tim7376875/Industry-university-coope-Stepper-motor-drive-circuit-design-and-controlration-/03 韌體控制程式/02 第二季/07 P32_馬達正轉360度(30rpm)/07 P32_馬達正轉360度(30rpm).PNG

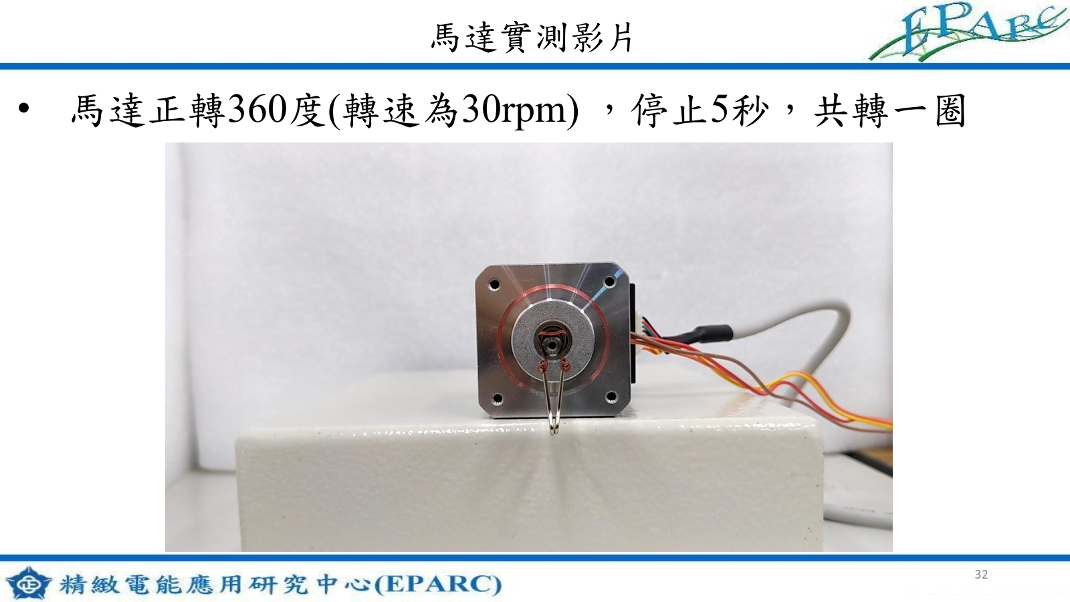
03 韌體控制程式/02 第二季/07 P32_馬達正轉360度(30rpm)/07 P32_馬達正轉360度(30rpm).PNG
