tim7376875/Industry-university-coope-Stepper-motor-drive-circuit-design-and-controlration-/README.md

01 簡報資料
	第一季產學報告.pdf
	第二季產學報告.pdf
	第三季產學報告.pdf
	第四季產學報告.pdf
	第五季產學報告.pdf

02 硬體電路Layout  (資料夾中有各季的Layout)
	01_第一季
	02_第二季
	03_第三季
	04_第四季
	05_第五季

03 軟體控制程式  (根據各季所做實驗與程式，各資料夾中有「程式」、「簡報截圖」)
	01_第一季
	02_第二季
	03_第三季
	04_第四季
	05_第五季
