tim7376875/Industry-university-coope-Stepper-motor-drive-circuit-design-and-controlration-/01 簡報資料/01_第一季產學報告.pdf

# 步進馬達一對八驅動電路 與控制研發計畫 第一季報告

報告人：黃偉智

指導教授：余國瑞 博士

報告日期：民國111年5月12日

### Outline

1. 馬達、編碼器、驅動晶片、控制晶片、開發板採購
2. 馬達驅動電路製作
3. 控制電路製作
4. 開發板介紹
5. 訊號實測

### Outline

1. 馬達、編碼器、驅動晶片、控制晶片、開發板採購
2. 馬達驅動電路製作
3. 控制電路製作

4.開發板介紹

5. 訊號實測

## 馬達與編碼器採購

- 馬達型號: ST4118M1404B、ST4118M1804B
- 購買公司: Nanotec大中華代理( 纳诺达克电子（常州）有限公司)
- 馬達交期: 15~18週
- 馬達預計到貨日期: 民國111年7月13日 (未到貨)
- 數量:包含馬達(各10個)、編碼器(20個) 、零組件
- 付款日期:民國111年3月30日於臺灣銀行匯款完成。

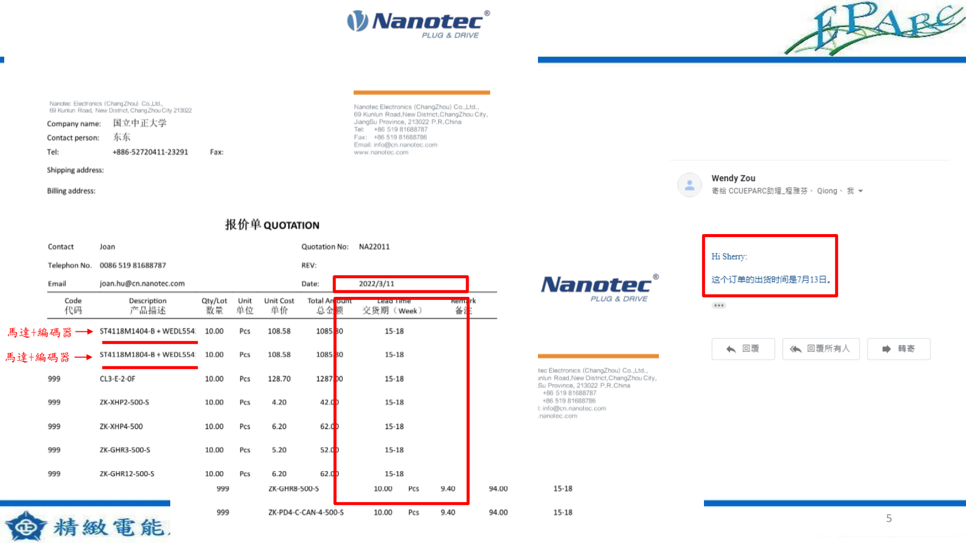
[picture p27: page 5]

馬達

+編碼器

馬達

+編碼器

ST4118M1404B + WEDL5541B14 | 馬達+編碼器
ST4118M1804B + WEDL5541B14 | 馬達+編碼器
CL3E20F | 控制板
ZKXHP2500S | 電源線
ZKXHP4500 | 電機轉接線
ZKGHR3500S | RS232通訊線
ZKGHR12500S | I/O線
ZKGHR8500S | 編碼器線
ZKPD4CCAN4500S | Can通訊線

### 採購列表

## 驅動晶片採購

驅動晶片型號: DRV8424PPWPR
購買廠商: 臺灣金電子(10個)、Mouser electronics(25個) 數量:臺灣金電子: 共10個。
Mouser electronics:共25個。
預計到貨日期:
臺灣金電子:民國111年4月7日(已到貨)
Mouser electronics:民國111年6月30日 (未到貨)

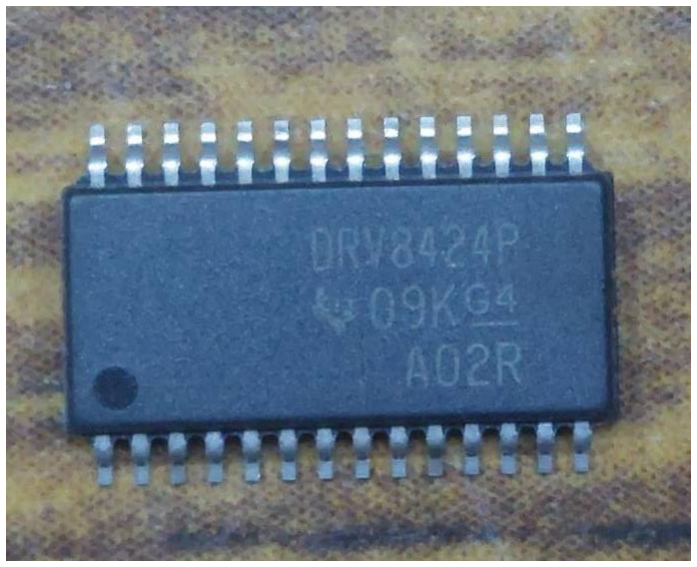
[picture p28: figure]
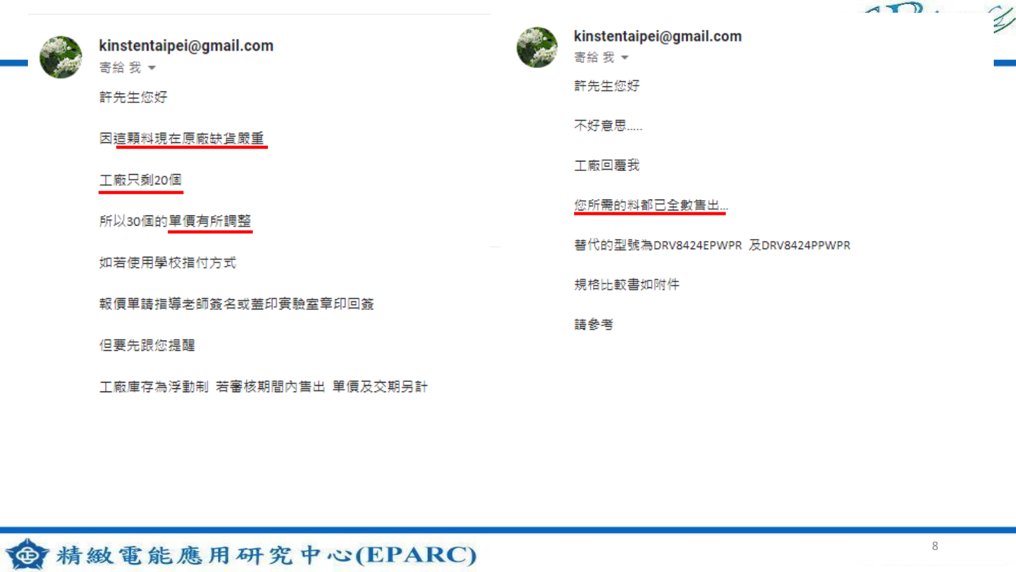
[picture p29: page 8]

晶片什麼時候到放這裡

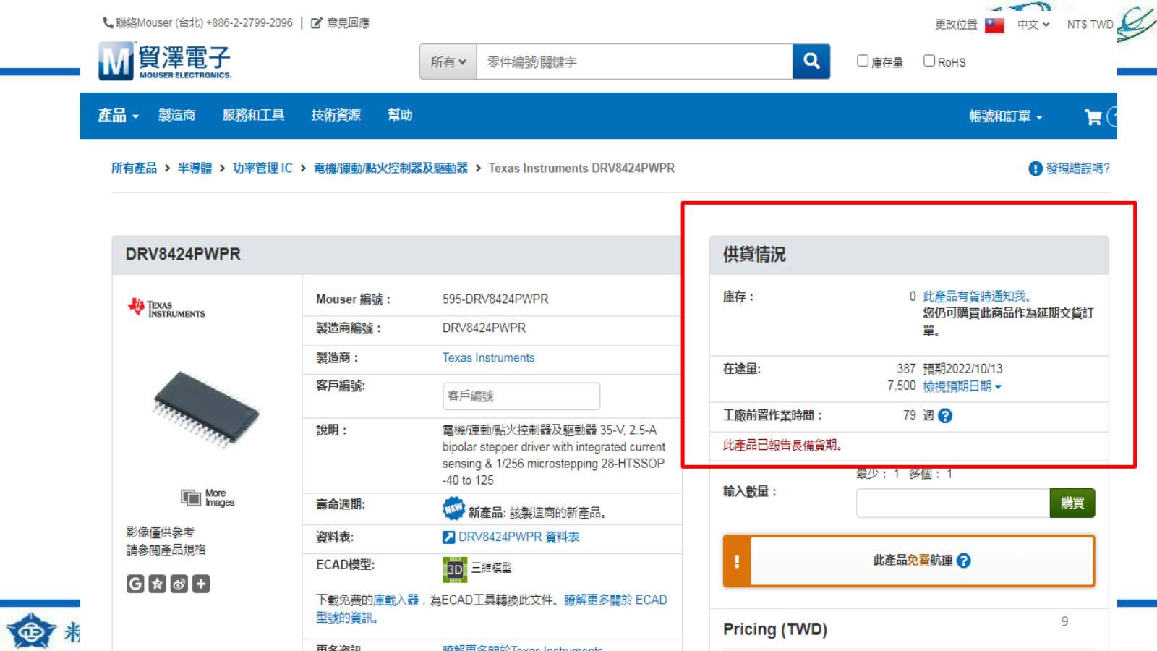
[picture p30: page 9]
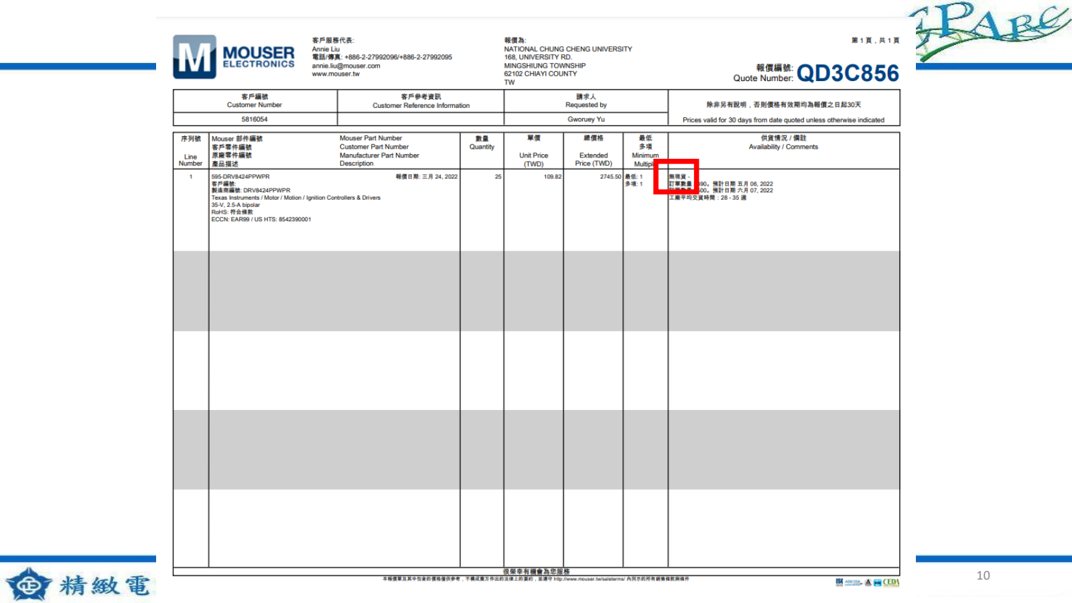
[picture p31: page 10]

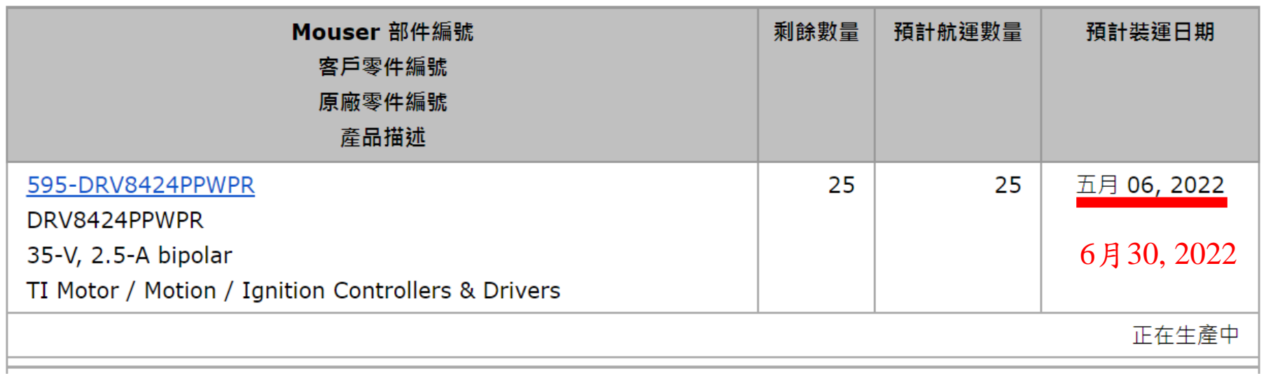
[picture p32: figure]

### DRV8424PPWPR

- 雙H橋馬達驅動晶片
- 裝置可用於驅動兩個DC馬達或一個雙極步進馬達。
- 驅動晶片本身具有兩個H橋的NMOSFET、線性穩壓器、電流感測 器，以及保護電路。
- 保護電路功能有供電欠壓 (UVLO)、電荷泵欠壓 (CPUV)、輸出過 電流 (OCP) 和裝置過熱 (TSD)的檢測。

## 驅動晶片介紹

### 控制晶片採購

- 控制晶片型號: TMS320F28069
- 購買公司: 馬唯科技
- 數量:共20個
- 出貨日期: 民國111年3月30日(已到貨)

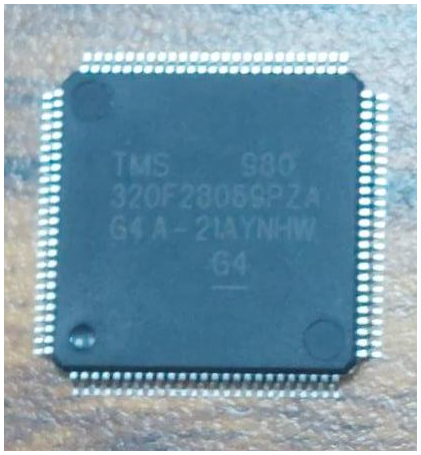
[picture p33: figure]
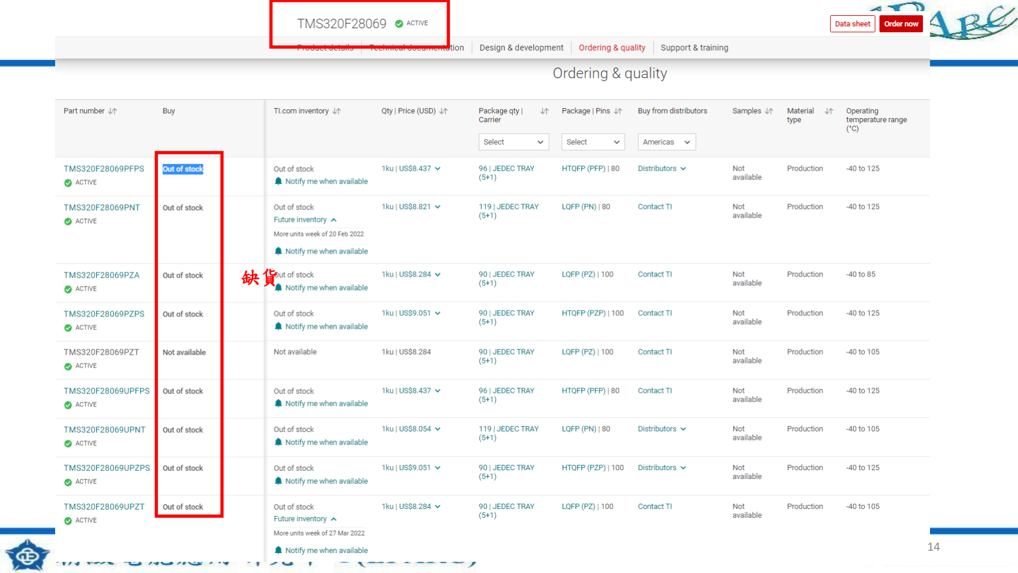
[picture p34: page 14]

缺貨

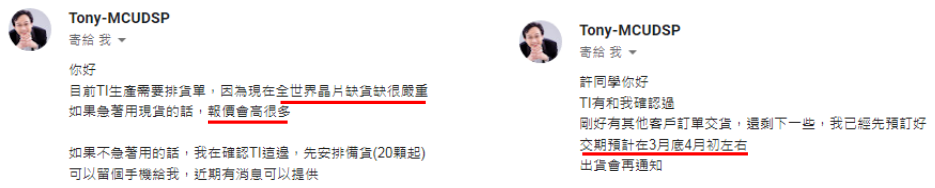
[picture p35: figure]

### TMS320F28069介紹

項目 | 功能
核心 | | 32位元微控制器
電源電壓 | 3.3V
暫存器 | 256k bytes Flash 100k bytes RAM 2k bytes ROM

周邊功能腳位

58個I/O埠
16個12位元的A/D轉換通道
16個PWM通道數
6個外部中斷
內建溫度感測器
通訊方式 | UART、CAN、SPI、I

2C等

### TI馬達驅動開發板採購

- 開發板型號: DRV8424PEVM
- 購買公司: Mouser electronics
- 數量: 1個
- 預計到貨日期:民國111年4月1日(已到貨)

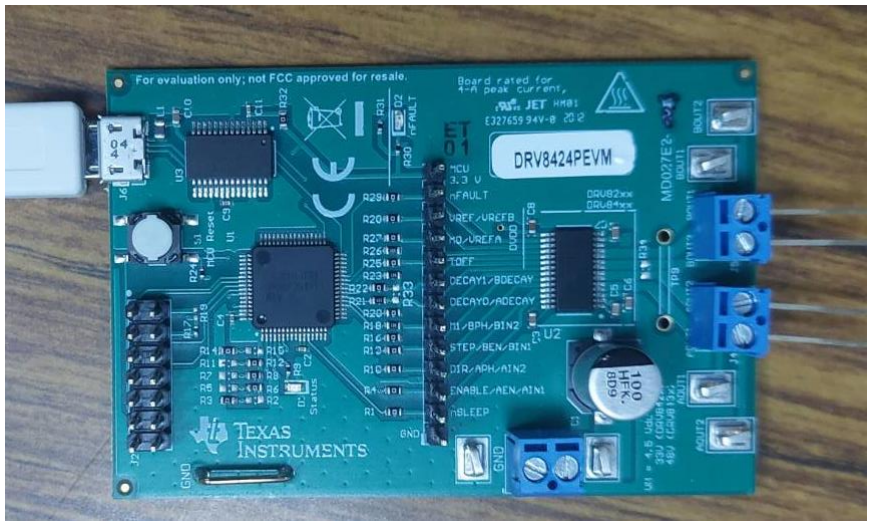
[picture p36: figure]

- DRV8424PPWPR之開發板
- 使用 4.5 至 33V 的直流電壓供電。
- Micro USB-type b接口。
- 16bit MCU。

### Outline

1. 馬達、編碼器、驅動晶片、控制晶片、開發板採購
2. 馬達驅動電路製作
3. 控制電路製作

4.開發板介紹

5. 訊號實測

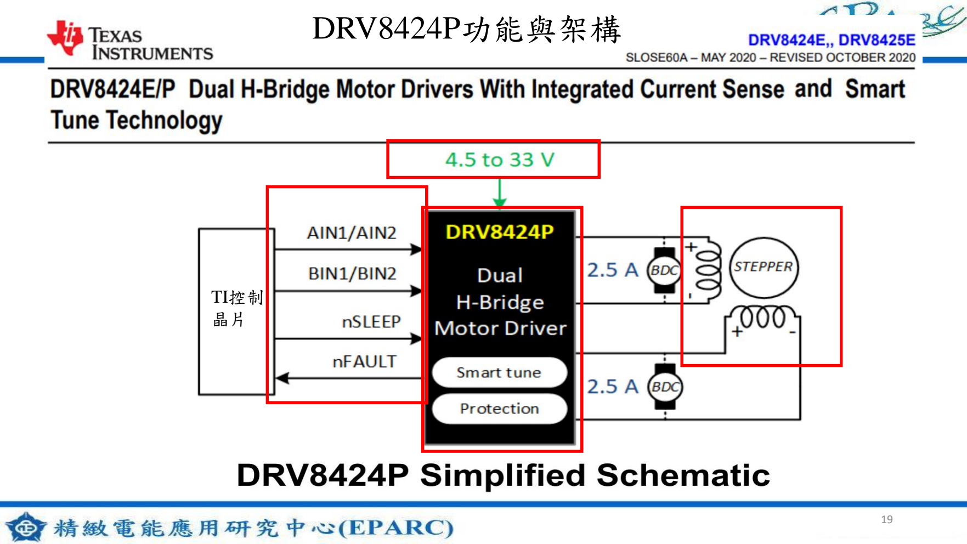
[picture p37: page 19]

TI控制
晶片

DRV8424P功能與架構

STEP | AIN1 | BIN1 | AIN2 | BIN2
1 | + | + | - | -
2 | - | + | + | -
3 | - | - | + | +
4 | + | - | - | +

### 馬達真值表

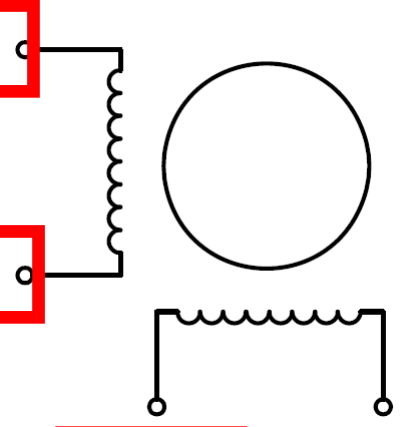
[picture p38: figure]

AIN1

AIN2

BIN1 BIN2

### 實驗室自行設計之驅動板介紹

軟體: Altium designer
電路板層數: 雙層
使用元件:
1. 驅動晶片DRV8424PPWPR
2. DIP電容、0805封裝SMD電容
3. 0805封裝SMD電阻
4. 測量點
5. 2.54mm排針、端子座

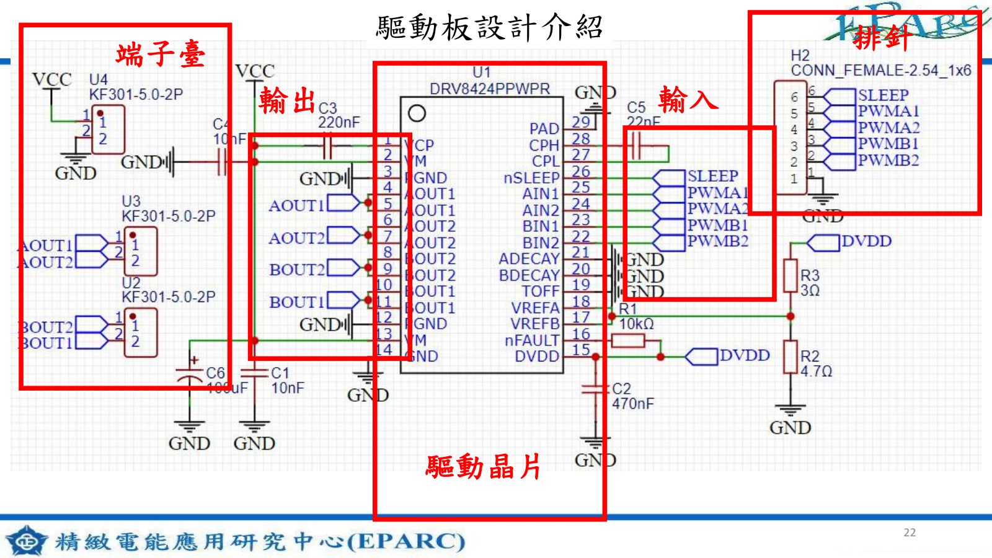
[picture p39: page 22]

驅動晶片

輸出 | 輸入

排針 端子臺

驅動板設計介紹

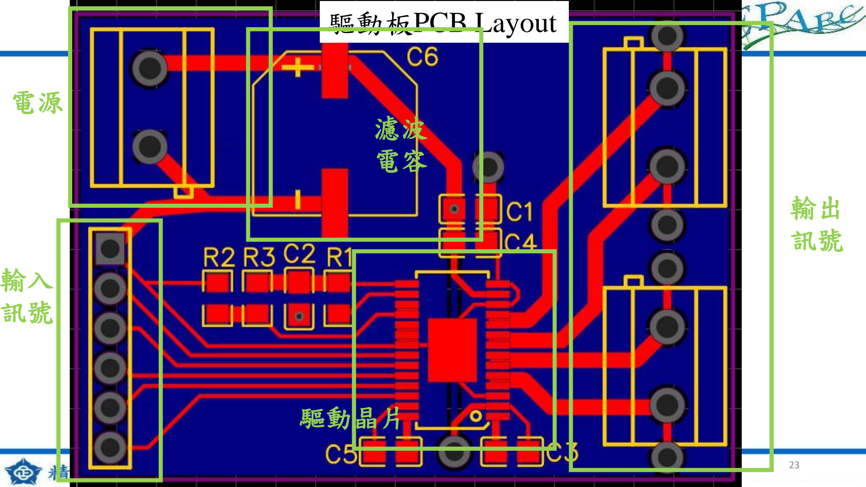
[picture p40: page 23]

電源

輸入
訊號

輸出
訊號

驅動晶片

濾波
電容

驅動板PCB Layout

### 製作步驟

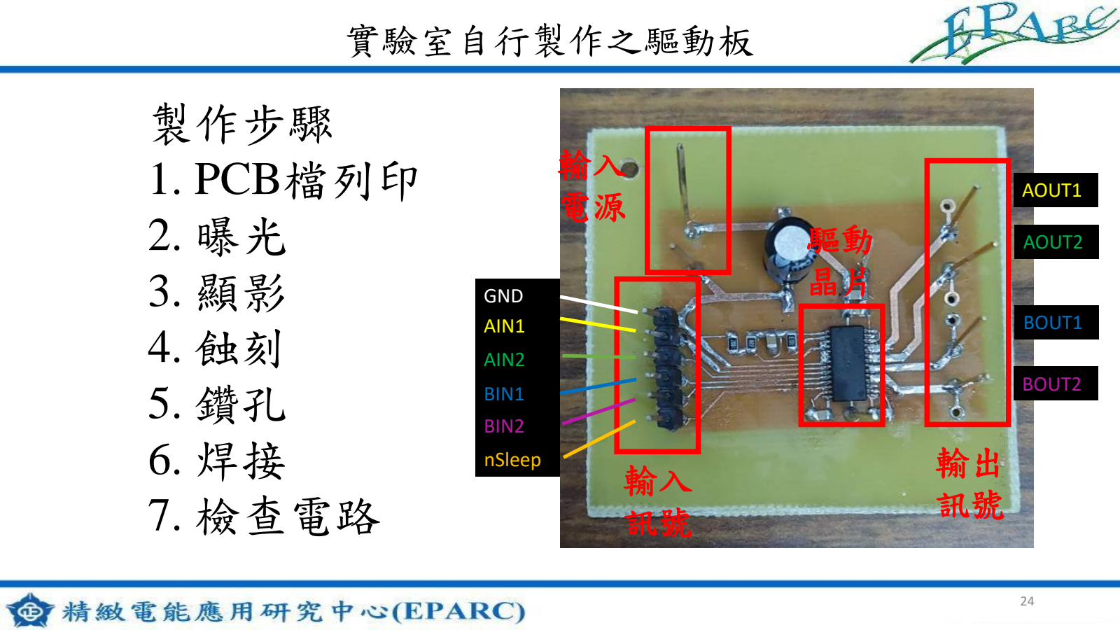
[picture p41: page 24]

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
實驗室自行製作之驅動板

1. PCB檔列印
2. 曝光
3. 顯影
4. 蝕刻
5. 鑽孔
6. 焊接

### 7. 檢查電路

AOUT1

AOUT2

BOUT1

BOUT2

AIN1
AIN2
BIN1
BIN2

GND

nSleep

### Outline

1. 馬達、編碼器、驅動晶片、控制晶片、開發板採購
2. 馬達驅動電路製作
3. 控制電路製作

4.開發板介紹

5. 訊號實測

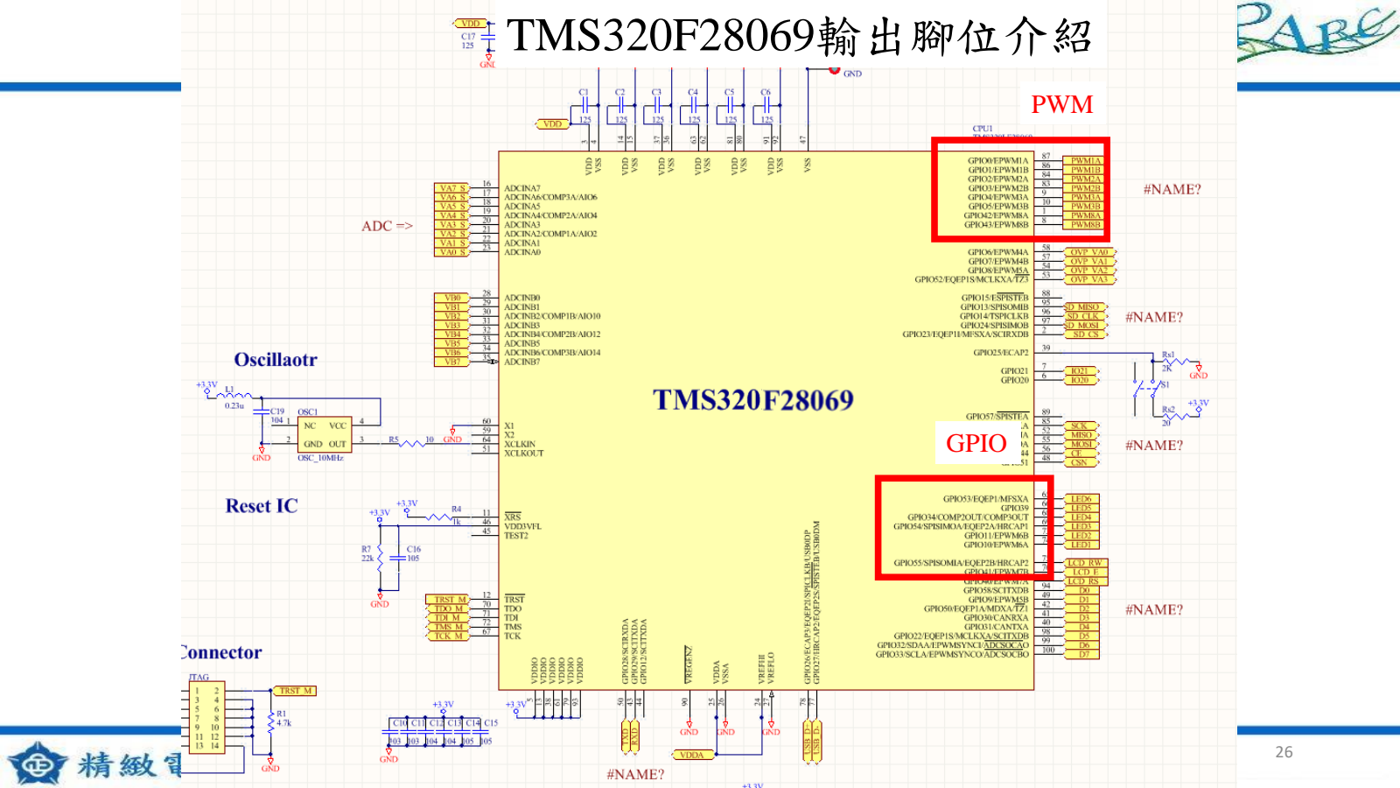
[picture p42: page 26]

PWM

GPIO

TMS320F28069輸出腳位介紹

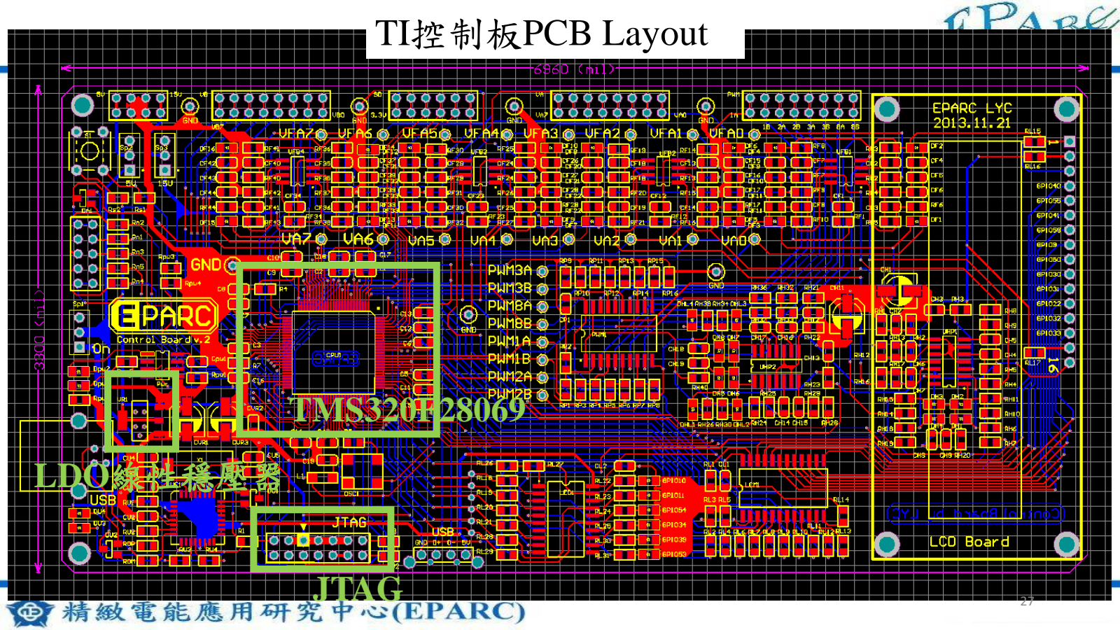
[picture p43: page 27]

TMS320F28069

LDO線性穩壓器

JTAG

TI控制板PCB Layout

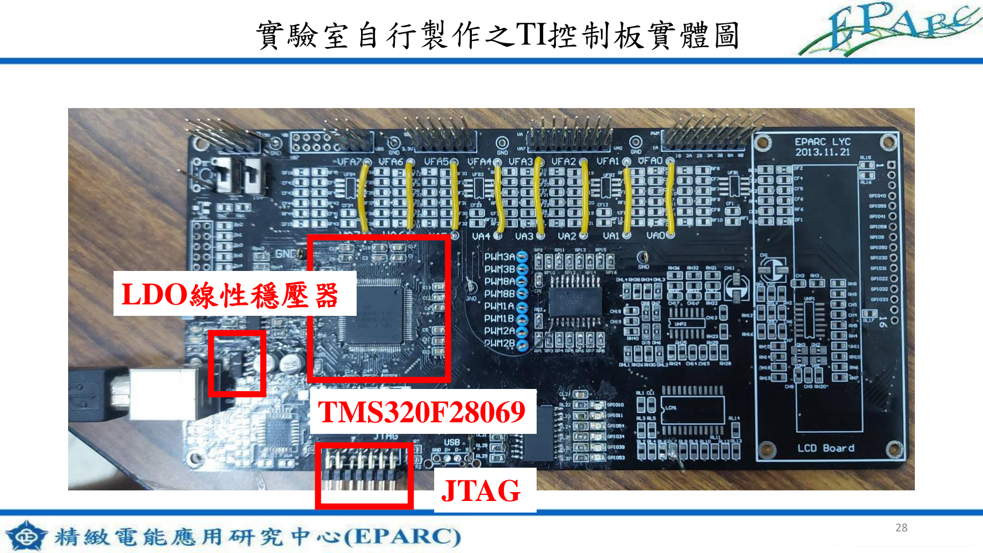
[picture p44: page 28]

實驗室自行製作之TI控制板實體圖

TMS320F28069

LDO線性穩壓器

JTAG

### Outline

1. 馬達、編碼器、驅動晶片、控制晶片、開發板採購
2. 馬達驅動電路製作
3. 控制電路製作

4.開發板介紹

5. 訊號實測

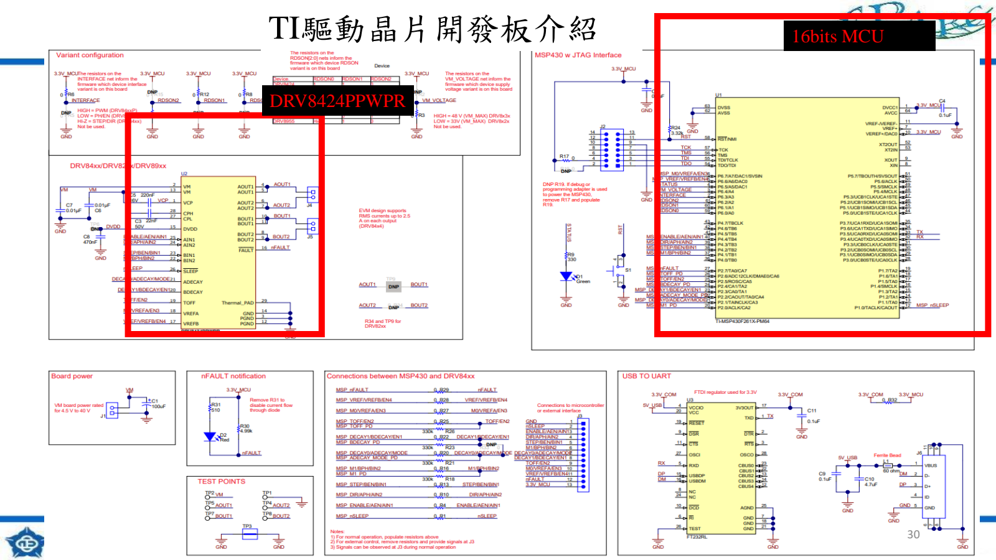
[picture p45: page 30]

16bits MCU

DRV8424PPWPR

TI驅動晶片開發板介紹

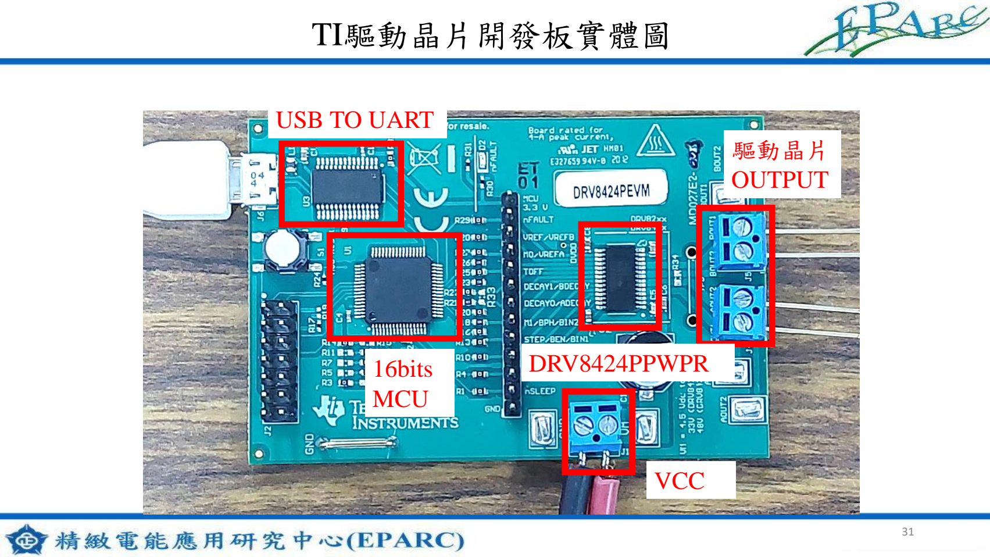
[picture p46: page 31]

TI驅動晶片開發板實體圖

VCC

驅動晶片
OUTPUT
16bits | DRV8424PPWPR
MCU

USB TO UART

開發板配套之TI圖形化介面

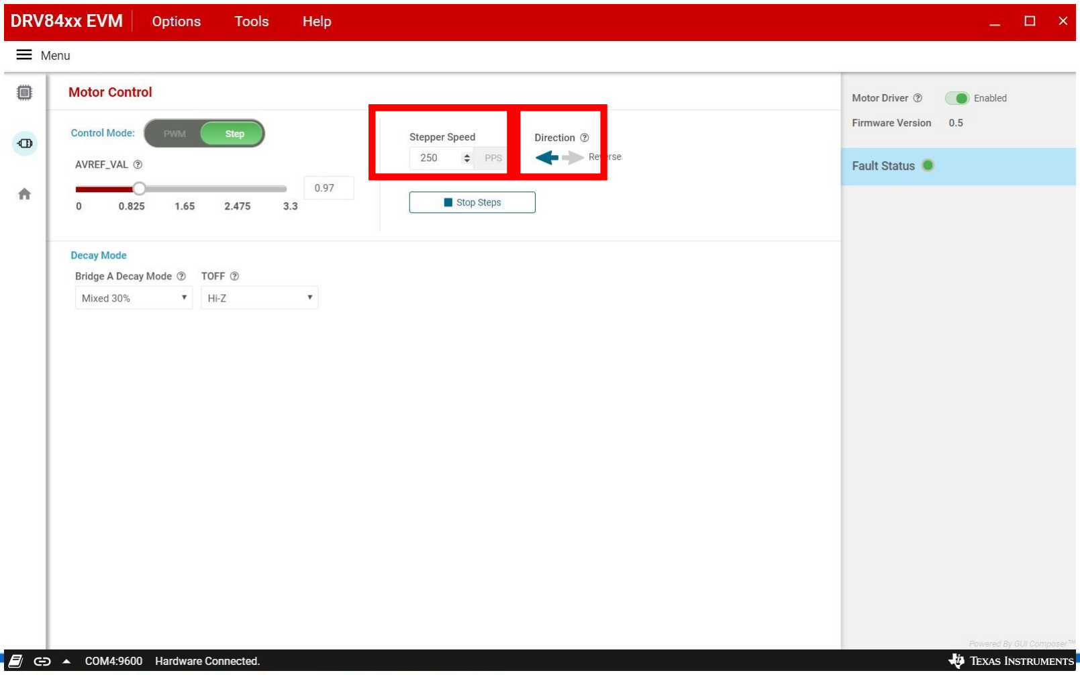
[picture p47: figure]

### Outline

1. 馬達、編碼器、驅動晶片、控制晶片、開發板採購
2. 馬達驅動電路製作
3. 控制電路製作

4.開發板介紹

5. 訊號實測

直流可調電源供應器

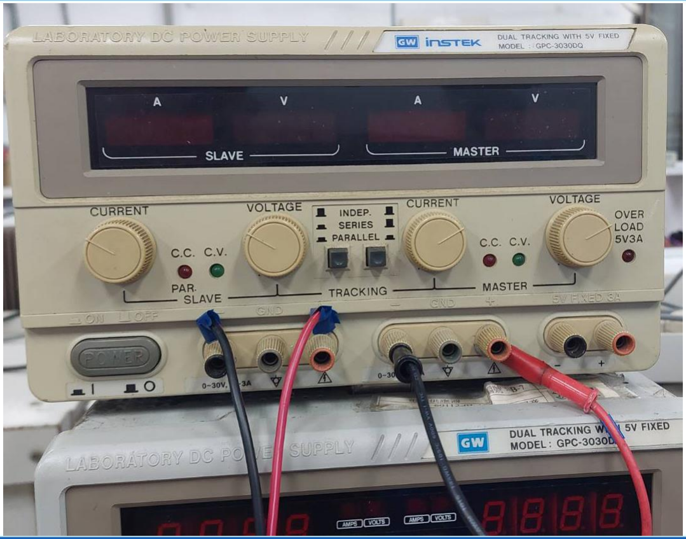
[picture p48: figure]
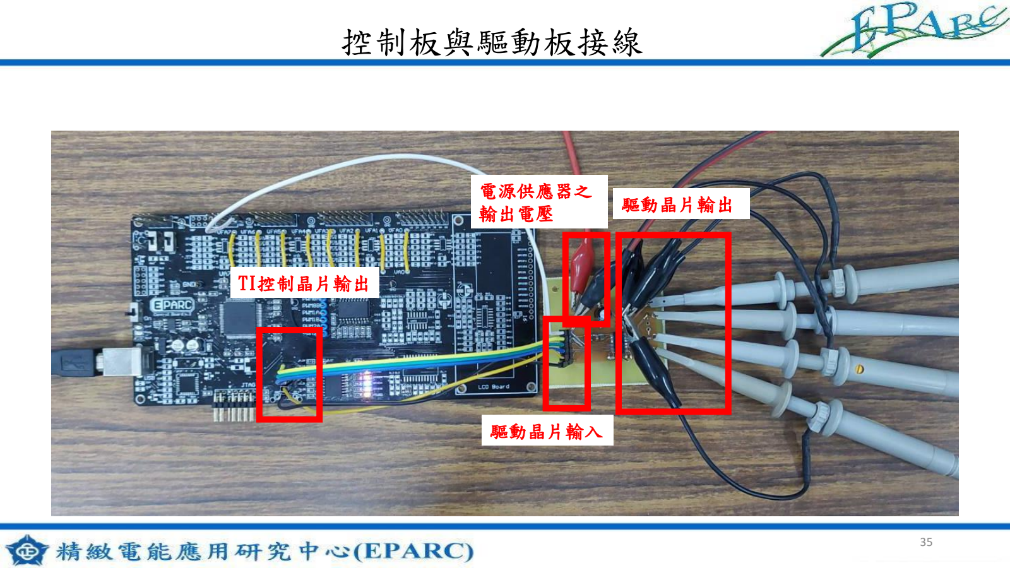
[picture p49: page 35]

控制板與驅動板接線

TI控制晶片輸出

驅動晶片輸出

電源供應器之
輸出電壓

驅動晶片輸入

示波器與實驗波型

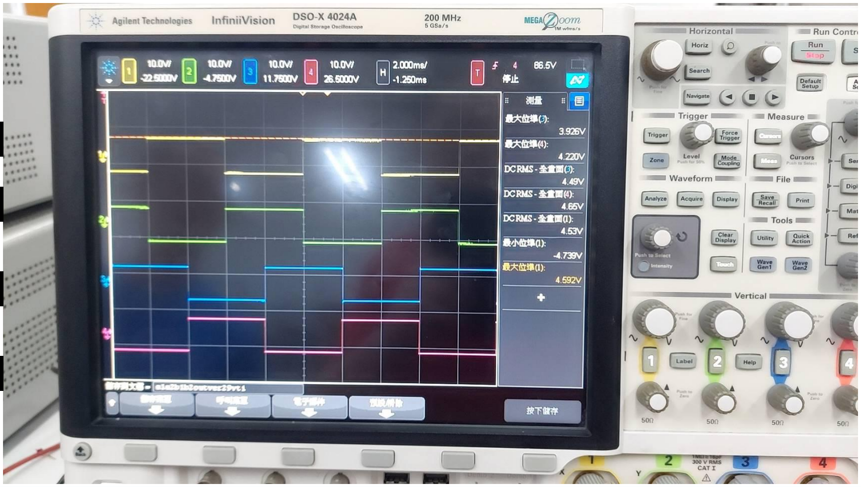
[picture p50: figure]

AOUT1

AOUT2

BOUT1

BOUT2

### 驅動晶片輸入訊號量測流程

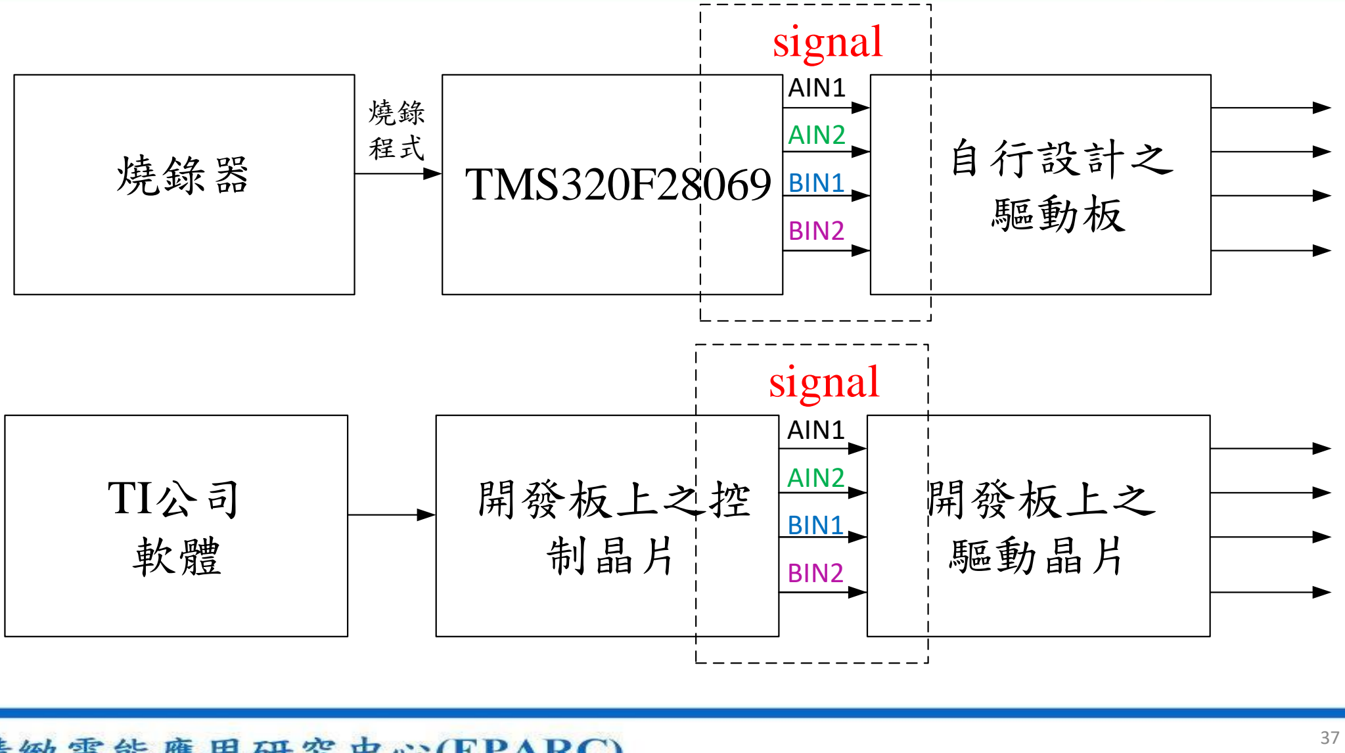
[picture p51: figure]
燒錄器; TMS320F28069; 自行設計之; 驅動版; signal signal; TI公司 軟體; 開發板上之控 制晶片; 開發板上之; 驅動晶片; AIN1; AIN2; BIN1; BIN2

### 驅動晶片輸入訊號比較

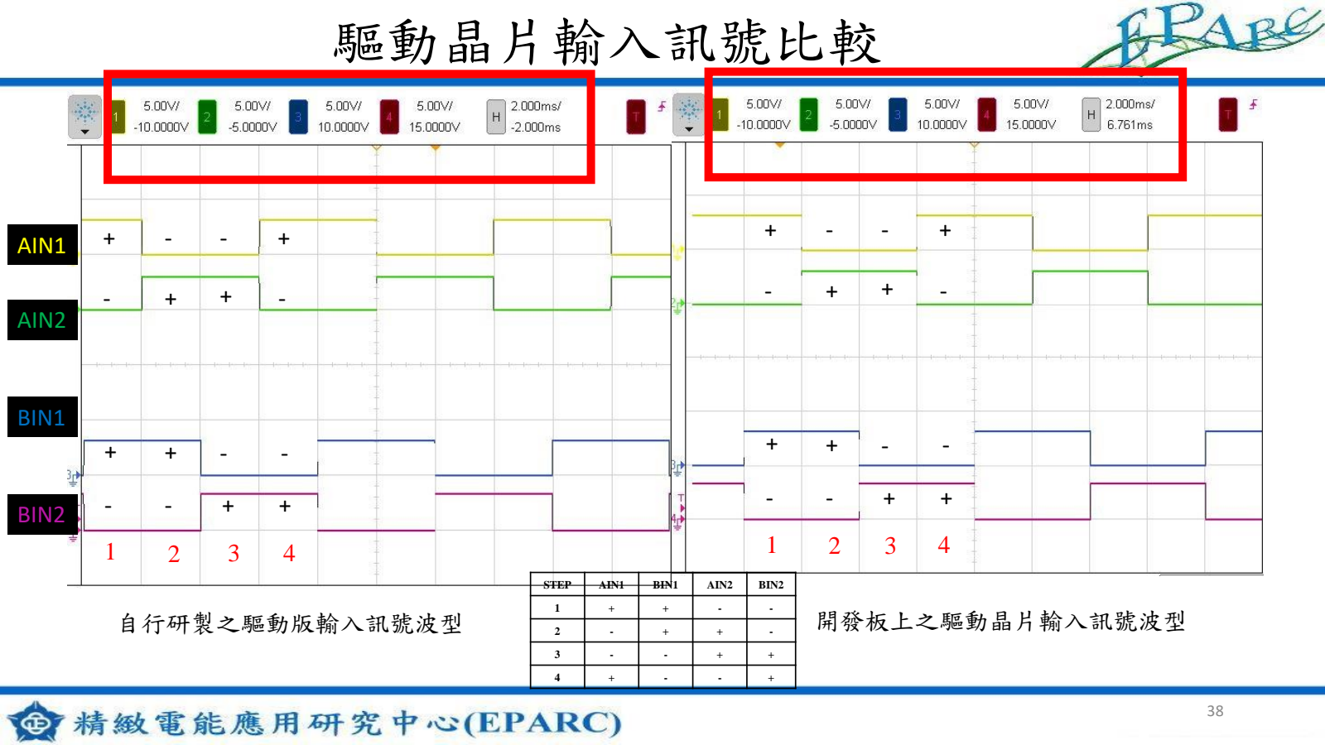
[picture p52: page 38]

自行研製之驅動版輸入訊號波型 | 開發板上之驅動晶片輸入訊號波型

AIN1

AIN2

BIN1

BIN2

+

+

+ | - | -
- | + | +

+

+

+

+

+

+ | - | -
- | + | +

+

+

+

1

1 2 | 3 | 4
2 | 3 | 4
STEP | AIN1 | BIN1 | AIN2 | BIN2
1 | + | + | - | -
2 | - | + | + | -
3 | - | - | + | +
4 | + | - | - | +

### 驅動晶片輸出訊號量測流程

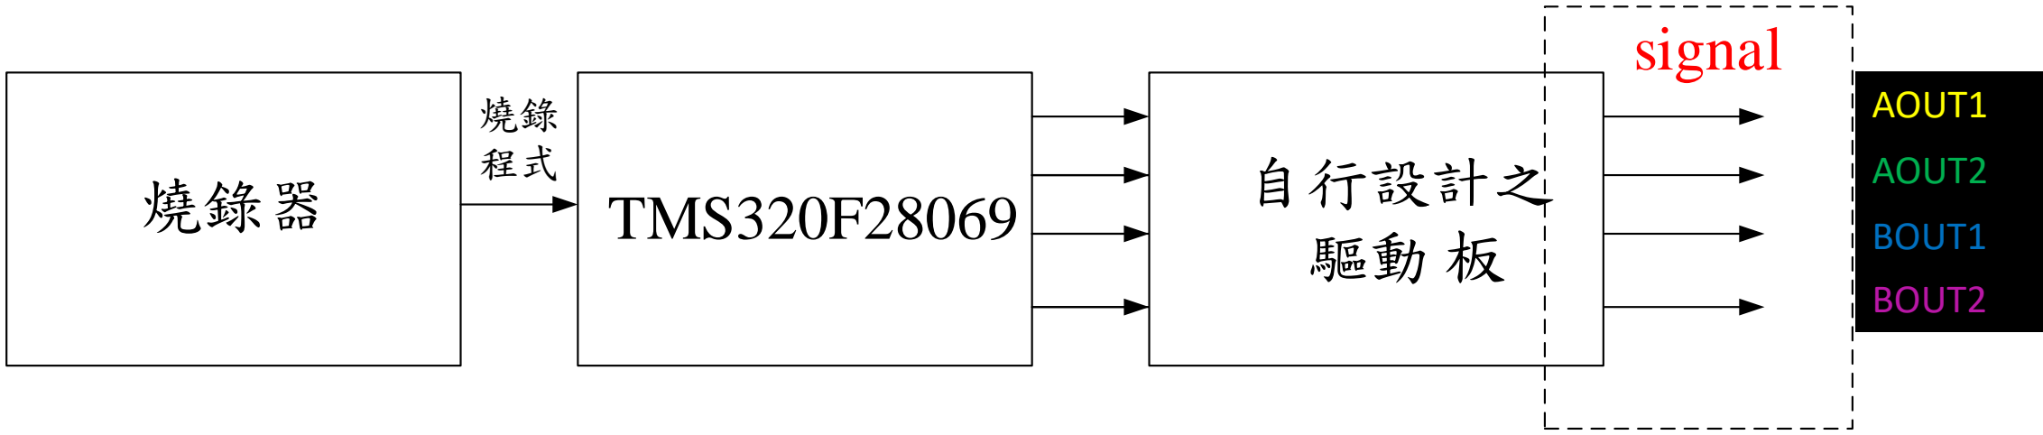
[picture p53: figure]
燒錄器; TMS320F28069; 自行設計之; 驅動版; signal; AOUT1; AOUT2; BOUT1; BOUT2
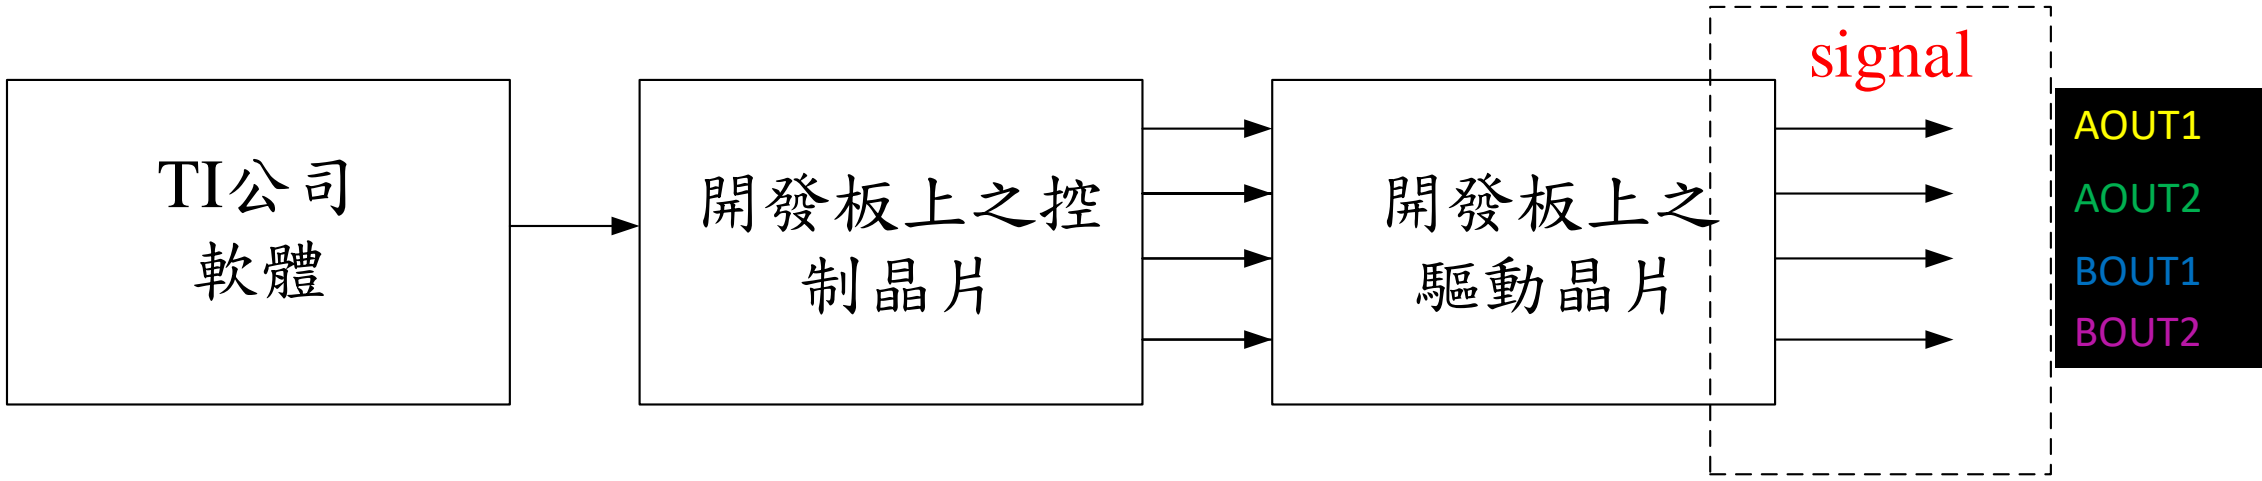
[picture p54: figure]
TI公司 軟體; 開發板上之控 制晶片; 開發板上之 驅動晶片; signal; AOUT1; AOUT2; BOUT1 BOUT2

### 驅動晶片輸出訊號比較

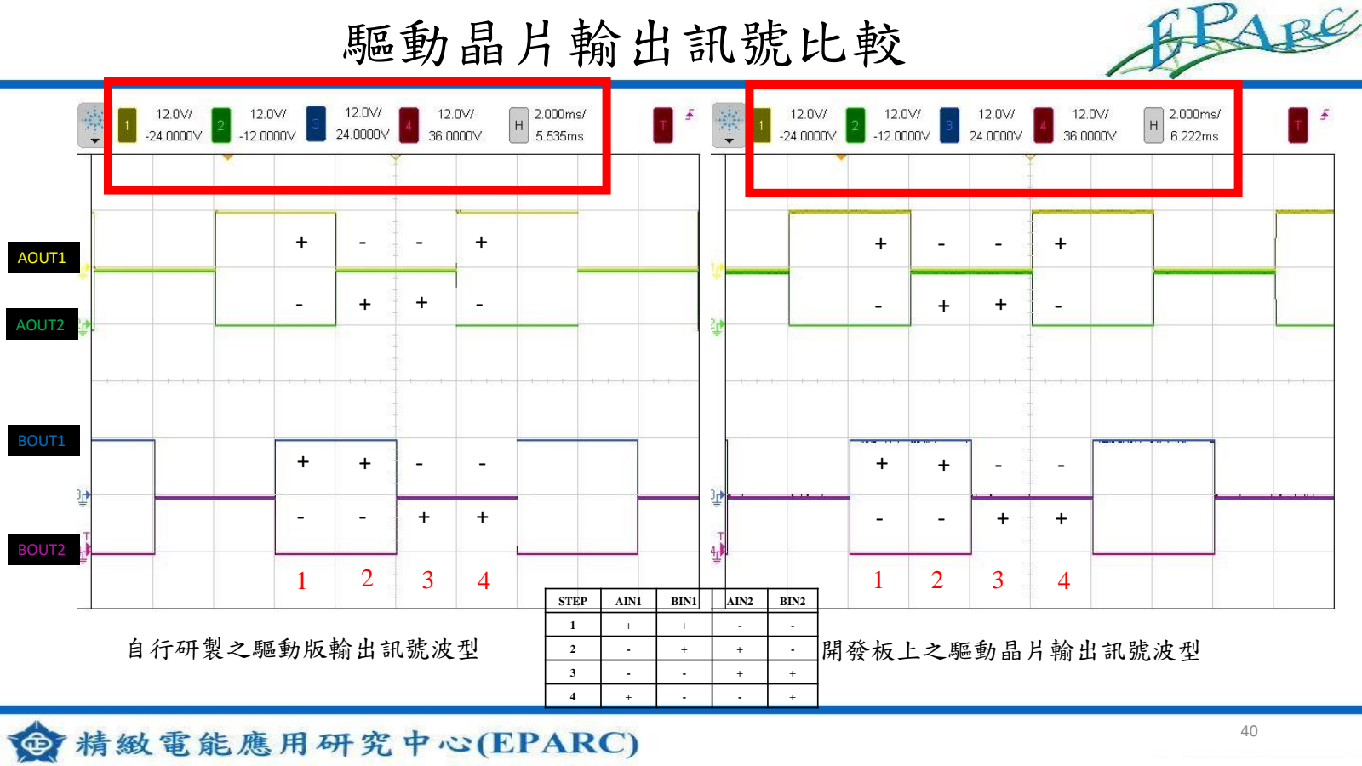
[picture p55: page 40]

自行研製之驅動版輸出訊號波型 | 開發板上之驅動晶片輸出訊號波型

AOUT1

AOUT2

BOUT1

BOUT2

+

+

+ | - | -
- | + | +

+

+

+

+

+

+ | - | -
- | + | +

+

+

+

1 | 2 | 3 | 4 | 1 | 2 | 3 | 4
STEP | AIN1 | BIN1 | AIN2 | BIN2
1 | + | + | - | -
2 | - | + | + | -
3 | - | - | + | +
4 | + | - | - | +

## 未來工作

1.驅動板優化:新增nFault腳位、DIP電容換成SMD電容、排針改成 端子座。
2.馬達到貨後，接上步進馬達進行驅動實測。
3.控制板與驅動板進行整合。

Thanks for listening.

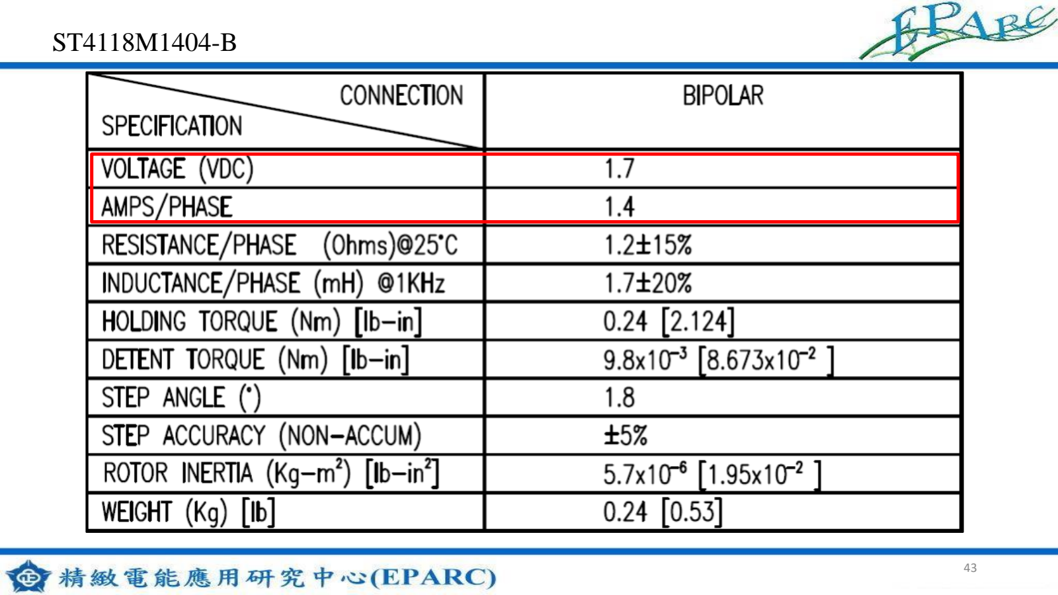
[picture p56: page 43]

ST4118M1404-B

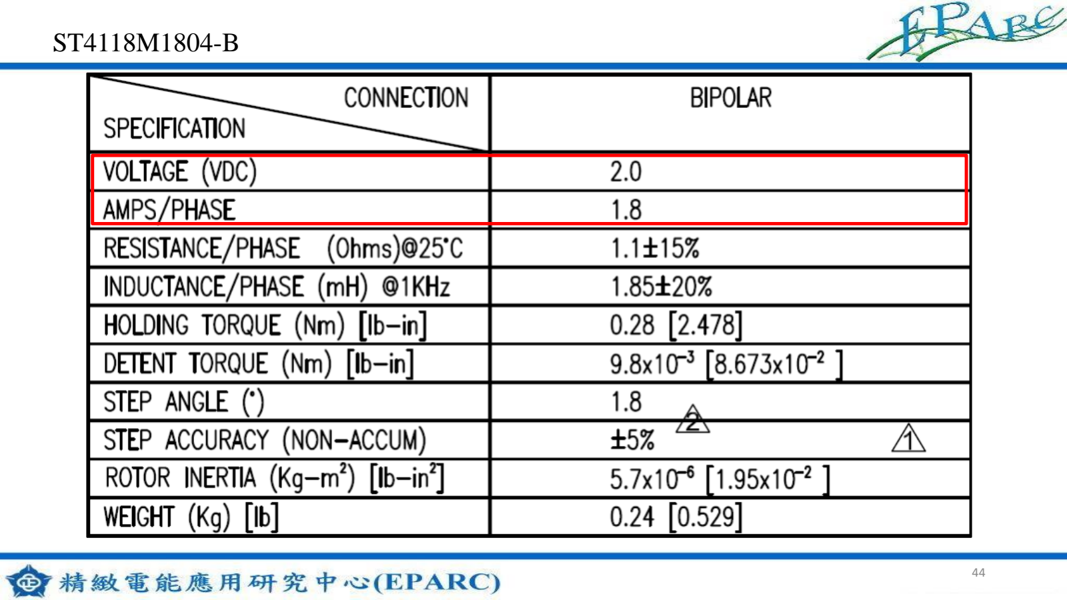
[picture p57: page 44]

ST4118M1804-B
