tim7376875/Industry-university-coope-Stepper-motor-drive-circuit-design-and-controlration-/01 簡報資料/02_第二季產學報告.pdf

# 步進馬達一對八驅動電路 與控制研發計畫 第二季報告

## 報告人：陳廷宇、蕭崇仁

## 指導教授：余國瑞 博士

## 報告日期：民國111年8月11日

大綱

# 1. 到貨狀況

# 2. 韌體與訊號量測

# 3. 整合電路實測

# 4. 馬達實測影片

# 5. 第一季未來工作執行現況

# 6. 第三季未來工作

# 1. 到貨狀況

大綱

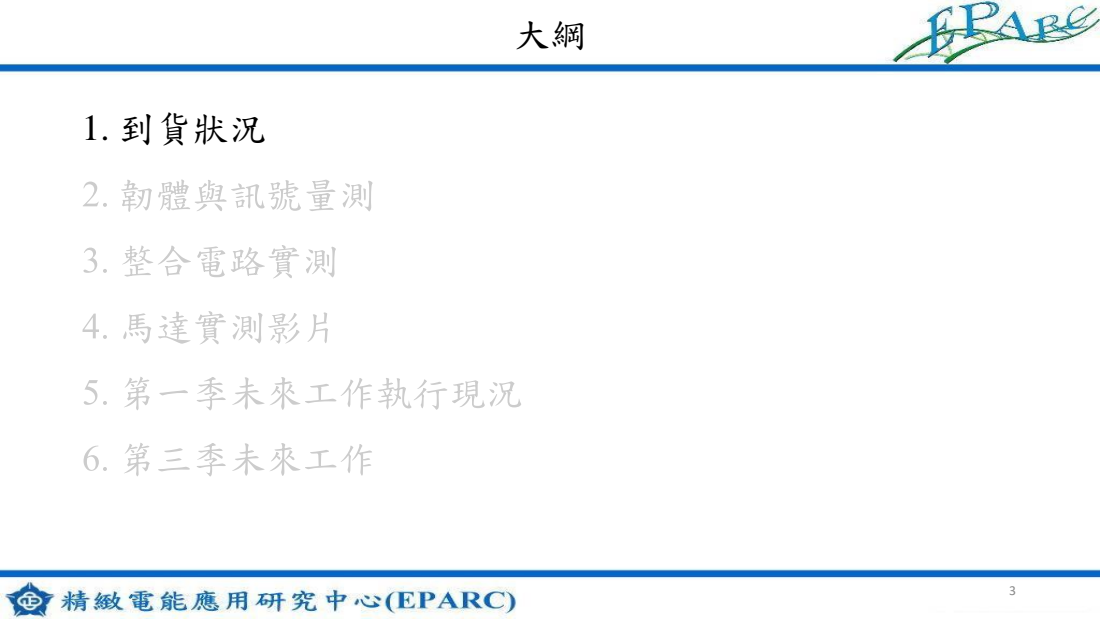
[picture p58: page 3]

# 驅動晶片

## 驅動晶片型號：DRV8424PPWPR

## 購買廠商：Mouser electronics(25個)

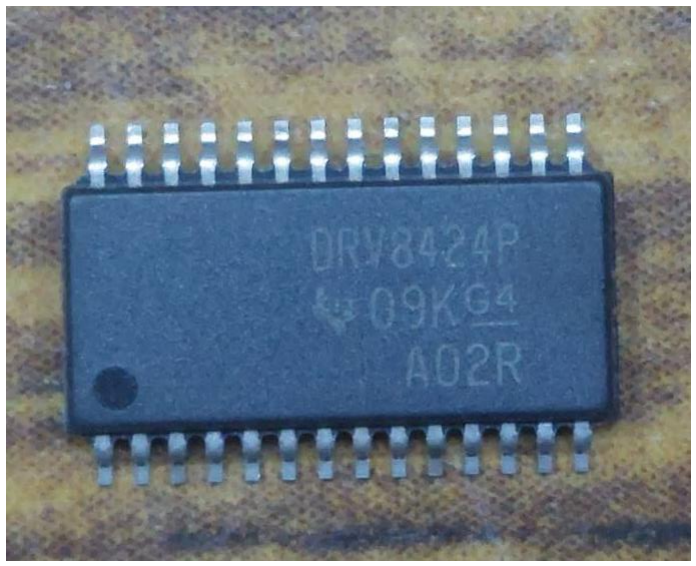
[picture p59: figure]

## 數量：Mouser electronics:共25個。

## 到貨日期：民國111年7月20日

民國111年7月20日

型號 | 中文名稱 | 數量
ST4118M1404B + WEDL5541B14 | 馬達+編碼器 | 10
ST4118M1804B + WEDL5541B14 | 馬達+編碼器 | 10
CL3E20F | 控制板 | 10
ZKXHP2500S | 電源線 | 10
ZKXHP4500 | 電機轉接線 | 10
ZKGHR3500S | RS232通訊線 | 10
ZKGHR12500S | I/O線 | 10
ZKGHR8500S | 編碼器線 | 10
ZKPD4CCAN4500S | Can通訊線 | 10

# 馬達到貨狀況

# - 7/29 申請免稅令在海關進行移倉作業 - 8/05 馬達到實驗室

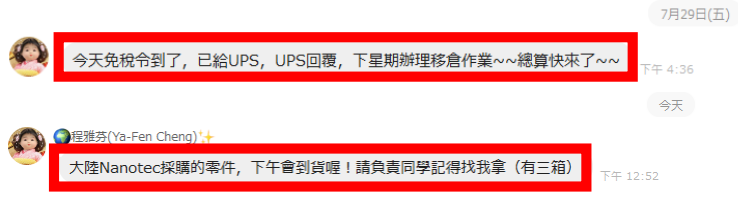
[picture p60: figure]

7/29
8/04

# 馬達到貨狀況

# 馬達到貨狀況

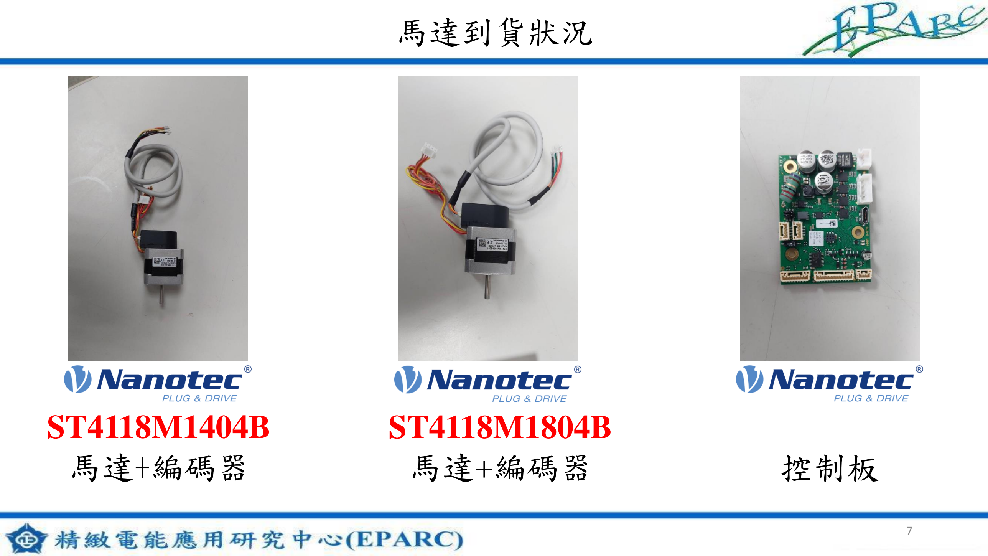
[picture p61: page 7]

## ST4118M1404B

# 馬達+編碼器

## ST4118M1804B

馬達+編碼器 | 控制板

## ST4118M1404B Datasheet

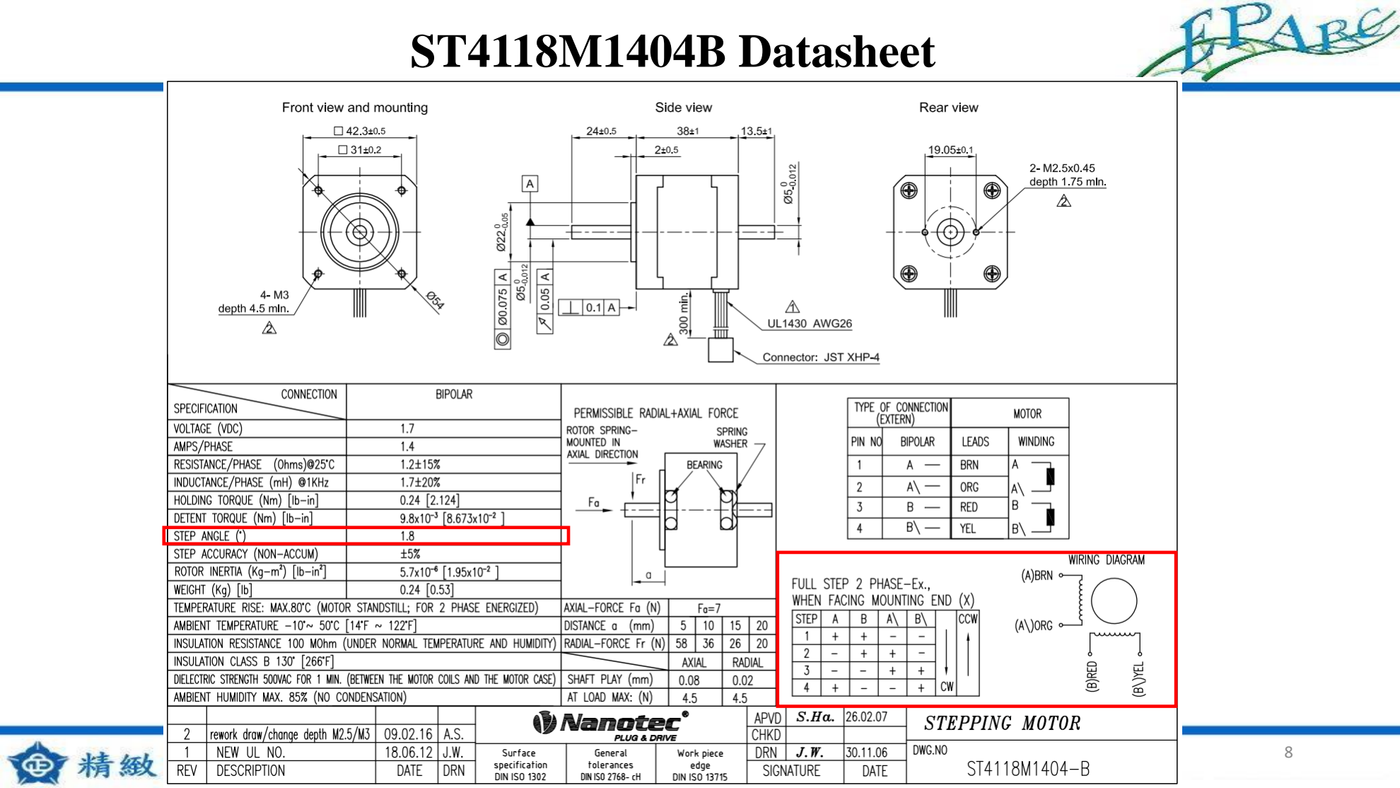
[picture p62: page 8]

## ST4118M1804B Datasheet

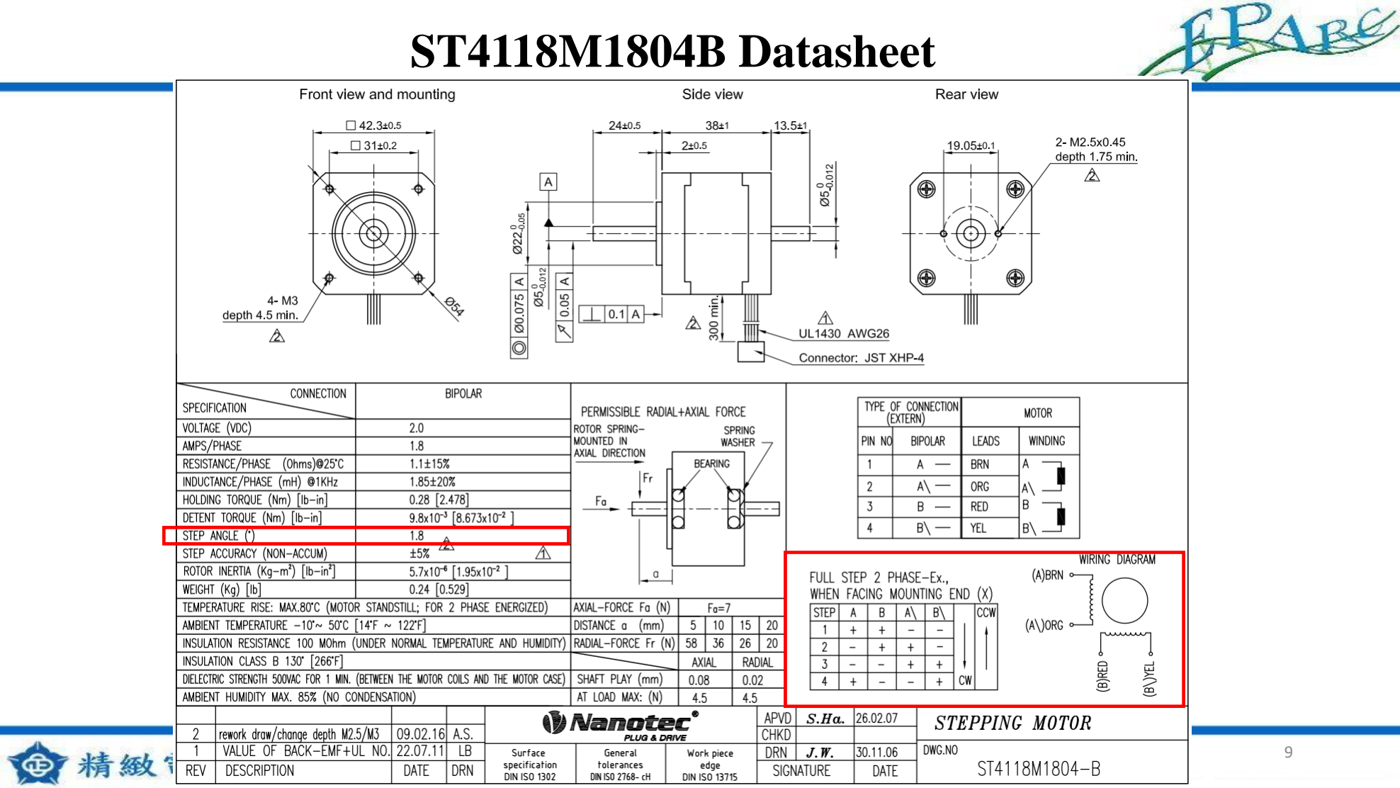
[picture p63: page 9]

# 馬達到貨狀況

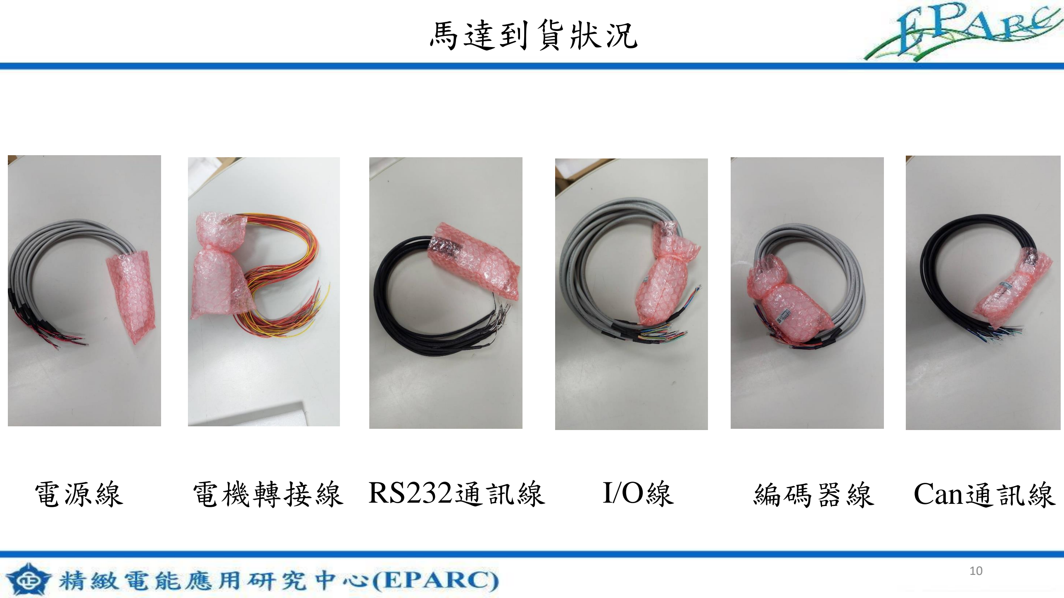
[picture p64: page 10]

電源線 | 電機轉接線 RS232通訊線 | I/O線 | 編碼器線 | Can通訊線

大綱

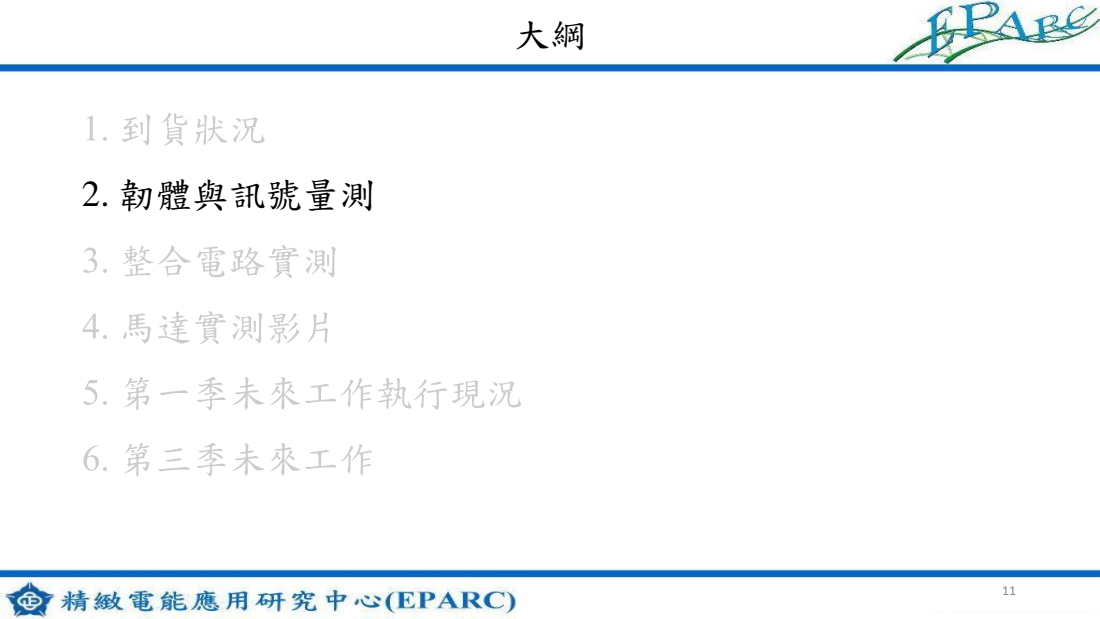
[picture p65: page 11]
2. 韌體與訊號量測

# 驅動晶片輸入訊號量測流程

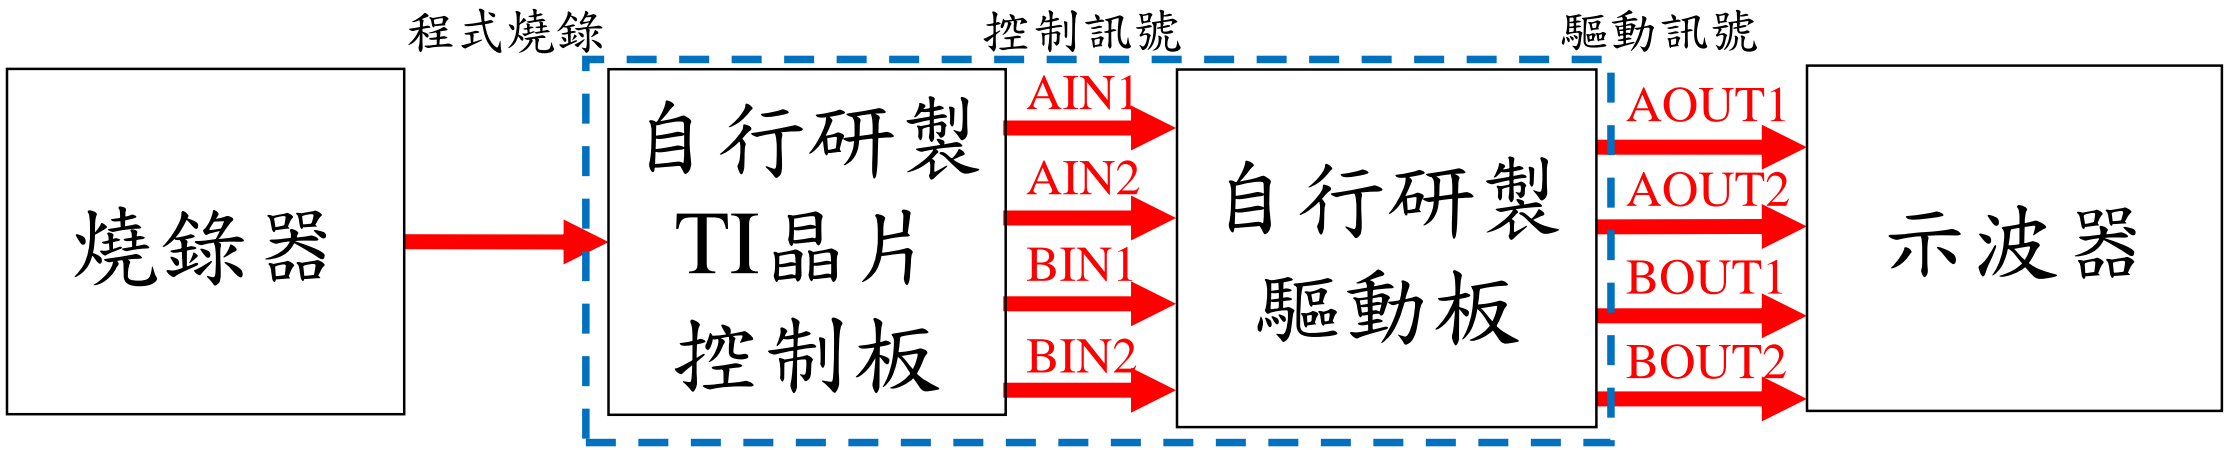
[picture p66: figure]
程式燒錄; 控制訊號; 驅動訊號; 燒錄器; 自行研製 TI晶片 控制板; 自行研製; 驅動板; 示波器; AIN1; AIN2; BIN1; BIN2; BOUT2; BOUT1; AOUT2; AOUT1

# 整合電路

## - 目的：設計馬達正轉、反轉與調整轉速之程式碼。

## GPIO數據暫存器

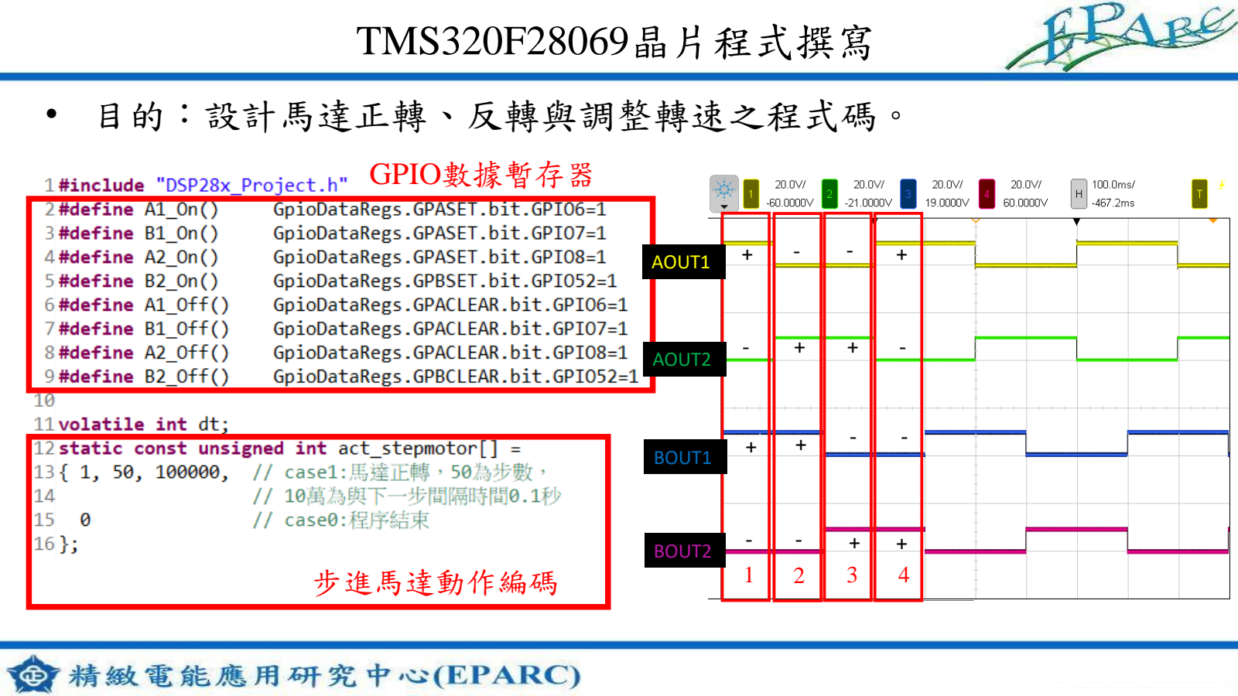
[picture p67: page 13]

## 步進馬達動作編碼

## TMS320F28069晶片程式撰寫

+

+

+ | - | -
- | + | +

+

+

+

1 | 2 | 3 | 4

AOUT1

AOUT2

BOUT1

BOUT2

## TMS320F28069晶片程式撰寫

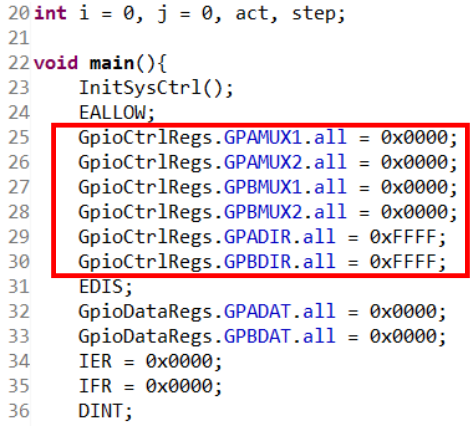
[picture p68: figure]

## GPIO控制暫存器

## TMS320F28069晶片程式撰寫

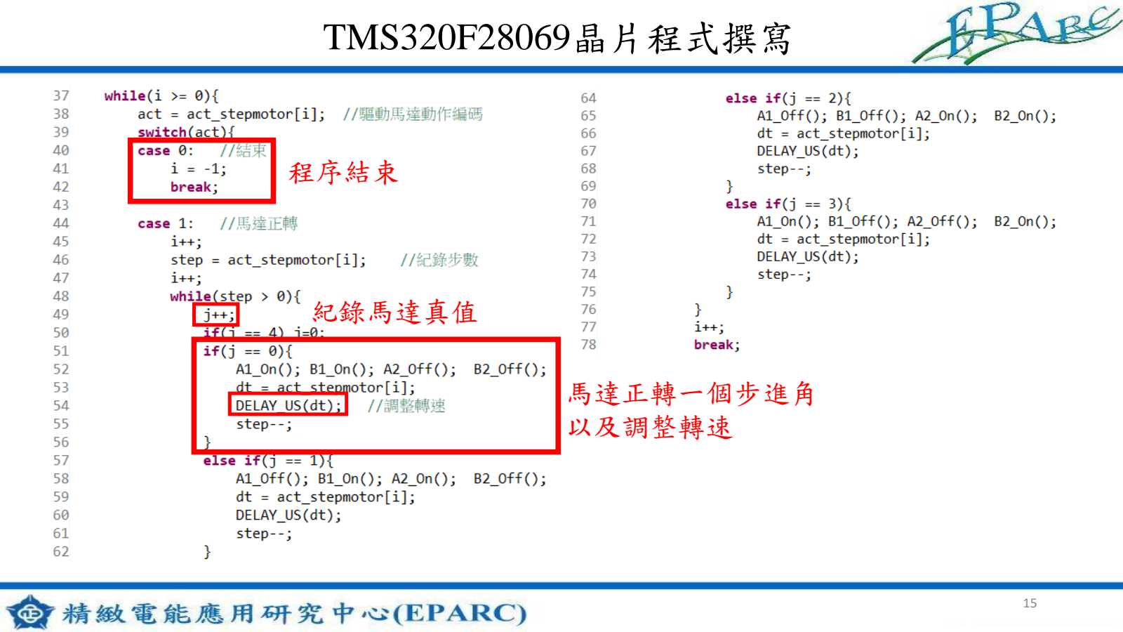
[picture p69: page 15]

## 程序結束

## 馬達正轉一個步進角 以及調整轉速

## 紀錄馬達真值

## TMS320F28069晶片程式撰寫

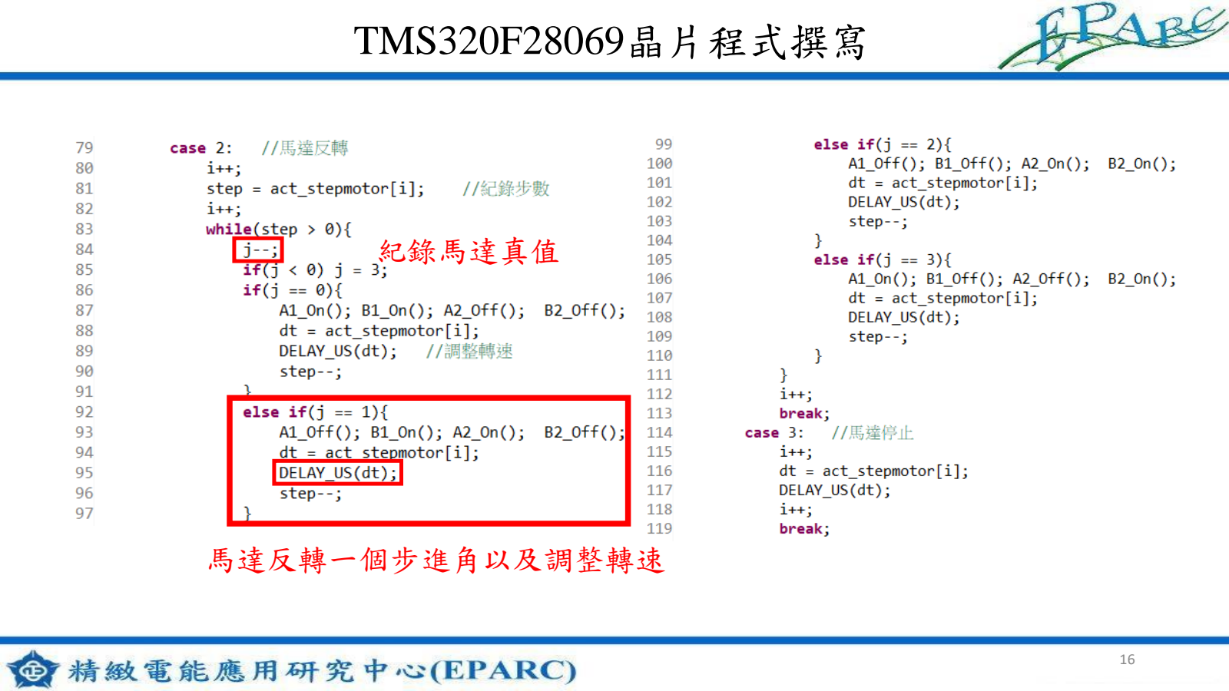
[picture p70: page 16]

## 馬達反轉一個步進角以及調整轉速

## 紀錄馬達真值

# 示波器波型

## - 正轉波型：

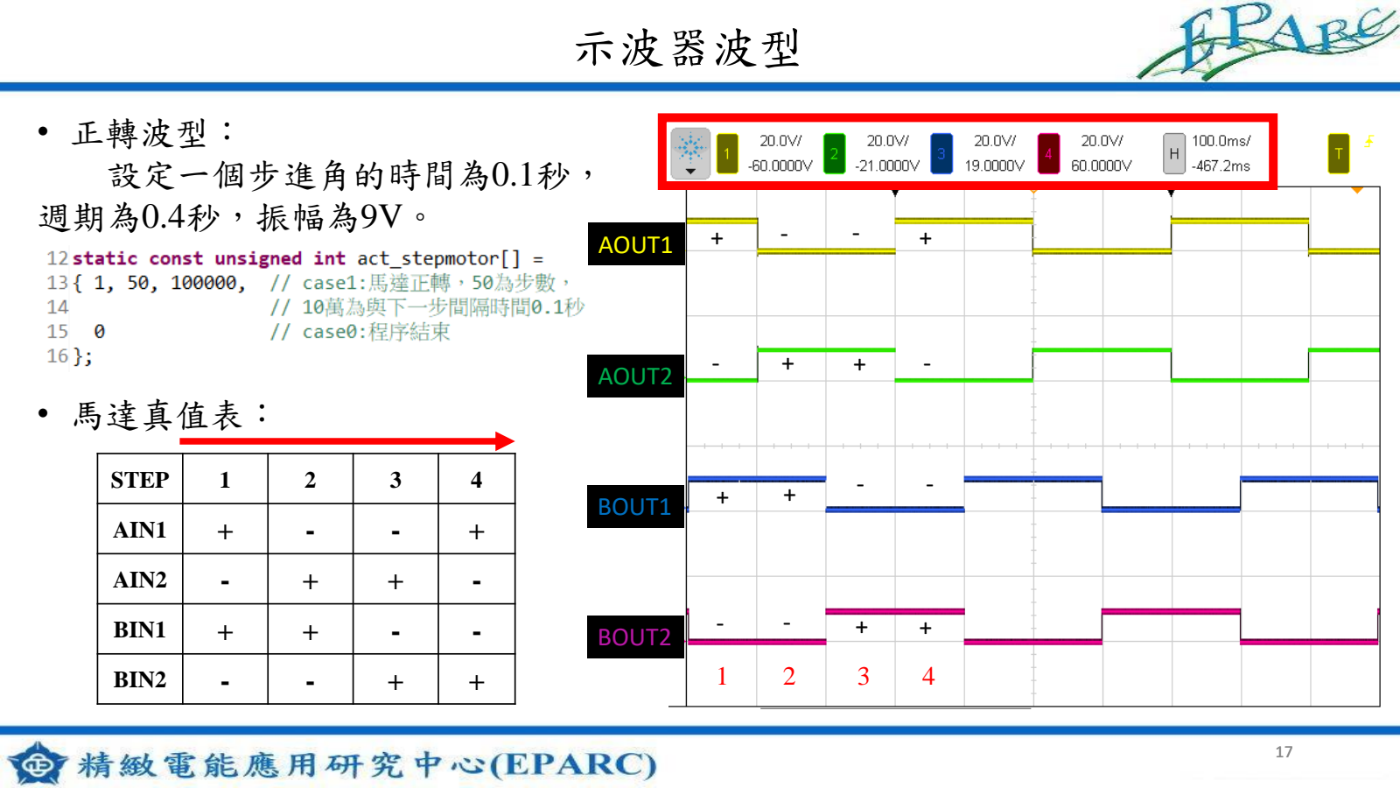
[picture p71: page 17]

## 設定一個步進角的時間為0.1秒， 週期為0.4秒，振幅為9V。

AOUT1

AOUT2

BOUT1

BOUT2

+

+

+ | - | -
- | + | +

+

+

+

1 | 2 | 3 | 4
STEP | 1 | 2 | 3 | 4
AIN1 | + | - | - | +
AIN2 | - | + | + | -
BIN1 | + | + | - | -
BIN2 | - | - | + | +

## - 馬達真值表：

# 示波器波型

## - 反轉波型：

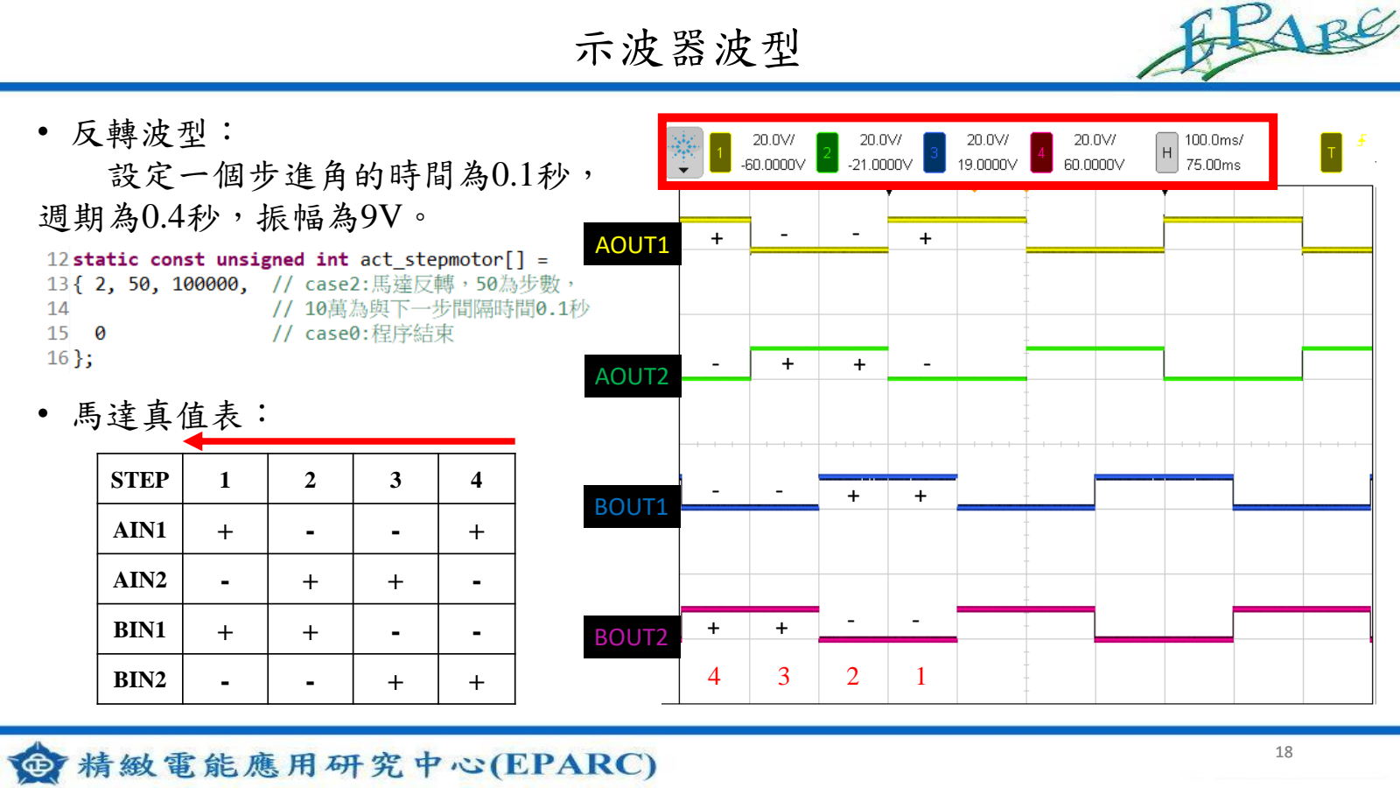
[picture p72: page 18]

## 設定一個步進角的時間為0.1秒， 週期為0.4秒，振幅為9V。

+

+

+ | - | -
- | + | +

+

+

+

4 | 3 | 2 | 1
STEP | 1 | 2 | 3 | 4
AIN1 | + | - | - | +
AIN2 | - | + | + | -
BIN1 | + | + | - | -
BIN2 | - | - | + | +

## - 馬達真值表：

AOUT1

AOUT2

BOUT1

BOUT2

# 示波器波型

## - 正轉波型：

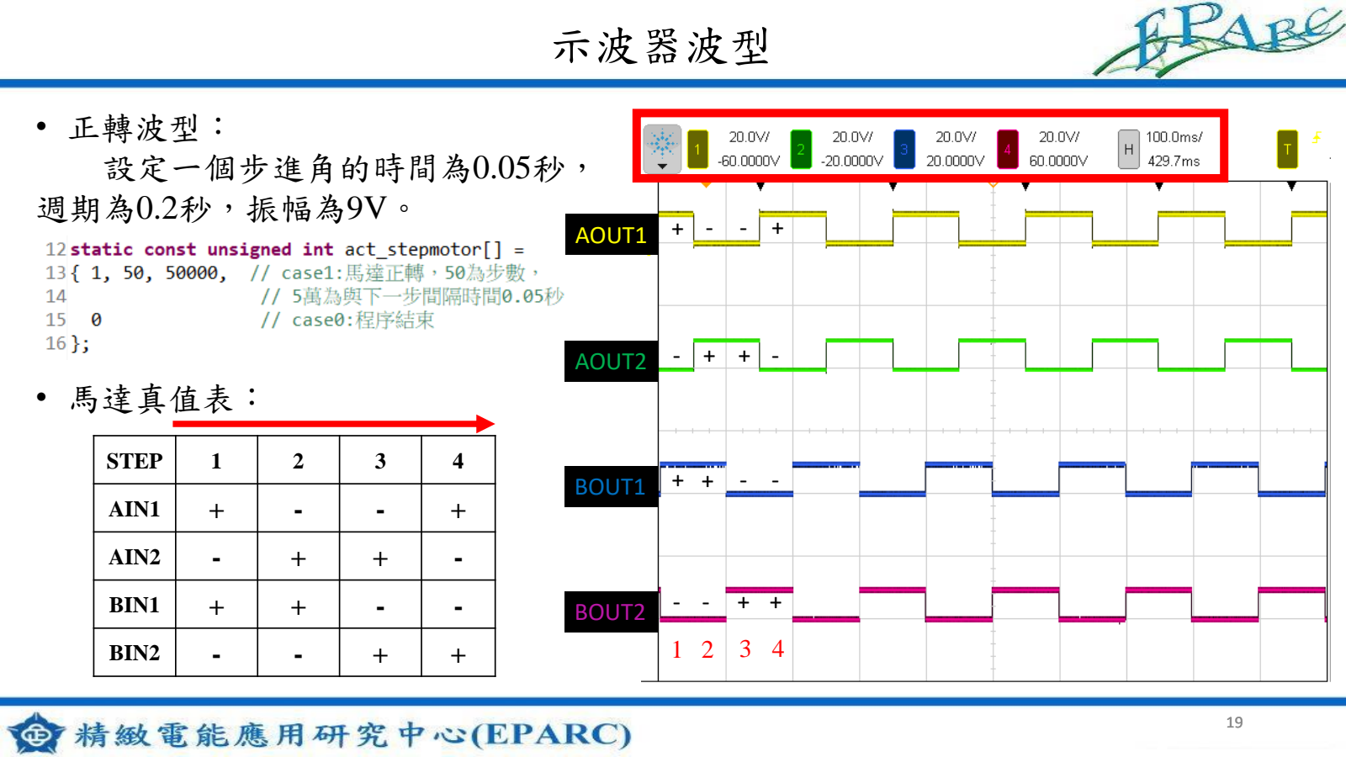
[picture p73: page 19]

## 設定一個步進角的時間為0.05秒， 週期為0.2秒，振幅為9V。

+

+

+ - -

- + +

+

+

+

1 2 3 4

STEP | 1 | 2 | 3 | 4
AIN1 | + | - | - | +
AIN2 | - | + | + | -
BIN1 | + | + | - | -
BIN2 | - | - | + | +

## - 馬達真值表：

AOUT1

AOUT2

BOUT1

BOUT2

# 示波器波型

## - 正轉波型：

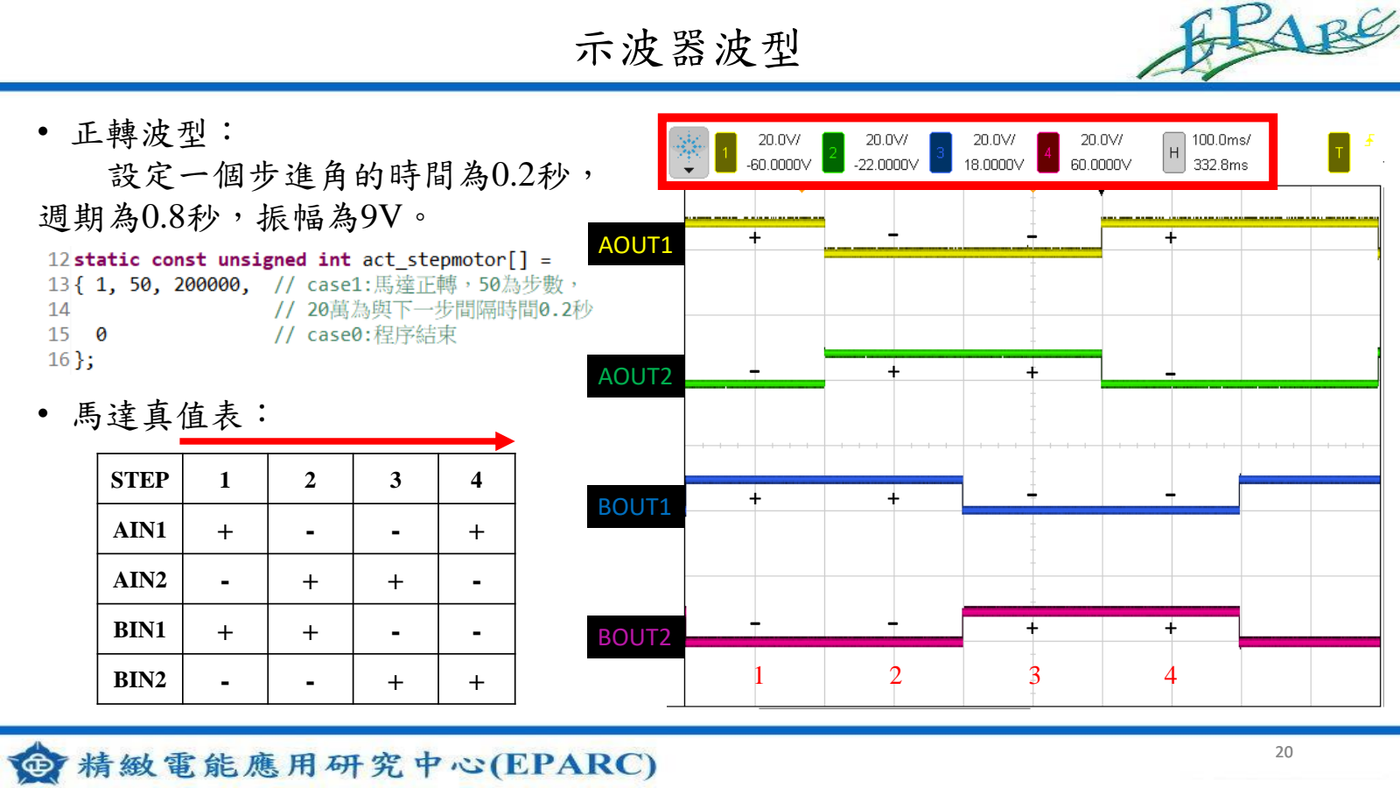
[picture p74: page 20]

## 設定一個步進角的時間為0.2秒， 週期為0.8秒，振幅為9V。

+

+

+ | - | -
- | + | +

+

+

+

1 | 2 | 3 | 4
STEP | 1 | 2 | 3 | 4
AIN1 | + | - | - | +
AIN2 | - | + | + | -
BIN1 | + | + | - | -
BIN2 | - | - | + | +

## - 馬達真值表：

AOUT1

AOUT2

BOUT1

BOUT2

大綱

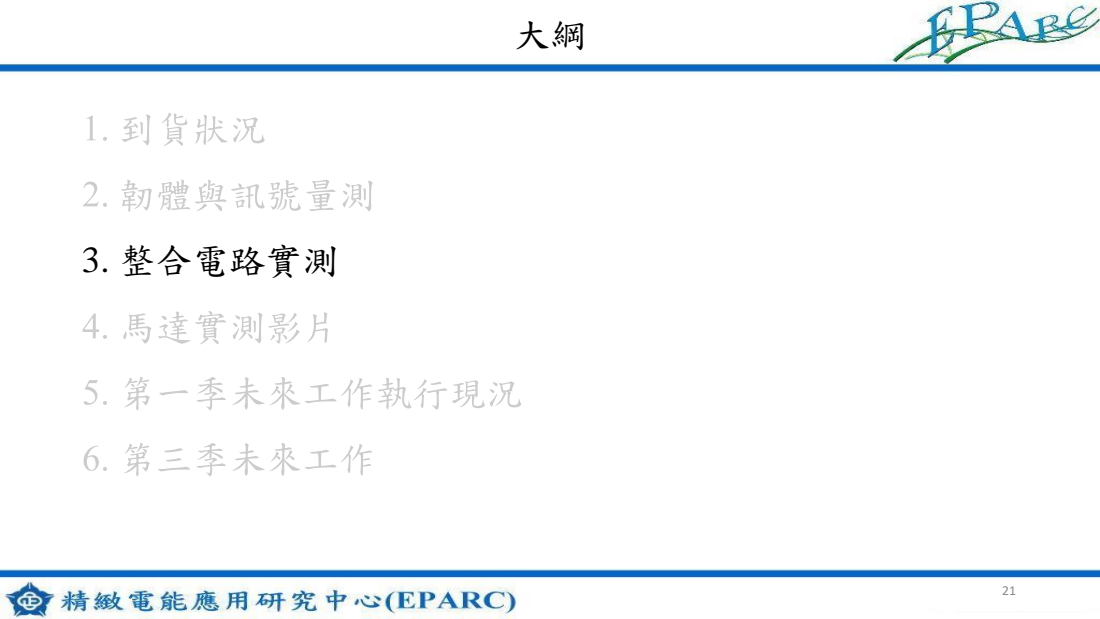
[picture p75: page 21]
3. 整合電路實測

# 一對二整合電路Layout

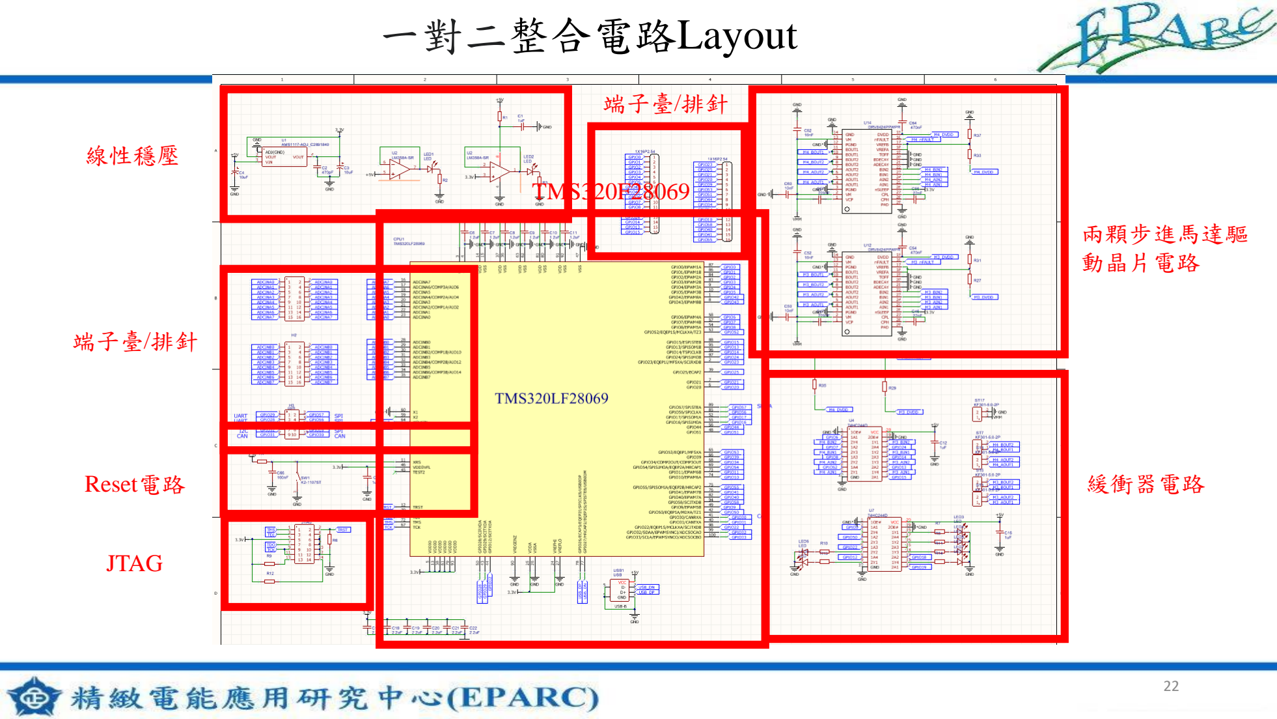
[picture p76: page 22]

線性穩壓

端子臺/排針

Reset電路

JTAG

緩衝器電路

兩顆步進馬達驅
動晶片電路

TMS320F28069

端子臺/排針

# 一對二整合電路Layout

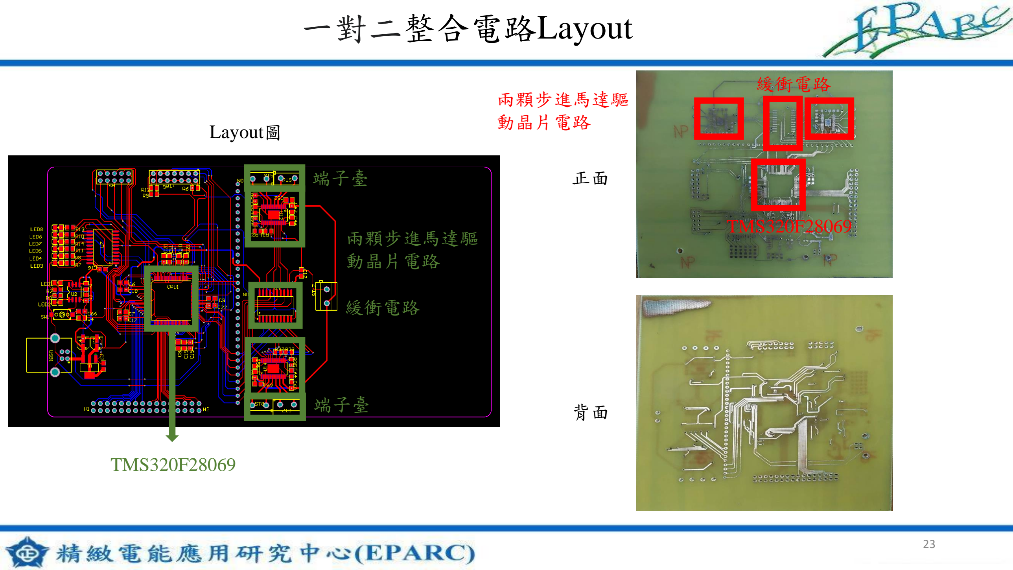
[picture p77: page 23]

Layout圖

正面

背面

TMS320F28069

兩顆步進馬達驅
動晶片電路

兩顆步進馬達驅
動晶片電路

TMS320F28069

端子臺

端子臺

緩衝電路

緩衝電路

# 一對四整合電路Layout

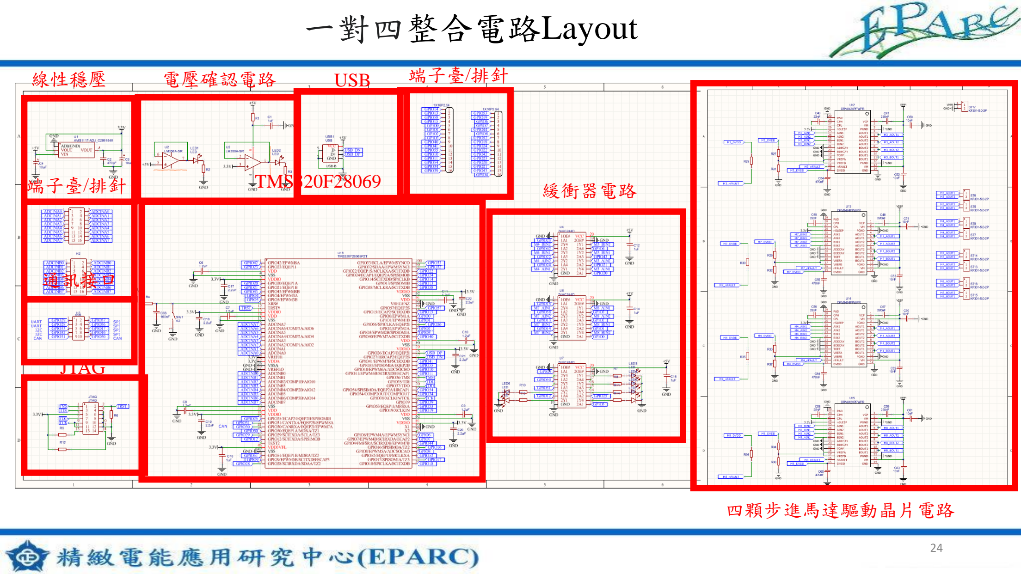
[picture p78: page 24]

線性穩壓

端子臺/排針

USB 端子臺/排針

JTAG

TMS320F28069 | 緩衝器電路

四顆步進馬達驅動晶片電路

電壓確認電路

通訊接口

# 一對四整合電路Layout

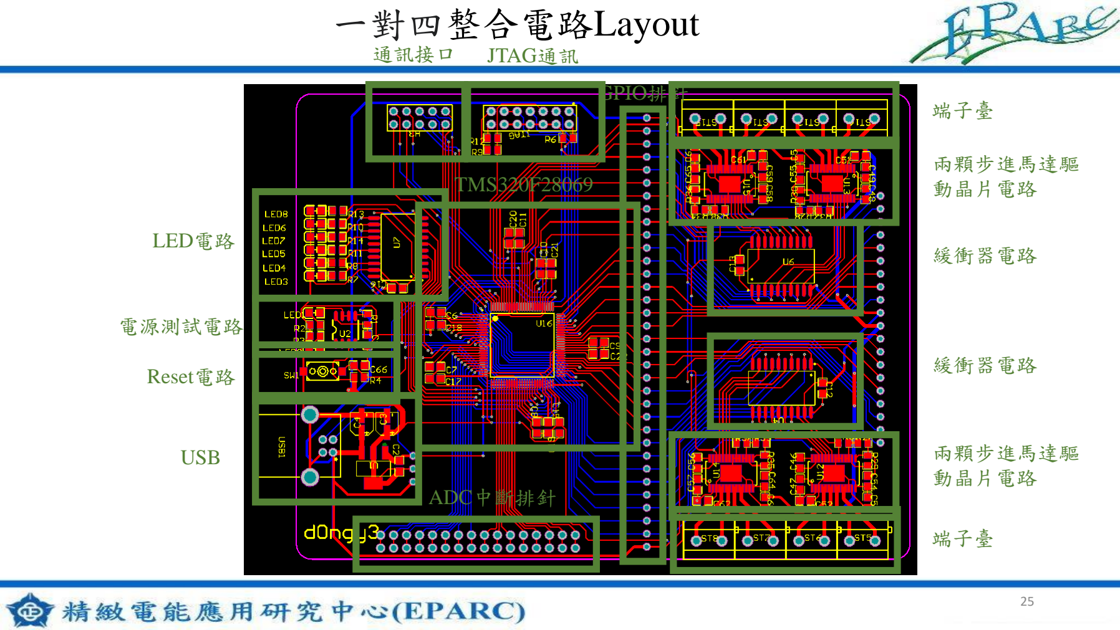
[picture p79: page 25]

LED電路

電源測試電路

USB

通訊接口 JTAG通訊

端子臺

端子臺

兩顆步進馬達驅
動晶片電路

兩顆步進馬達驅
動晶片電路

緩衝器電路

緩衝器電路

ADC中斷排針

GPIO排針

TMS320F28069

Reset電路

## ⚫ Layout送洗，民國111年8月4日到貨，尚須將TI晶片、馬達驅動晶片、 緩衝電路、端子座以及周邊電路焊接以及測試。

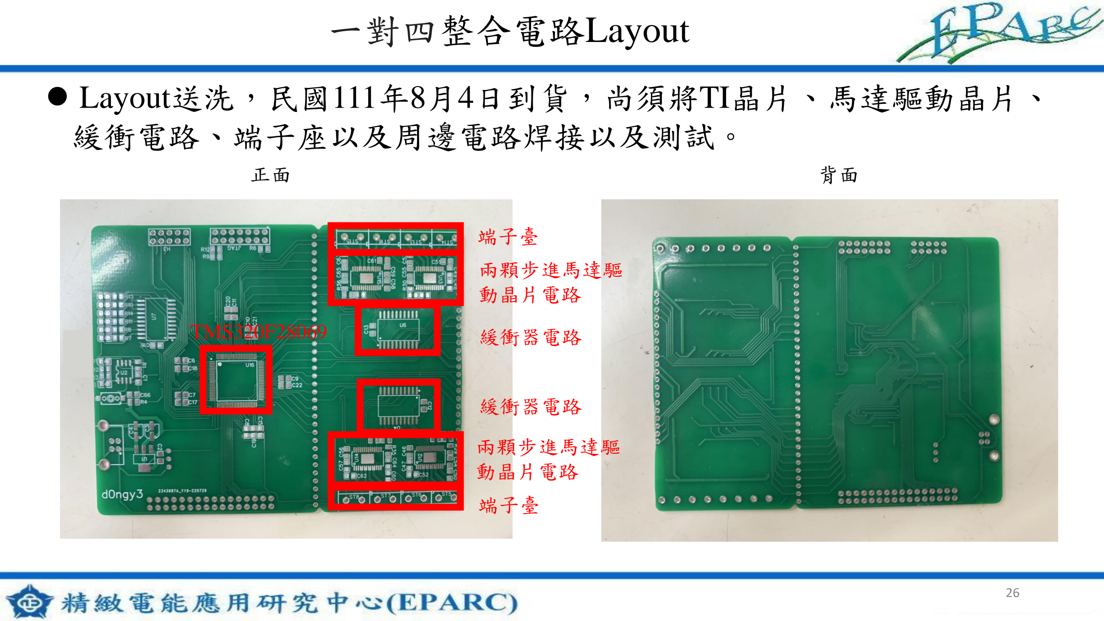
[picture p80: page 26]

正面 | 背面

TMS320F28069

兩顆步進馬達驅
動晶片電路

兩顆步進馬達驅
動晶片電路

# 一對四整合電路Layout

緩衝器電路

緩衝器電路

端子臺

端子臺

大綱

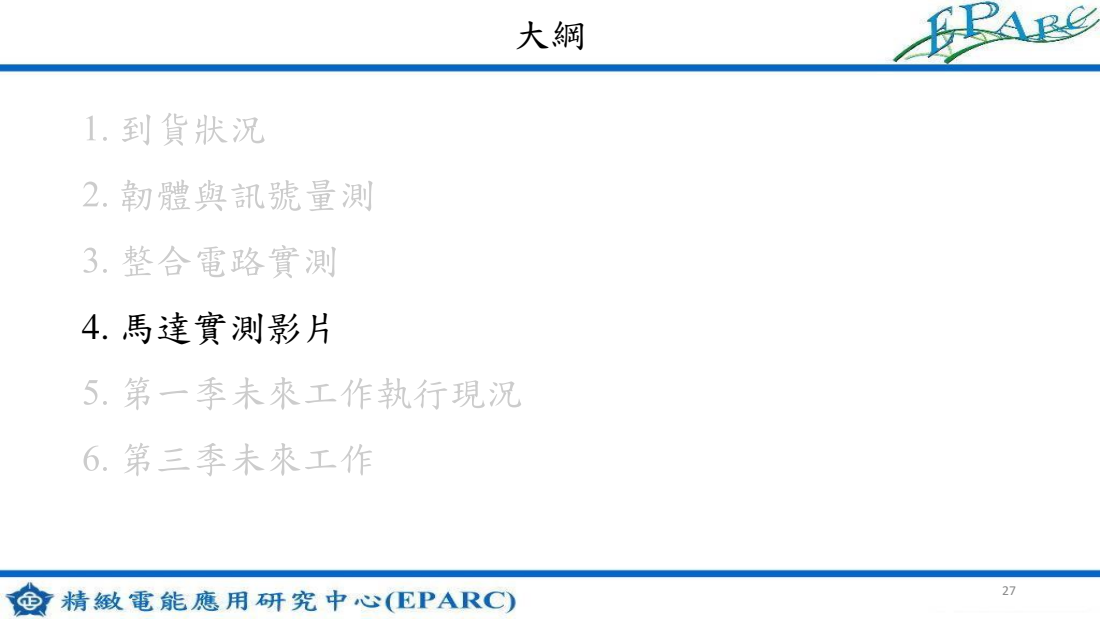
[picture p81: page 27]
4. 馬達實測影片

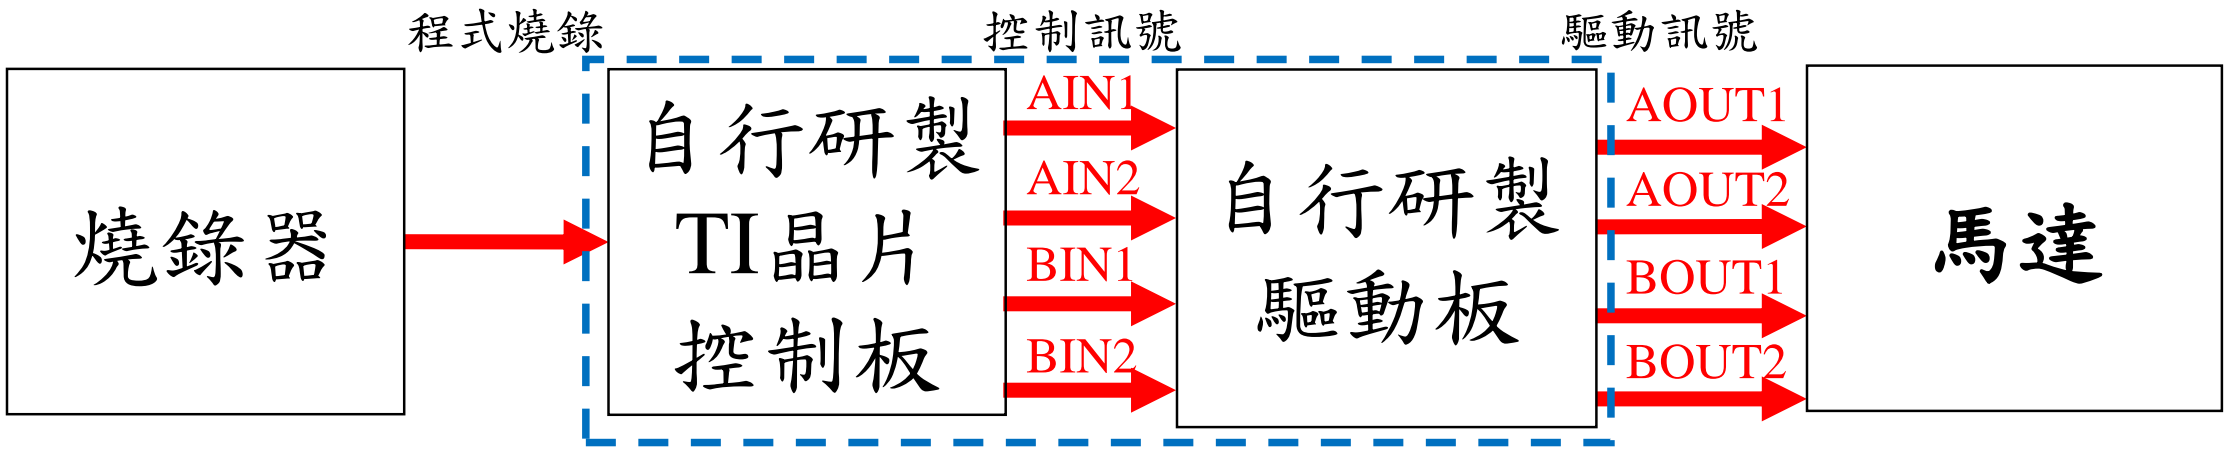
[picture p82: figure]
程式燒錄; 控制訊號; 驅動訊號; 燒錄器; 自行研製 TI晶片 控制板; 自行研製; 驅動板; AIN1; AIN2; BIN1; BIN2; BOUT2; BOUT1; AOUT2; AOUT1

# 整合電路

# 馬達實測流程圖

# 馬達實測影片

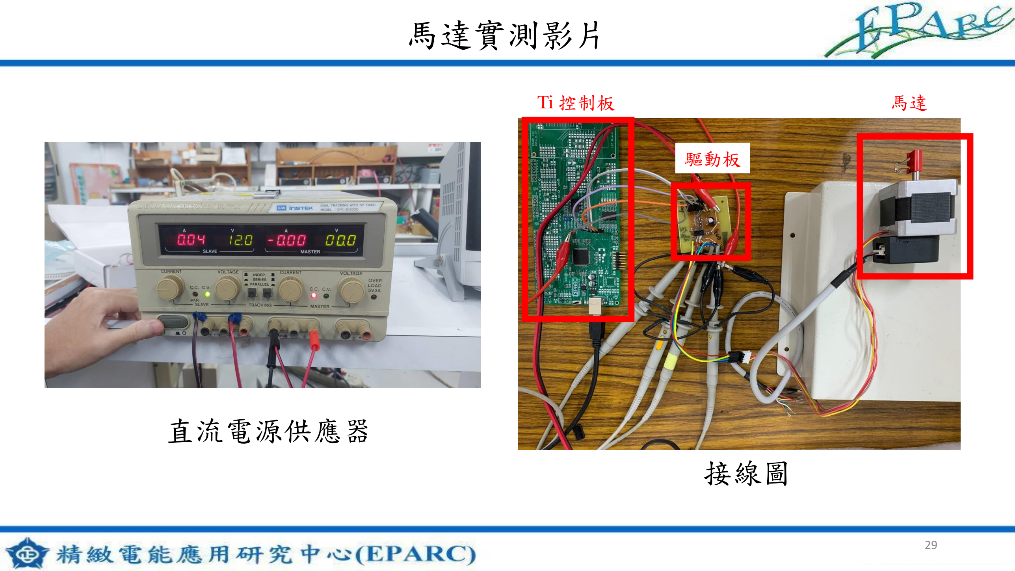
[picture p83: page 29]

## 直流電源供應器 接線圖

Ti 控制板

驅動板

馬達

# 馬達實測影片

# - 馬達正轉90度(轉速為3rpm)，停止5秒，共轉一圈

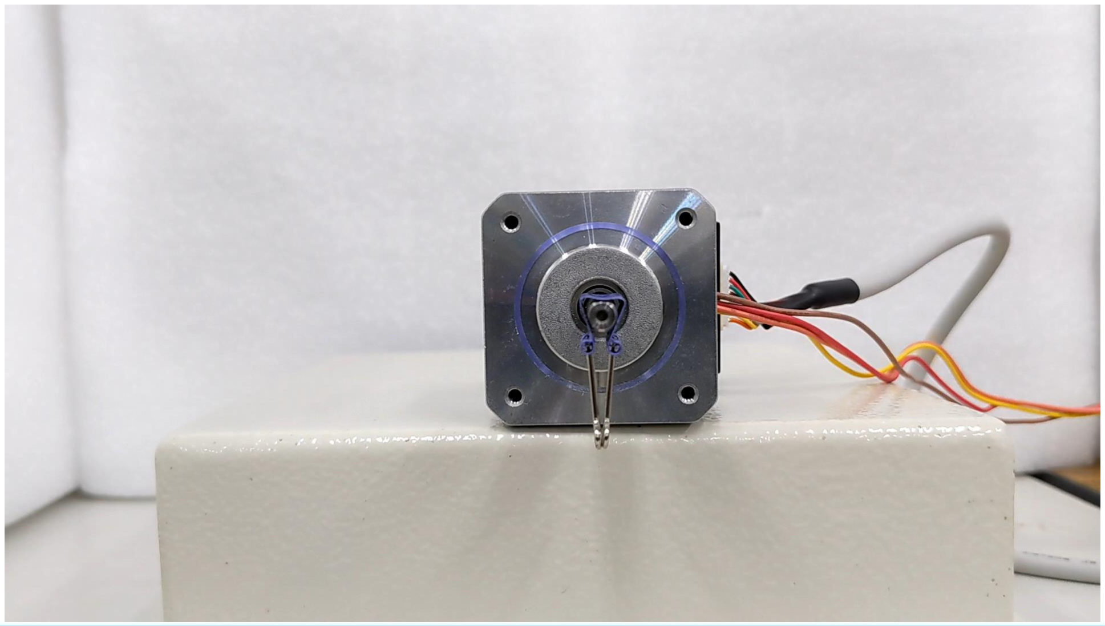
[picture p84: figure]

# - 馬達反轉180度(轉速為3rpm) ，停止5秒，共轉一圈

# 馬達實測影片

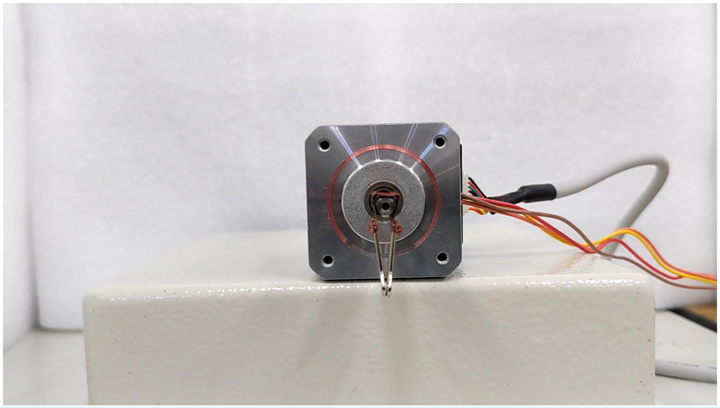
[picture p85: figure]

# - 馬達正轉360度(轉速為30rpm) ，停止5秒，共轉一圈

# 馬達實測影片

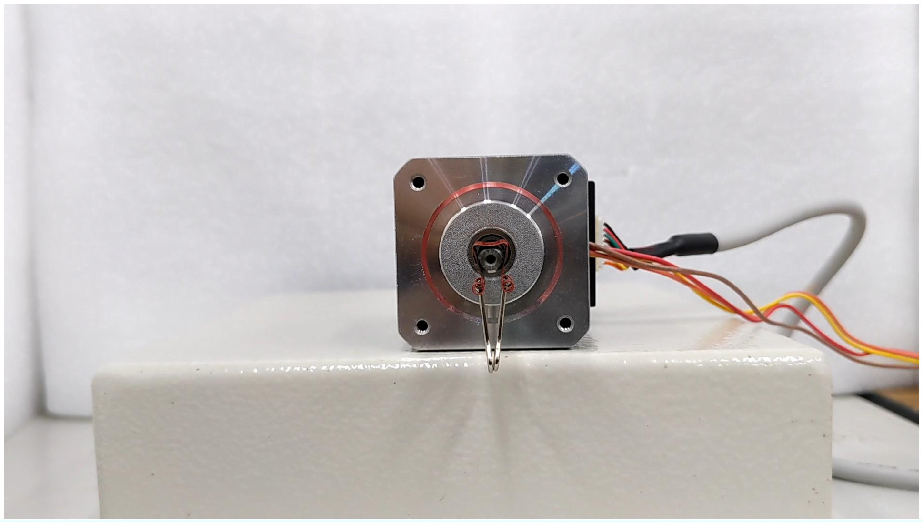
[picture p86: figure]

大綱

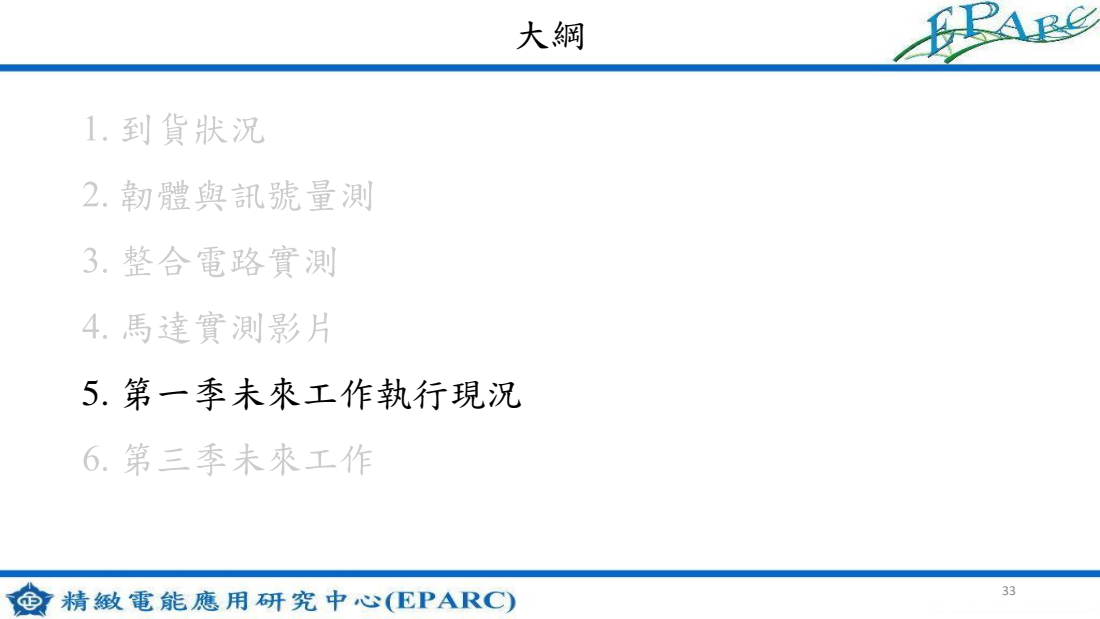
[picture p87: page 33]
5. 第一季未來工作執行現況

# 第一季未來工作執行現況

## 1. 驅動板優化:

## (A) 新增nFault腳位

## (B) DIP電容換成SMD電容

## (C) 排針改成端子臺

## 2. 控制板與驅動板進行整合。

## 3. 馬達到貨後，接上步進馬達進行驅動實測。

# 第一季未來工作執行現況

## 1. 驅動板優化：新增nFault腳位、DIP電容換成SMD電容、排針改成端子座。

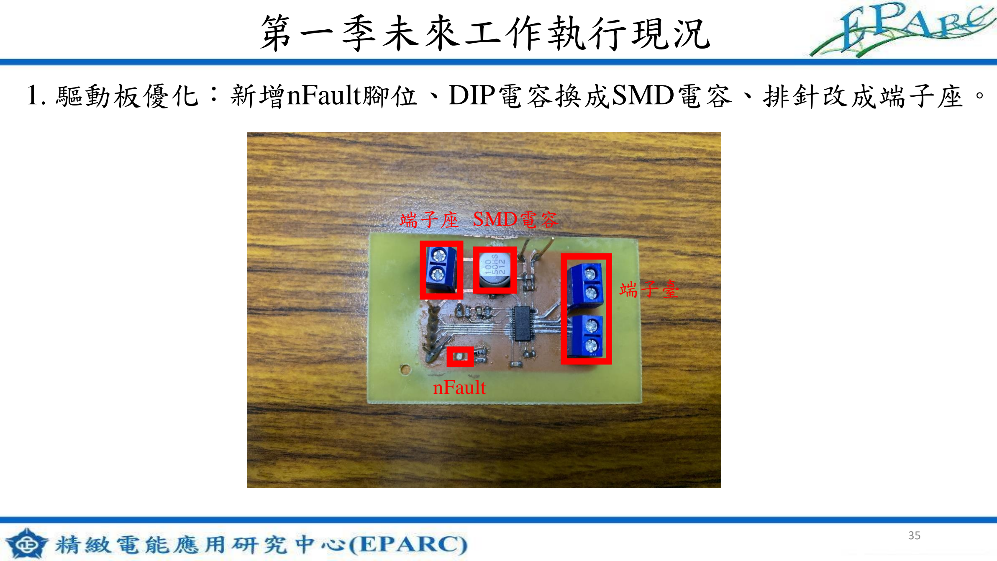
[picture p88: page 35]

端子座

端子臺

nFault

SMD電容

## 2. 控制板與驅動板進行整合。

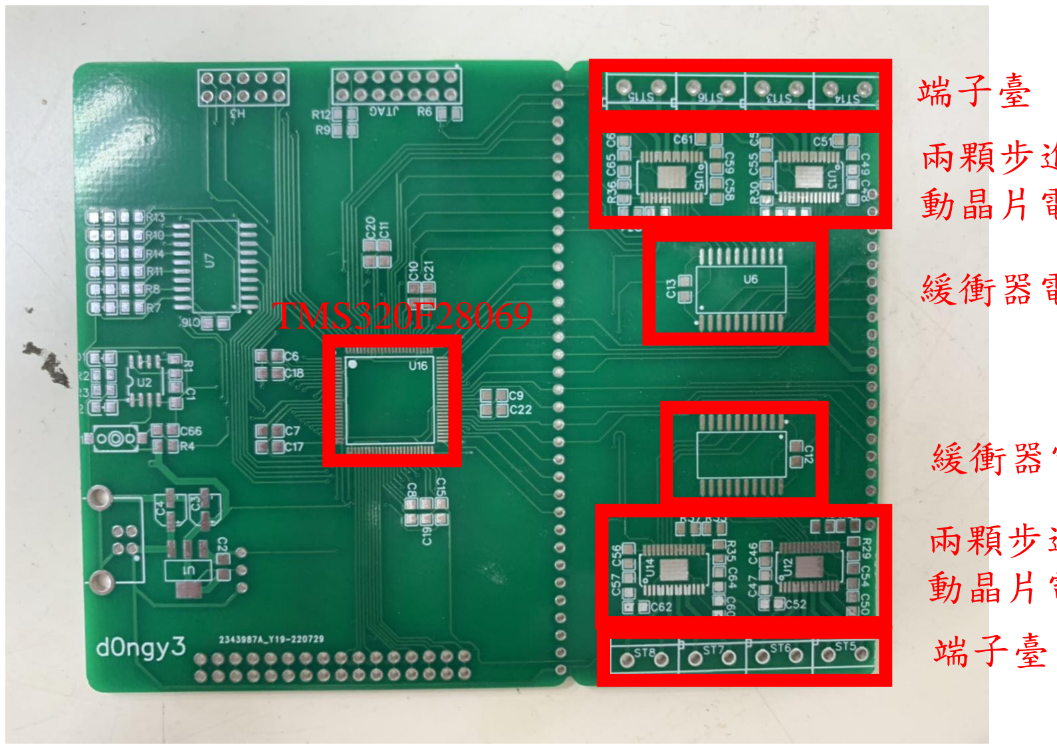
[picture p89: figure]
TMS320F28069; 端子臺

兩顆步進馬達驅
動晶片電路

兩顆步進馬達驅
動晶片電路

# 一對四整合電路Layout

緩衝器電路

緩衝器電路

大綱

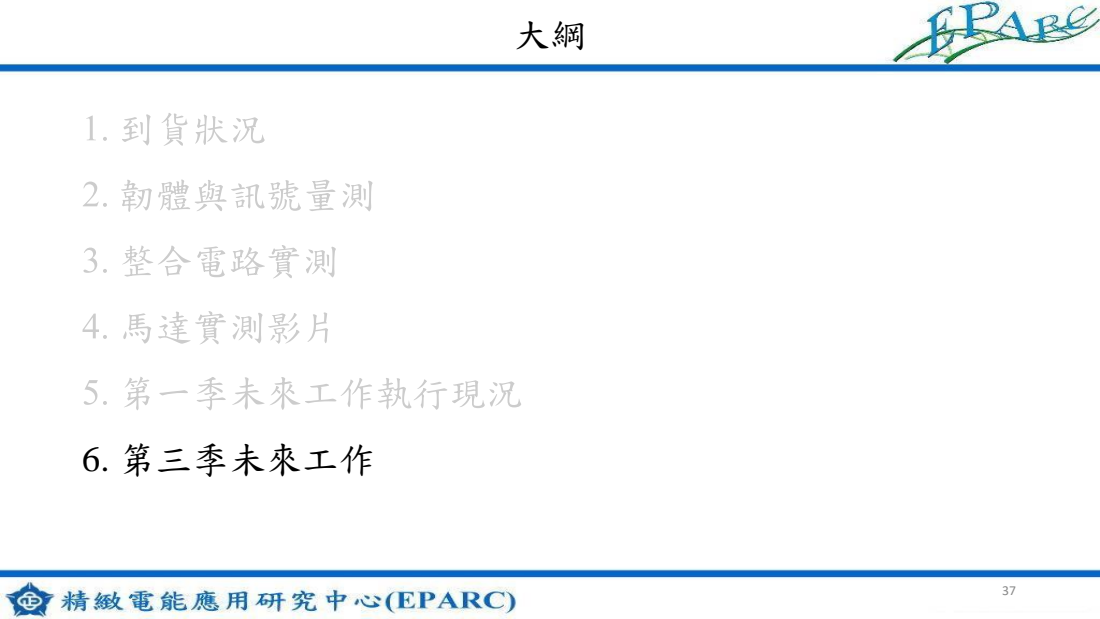
[picture p90: page 37]
6. 第三季未來工作

# 第三季未來工作

# 1. 控制迴路測試

# 2. 步進馬達ㄧ對四整合電路測試

## 3. ㄧ對八Layout

Thanks for listening.
