tim7376875/Industry-university-coope-Stepper-motor-drive-circuit-design-and-controlration-/01 簡報資料/03_第三季產學報告.pdf

# 步進馬達一對八驅動電路 與控制研發計畫 第三季報告

報告人：詹京展、蕭崇仁

指導教授：余國瑞 博士

報告日期：民國111年11月15日

一.控制迴路設計

二.整合電路實測

三.馬達實測影片

四.第二季未來工作執行現況

五.第三季未來工作

大綱

一.控制迴路設計

二.整合電路實測

三.馬達實測影片

四.第二季未來工作執行現況

五.第三季未來工作

大綱

- 馬達聲音問題：第二季進度報告，馬達實測時，馬達有異音問題。
- 解決方式：GPIO改為PWM，並加入dead band，避免四線馬達短 路。
- PWM優點：
- 設定觸發中斷，即時改變轉速與轉向。
- 方便撰寫程式，調整頻率即可改變轉速。
- 內建波型反轉功能，可改變轉向。
- 方便設計回授控制。

馬達聲音問題

- 馬達聲音問題（每半週期加入dead band，dead band 時間1 ）

馬達聲音問題

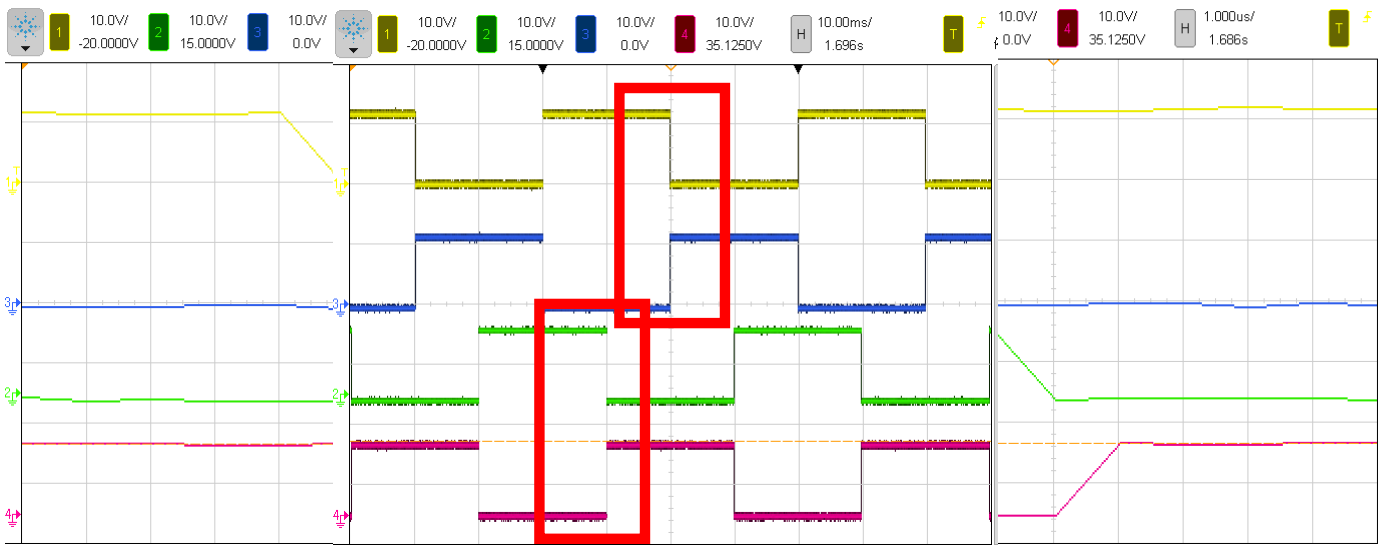
[picture p91: figure]

圖1. dead band波型圖

µs

- 馬達聲音問題

馬達聲音問題

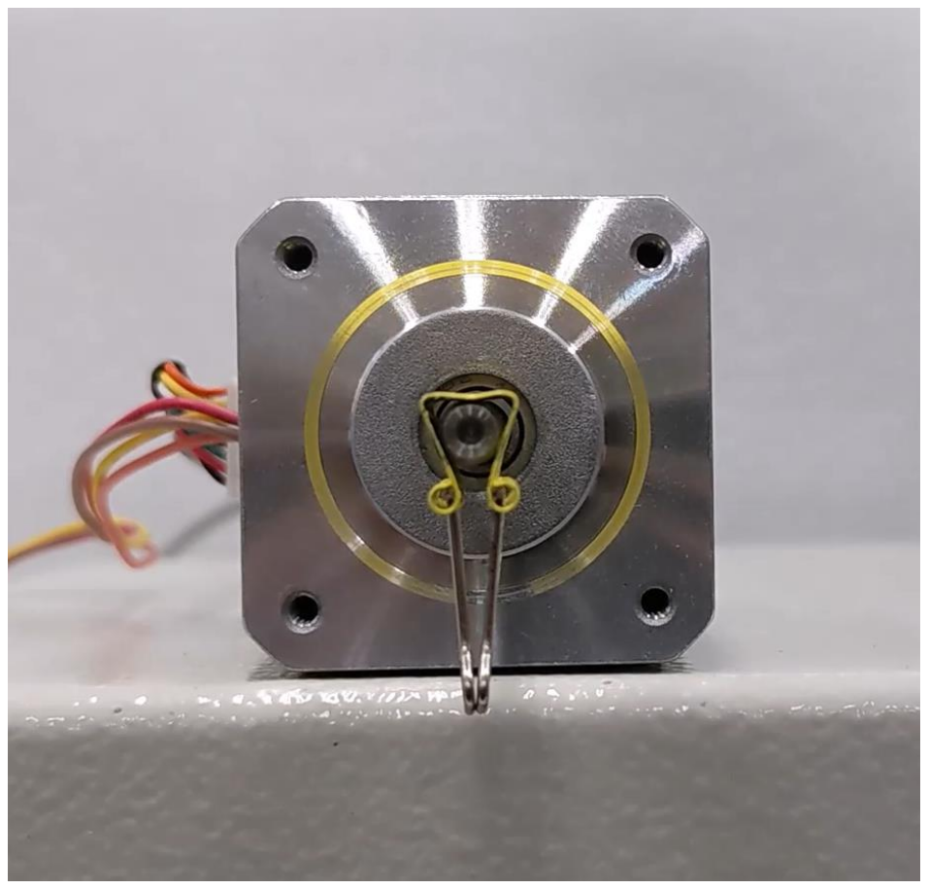
[picture p92: figure]
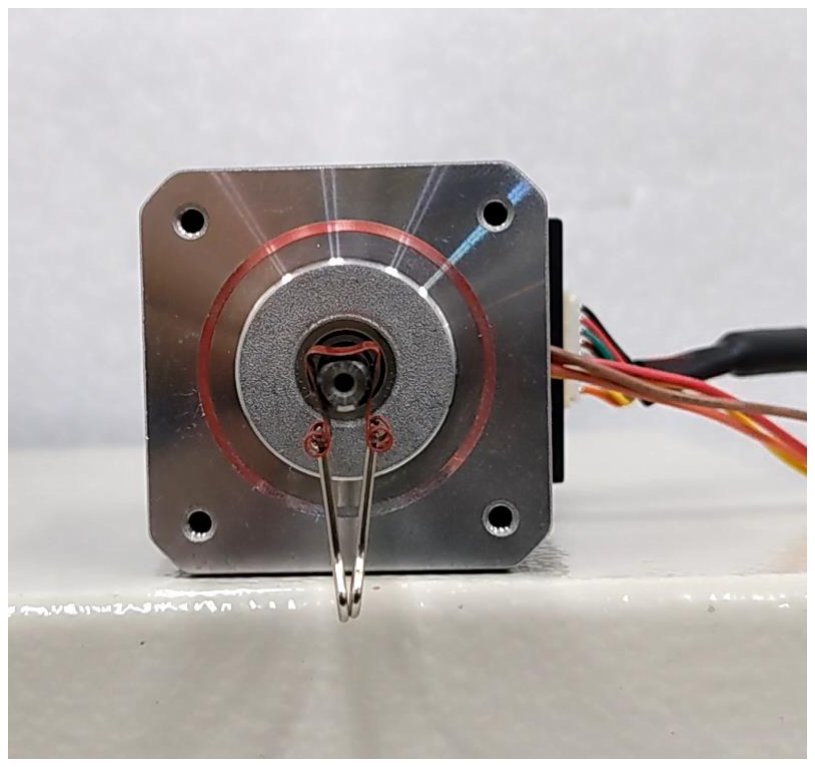
[picture p93: figure]

圖2. 馬達聲音比較影片

(a)第二季馬達正轉360° (b)第三季馬達正轉360°

- 馬達型號ST4118M1404B：雙極1.4A、24V、扭矩為0.234Nm、轉 速為450rpm（扭矩維持0.23Nm以上）。

馬達轉速

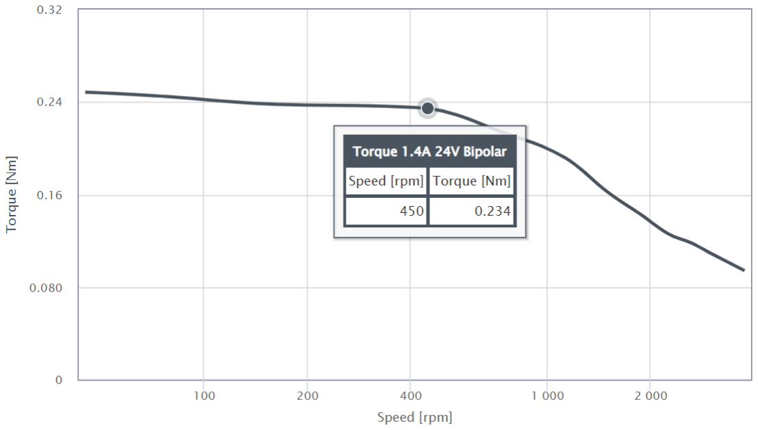
[picture p94: figure]

圖3. 馬達ST4118M1404B轉速與扭矩圖

- 馬達型號ST4118M1804B：雙極1.8A、24V、扭矩為0.26Nm、轉 速為300rpm（扭矩維持0.26Nm以上）。

馬達轉速

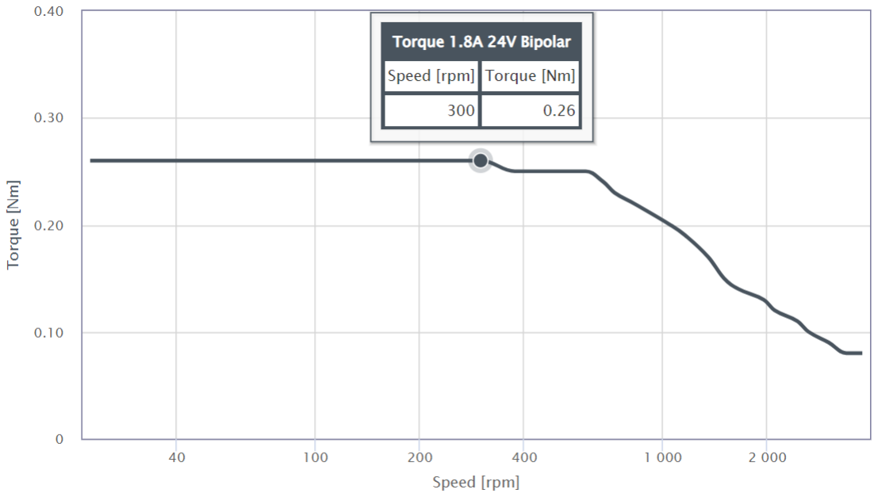
[picture p95: figure]

圖4. 馬達ST4118M1804B轉速與扭矩圖

馬達轉速測試

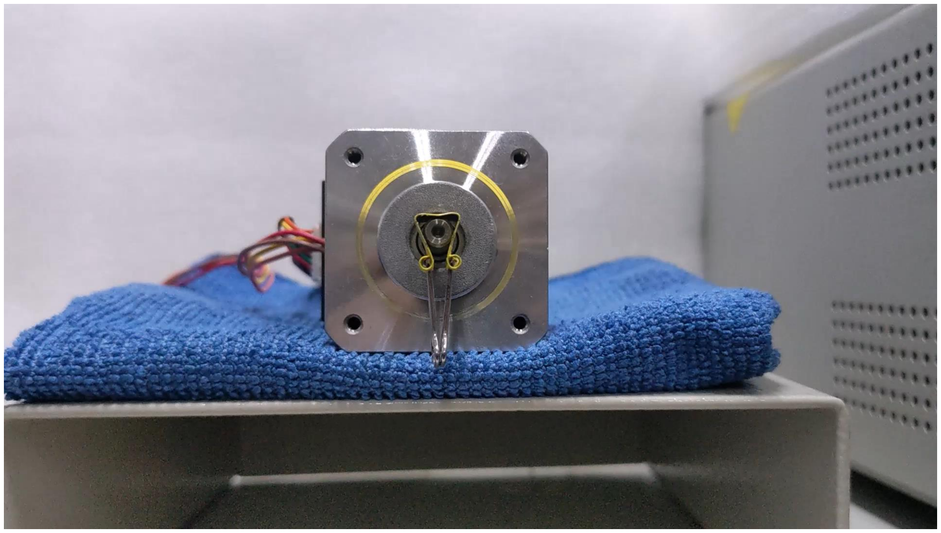
[picture p96: figure]

圖5. 馬達轉速120rpm與30rpm切換影片

ECAP

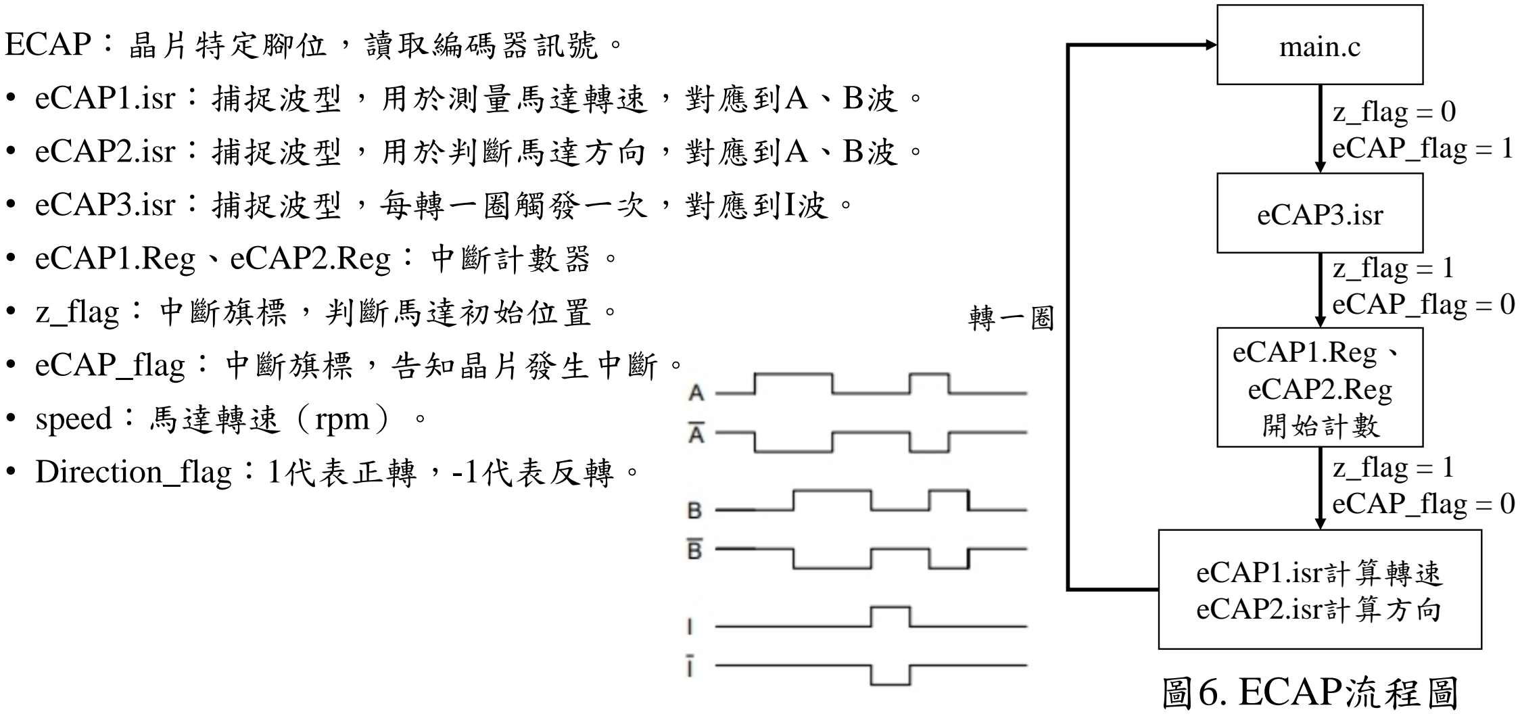
[picture p97: figure]
ECAP：晶片特定腳位，讀取編碼器訊號。; • eCAP1.isr：捕捉波型，用於測量馬達轉速，對應到A、B波。; • eCAP2.isr：捕捉波型，用於判斷馬達方向，對應到A、B波。; • eCAP3.isr：捕捉波型，每轉一圈觸發一次，對應到I波。; • eCAP1.Reg、eCAP2.Reg：中斷計數器。; • z_flag：中斷旗標，判斷馬達初始位置。; • eCAP_flag：中斷旗標，告知晶片發生中斷。; • speed：馬達轉速（rpm）。; • Direction_flag：1代表正轉，-1代表反轉。; 圖6. ECAP流程圖; eCAP3.isr; eCAP1.Reg、 eCAP2.Reg 開始計數; eCAP1.isr計算轉速 eCAP2.isr計算方向; 轉一圈; main.c; z_flag = 0 eCAP_flag = 1; z_flag = 1 eCAP_flag = 0
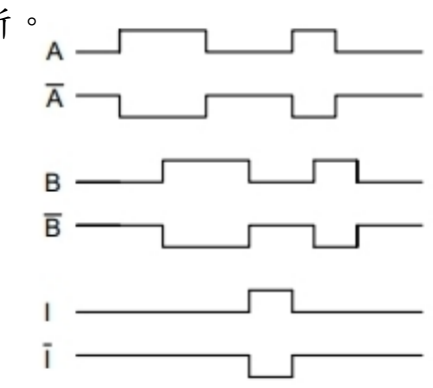
[picture p98: figure]
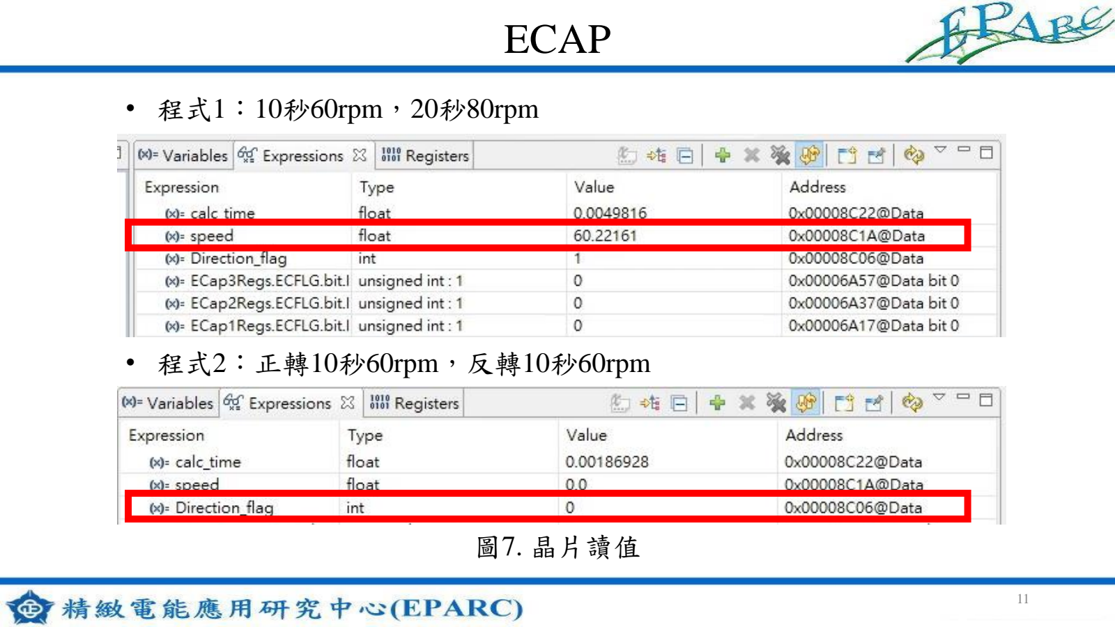
[picture p99: page 11]

ECAP

圖7. 晶片讀值

- 程式1：10秒60rpm，20秒80rpm
- 程式2：正轉10秒60rpm，反轉10秒60rpm

一.控制迴路設計

二.整合電路實測

三.馬達實測影片

四.第二季未來工作執行現況

五.第三季未來工作

大綱

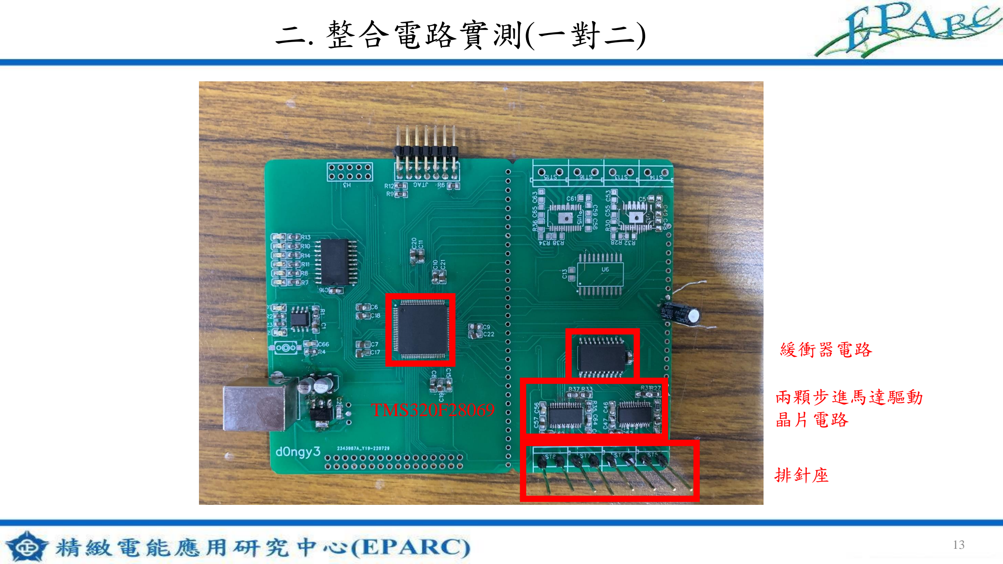
[picture p100: page 13]

二. 整合電路實測(一對二)

TMS320F28069

兩顆步進馬達驅動
晶片電路

緩衝器電路

排針座

二. 整合電路實測

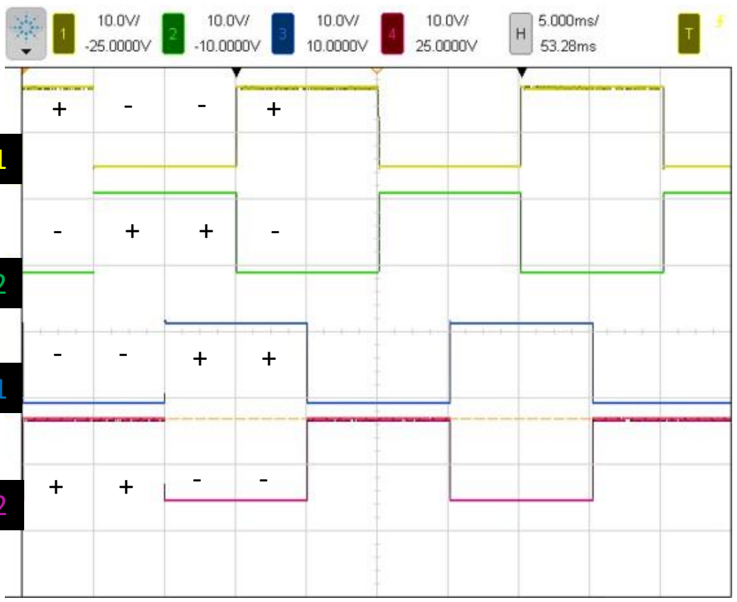
[picture p101: figure]

AOUT1

AOUT2

BOUT1

BOUT2

STEP | 1 | 2 | 3 | 4
AIN1 | + | - | - | +
AIN2 | - | + | + | -
BIN1 | + | + | - | -
BIN2 | - | - | + | +
- 馬達真值表：

一.控制迴路設計

二.整合電路實測

三.馬達實測影片

四.第二季未來工作執行現況

五.第三季未來工作

大綱

馬達實測流程圖

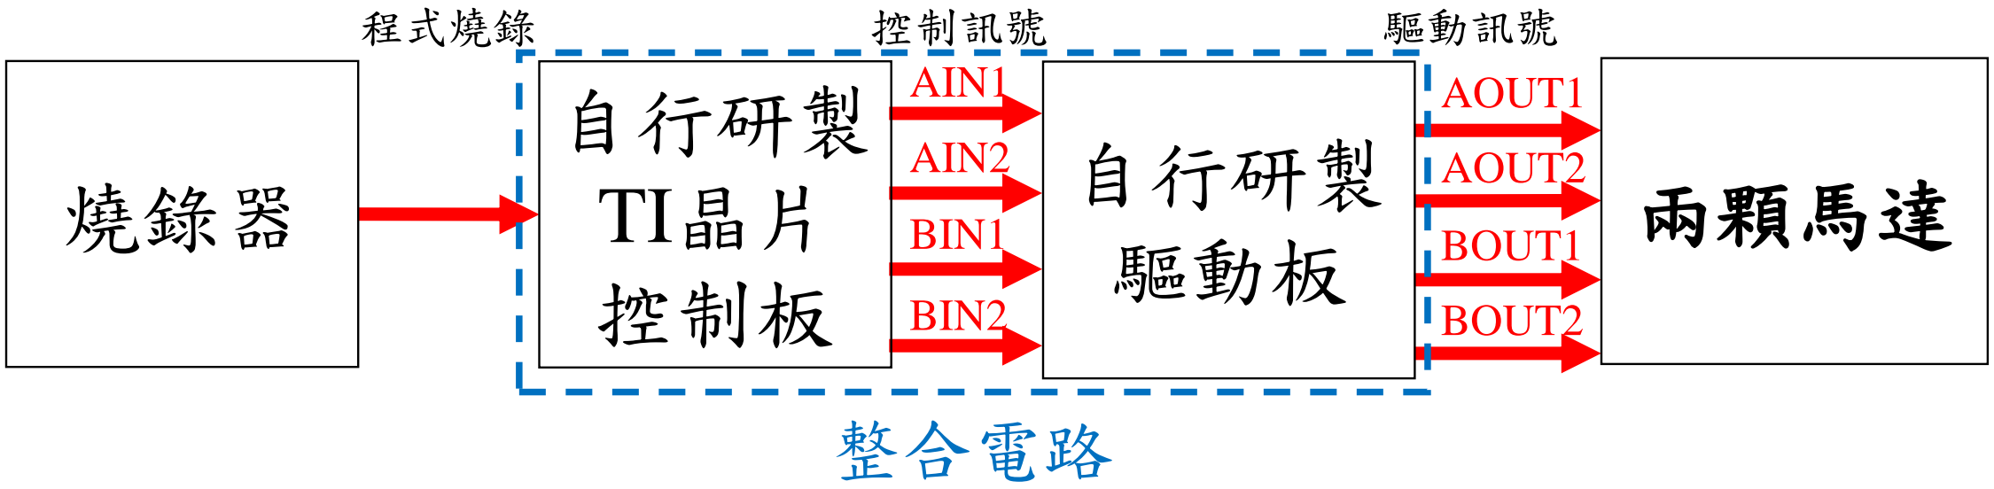
[picture p102: figure]
程式燒錄; 控制訊號; 驅動訊號; 燒錄器; 自行研製 TI晶片 控制板; 自行研製; 驅動板; 兩顆馬達; AIN1; AIN2; BIN1; BIN2; BOUT2; BOUT1; AOUT2; AOUT1; 整合電路

馬達實測影片

- 一對二馬達實測

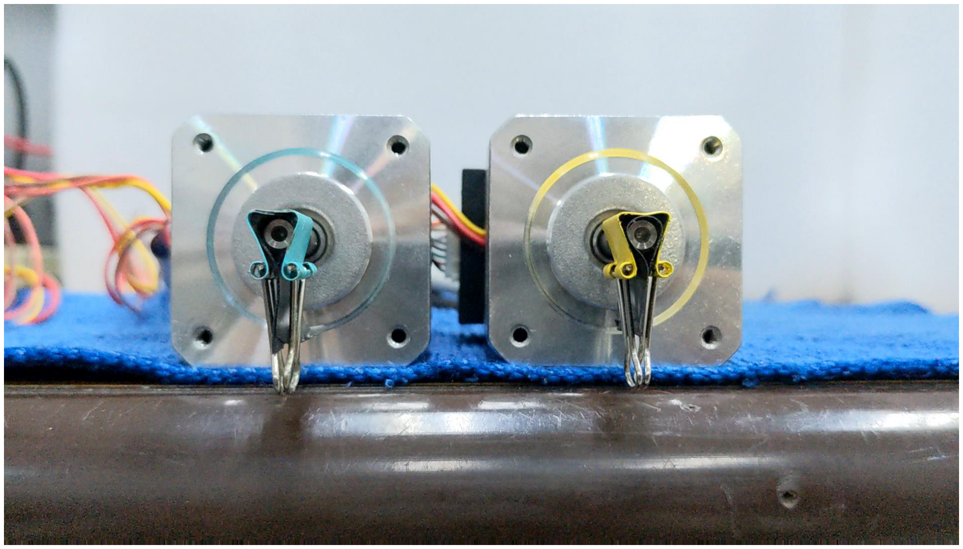
[picture p103: figure]

一.控制迴路設計

二.整合電路實測

三.馬達實測影片

四.第二季未來工作執行現況

五.第三季未來工作

大綱

第二季未來工作執行現況

1. 控制迴路測試
2. 步進馬達一對四整合電路測試
3. ㄧ對八整合電路圖

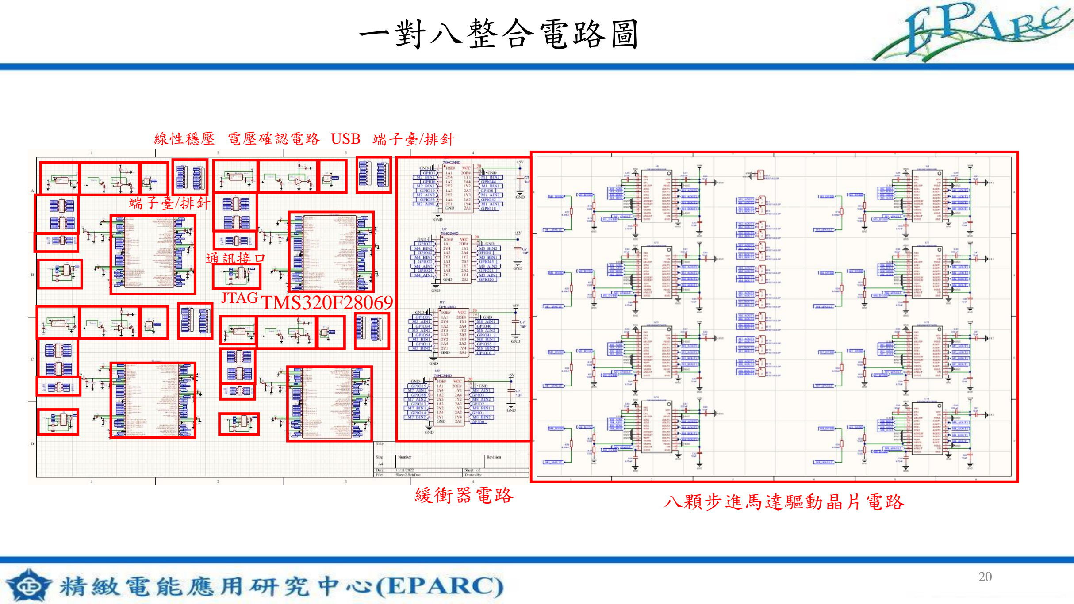
[picture p104: page 20]

ㄧ對八整合電路圖

線性穩壓

端子臺/排針

USB 端子臺/排針

JTAG TMS320F28069

緩衝器電路 | 八顆步進馬達驅動晶片電路

電壓確認電路

通訊接口

一.控制迴路設計

二.整合電路實測

三.馬達實測影片

四.第二季未來工作執行現況

五.第三季未來工作

大綱

第三季未來工作

一.完成迴路控制

二.完成一對八整合電路

三.完成一對八馬達控制實測

## Thanks for listening!
