tim7376875/Industry-university-coope-Stepper-motor-drive-circuit-design-and-controlration-/03 韌體控制程式/02 第二季/06 P31_馬達反轉180度(3rpm)/06 P31_馬達反轉180度(3rpm).PNG

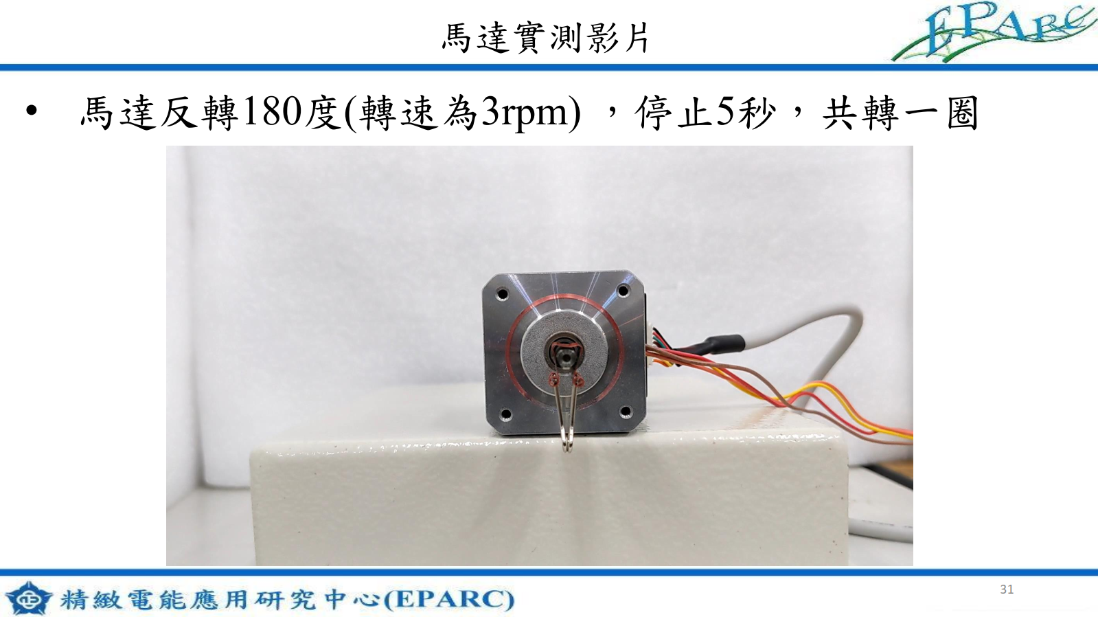
03 韌體控制程式/02 第二季/06 P31_馬達反轉180度(3rpm)/06 P31_馬達反轉180度(3rpm).PNG
