tim7376875/Industry-university-coope-Stepper-motor-drive-circuit-design-and-controlration-/03 韌體控制程式/03 第三季/01 P9_馬達轉速測試/01 P9_馬達轉速測試.PNG

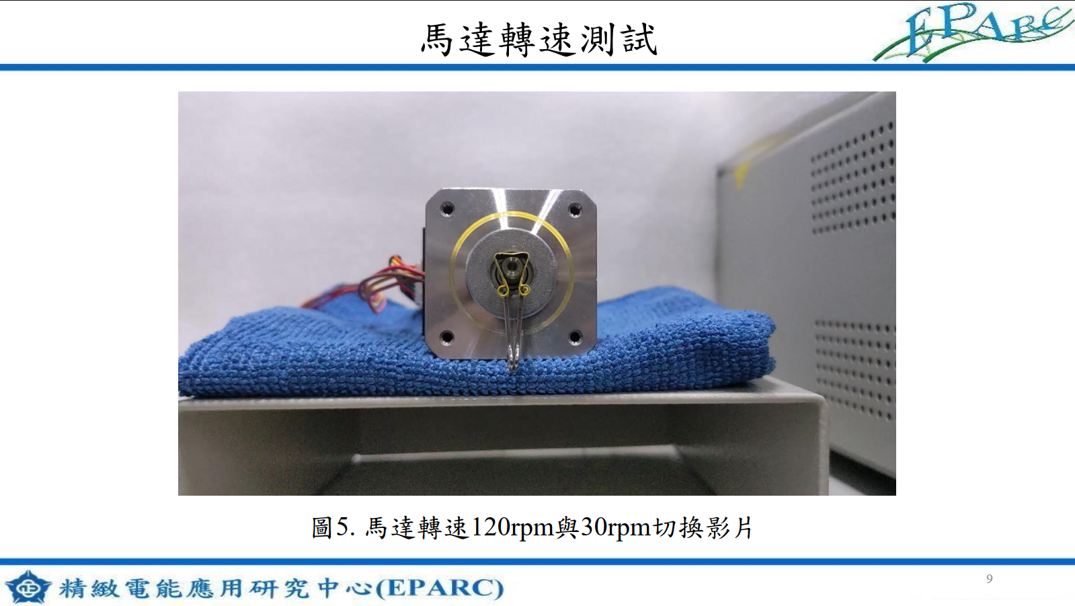
03 韌體控制程式/03 第三季/01 P9_馬達轉速測試/01 P9_馬達轉速測試.PNG
