tim7376875/Industry-university-coope-Stepper-motor-drive-circuit-design-and-controlration-/03 韌體控制程式/03 第三季/02 P10_ECAP/02 P10_ECAP.PNG

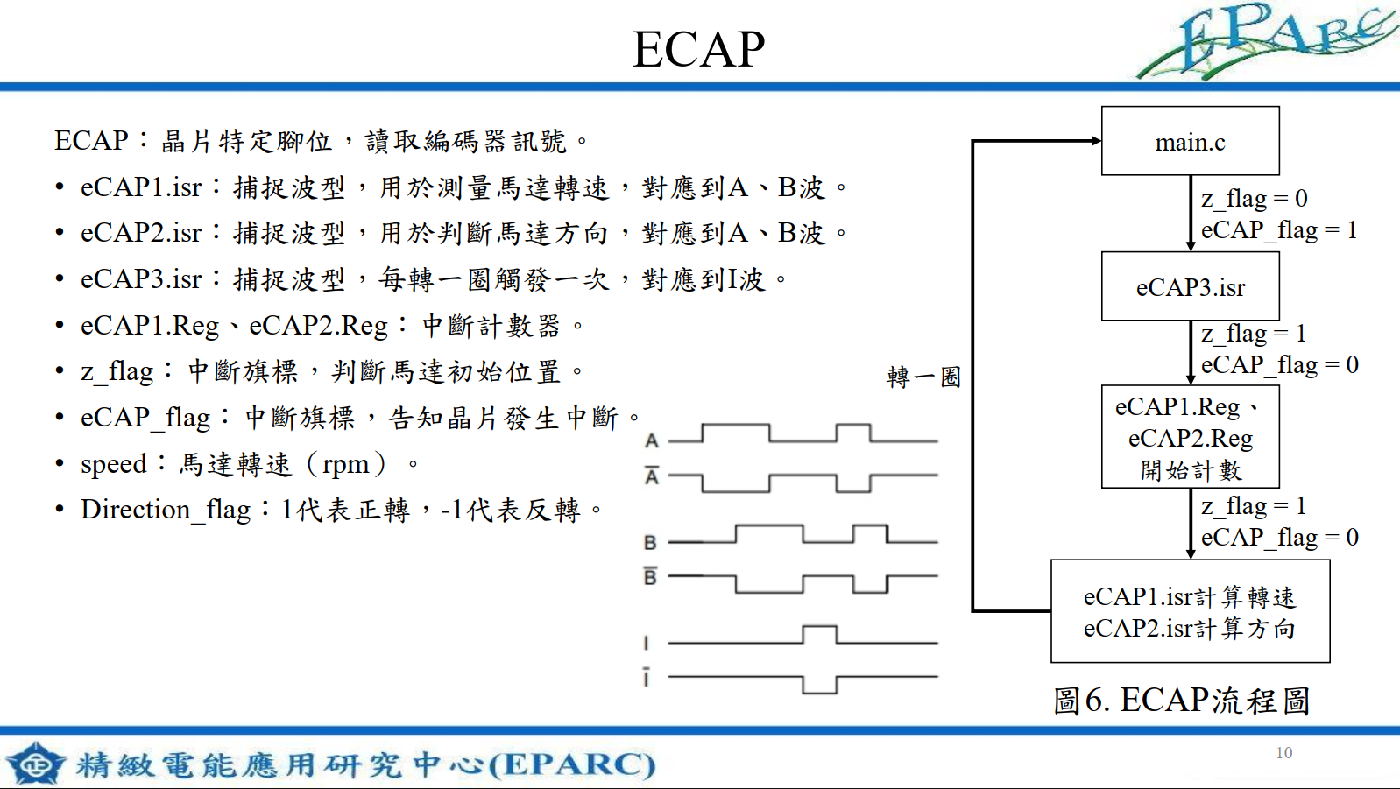
03 韌體控制程式/03 第三季/02 P10_ECAP/02 P10_ECAP.PNG
