tim7376875/Industry-university-coope-Stepper-motor-drive-circuit-design-and-controlration-/03 韌體控制程式/03 第三季/03 P17_馬達實測/03 P17_馬達實測影片.PNG

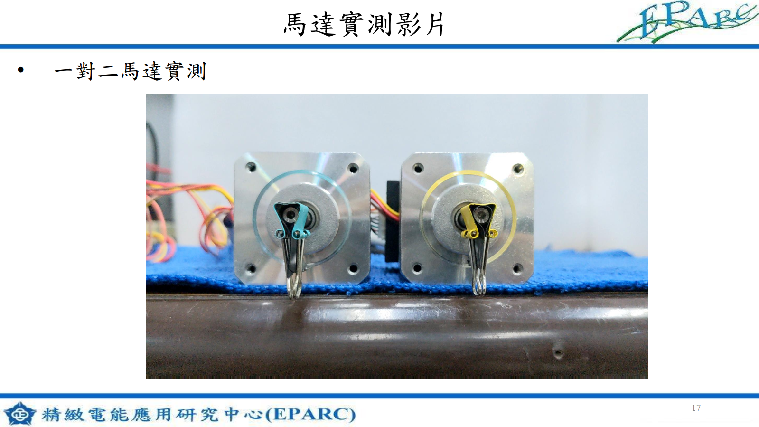
03 韌體控制程式/03 第三季/03 P17_馬達實測/03 P17_馬達實測影片.PNG
