tim7376875/Industry-university-coope-Stepper-motor-drive-circuit-design-and-controlration-/03 韌體控制程式/04 第四季/01_P5_啟動馬達定位至初始點/01_P5_啟動馬達定位至初始點.PNG

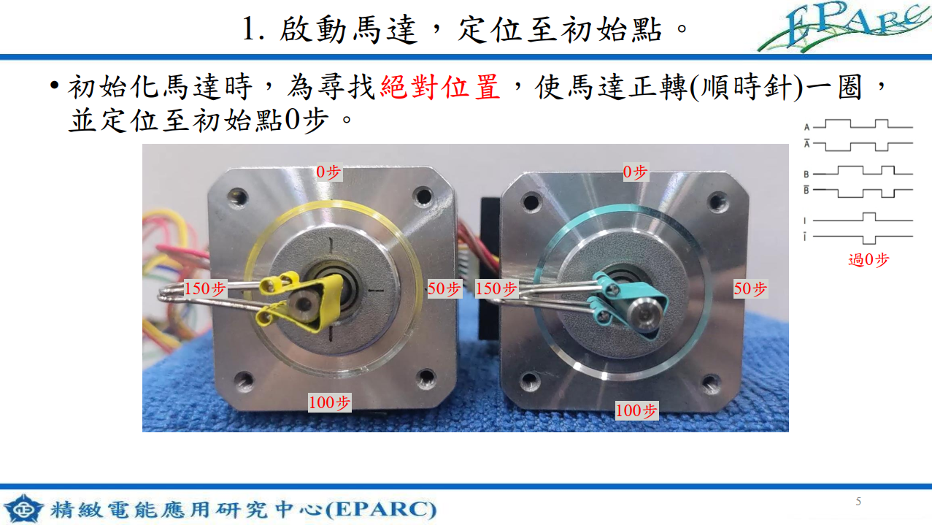
03 韌體控制程式/04 第四季/01_P5_啟動馬達定位至初始點/01_P5_啟動馬達定位至初始點.PNG
