tim7376875/Industry-university-coope-Stepper-motor-drive-circuit-design-and-controlration-/03 韌體控制程式/04 第四季/02_P8_無干擾開回路 -步階響應測試 (60rpm)/02_P8_無干擾開回路 -步階響應測試 (60rpm).PNG

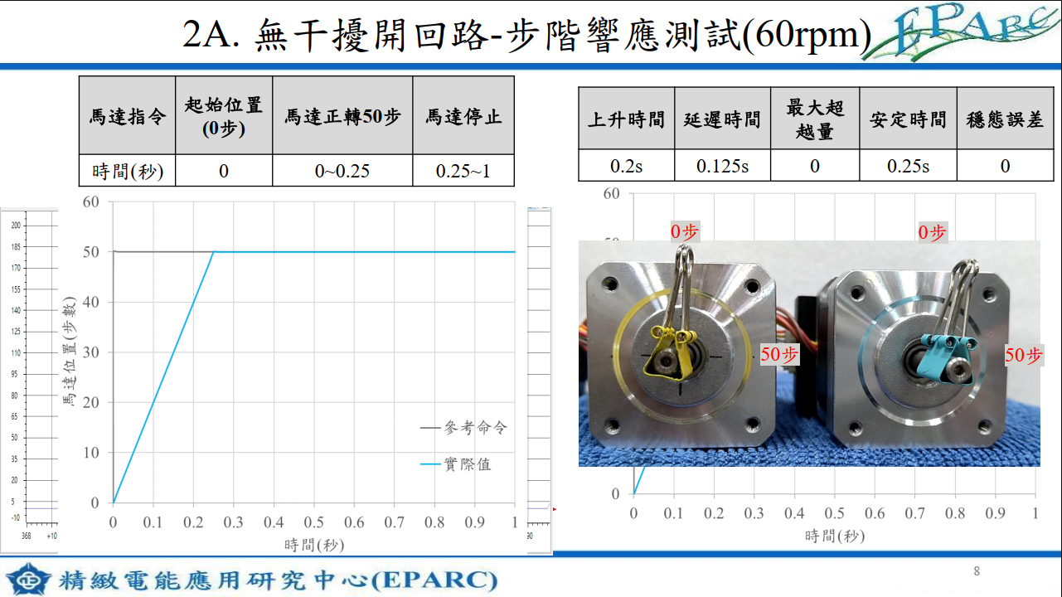
03 韌體控制程式/04 第四季/02_P8_無干擾開回路 -步階響應測試 (60rpm)/02_P8_無干擾開回路 -步階響應測試 (60rpm).PNG
