tim7376875/Industry-university-coope-Stepper-motor-drive-circuit-design-and-controlration-/03 韌體控制程式/04 第四季/05_P15_無干擾閉回路 -步階響應測試 (60rpm)/05_P15_無干擾閉回路 -步階響應測試 (60rpm).PNG

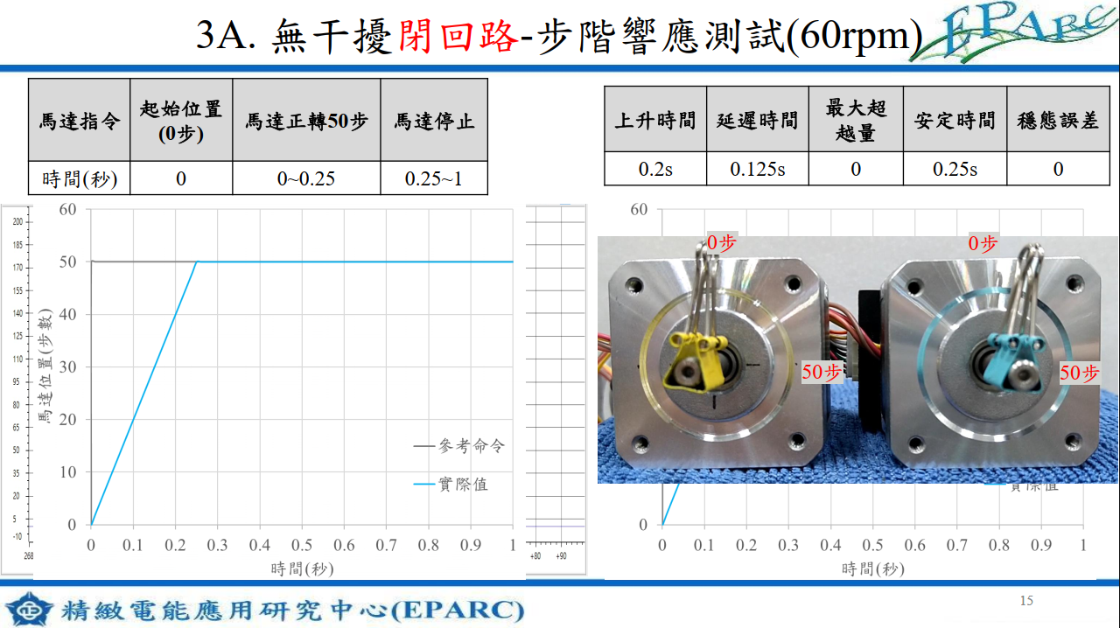
03 韌體控制程式/04 第四季/05_P15_無干擾閉回路 -步階響應測試 (60rpm)/05_P15_無干擾閉回路 -步階響應測試 (60rpm).PNG
