tim7376875/Industry-university-coope-Stepper-motor-drive-circuit-design-and-controlration-/03 韌體控制程式/04 第四季/08_P21_有干擾開回路 -步階響應測試 (60rpm)/08_P21_有干擾開回路 -步階響應測試 (60rpm).PNG

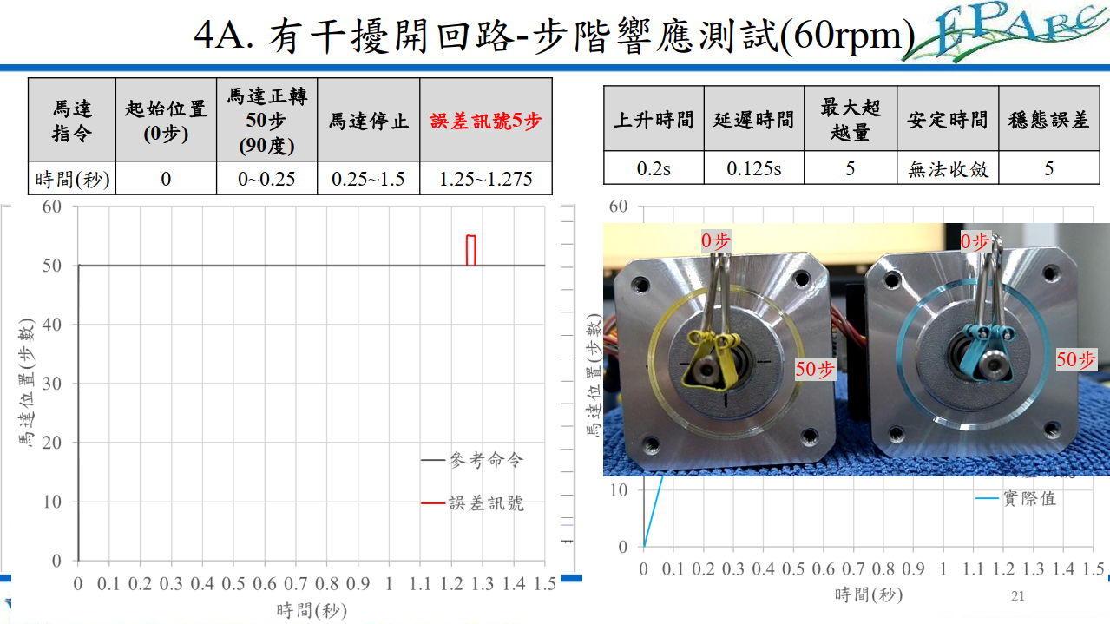
03 韌體控制程式/04 第四季/08_P21_有干擾開回路 -步階響應測試 (60rpm)/08_P21_有干擾開回路 -步階響應測試 (60rpm).PNG
