tim7376875/Industry-university-coope-Stepper-motor-drive-circuit-design-and-controlration-/03 韌體控制程式/04 第四季/10_P24_有干擾開回路 -時變響應測試 (60rpm)/10_P24_有干擾開回路 -時變響應測試 (60rpm).PNG

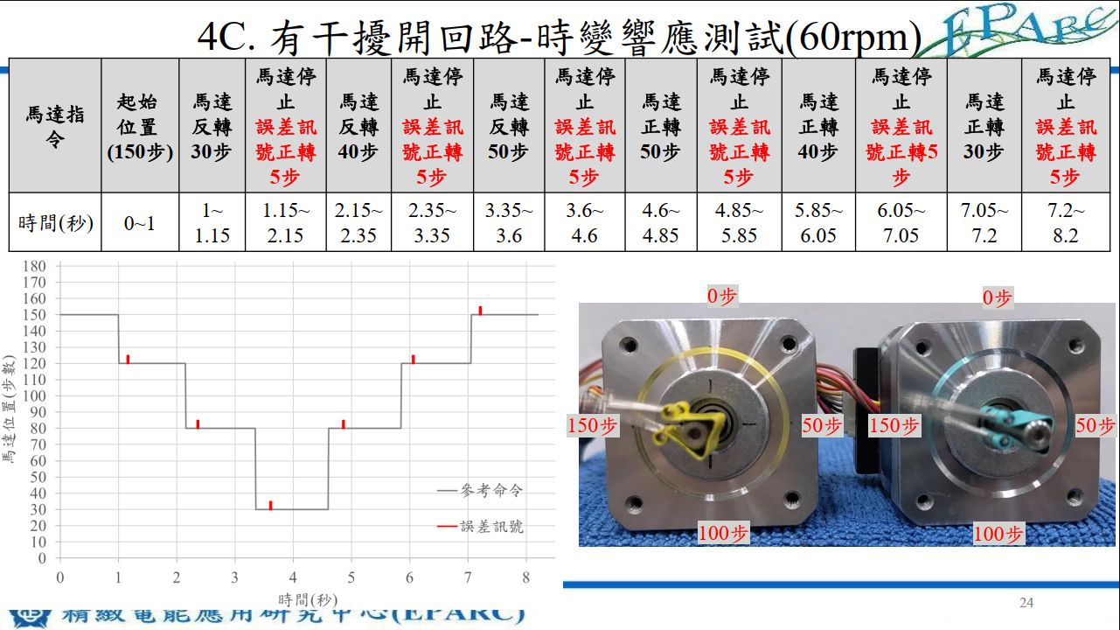
03 韌體控制程式/04 第四季/10_P24_有干擾開回路 -時變響應測試 (60rpm)/10_P24_有干擾開回路 -時變響應測試 (60rpm).PNG
