tim7376875/Industry-university-coope-Stepper-motor-drive-circuit-design-and-controlration-/03 韌體控制程式/04 第四季/12_P28_有干擾閉回路 -時變響應測試 (3rpm)/12_P28_有干擾閉回路 -時變響應測試 (3rpm).PNG

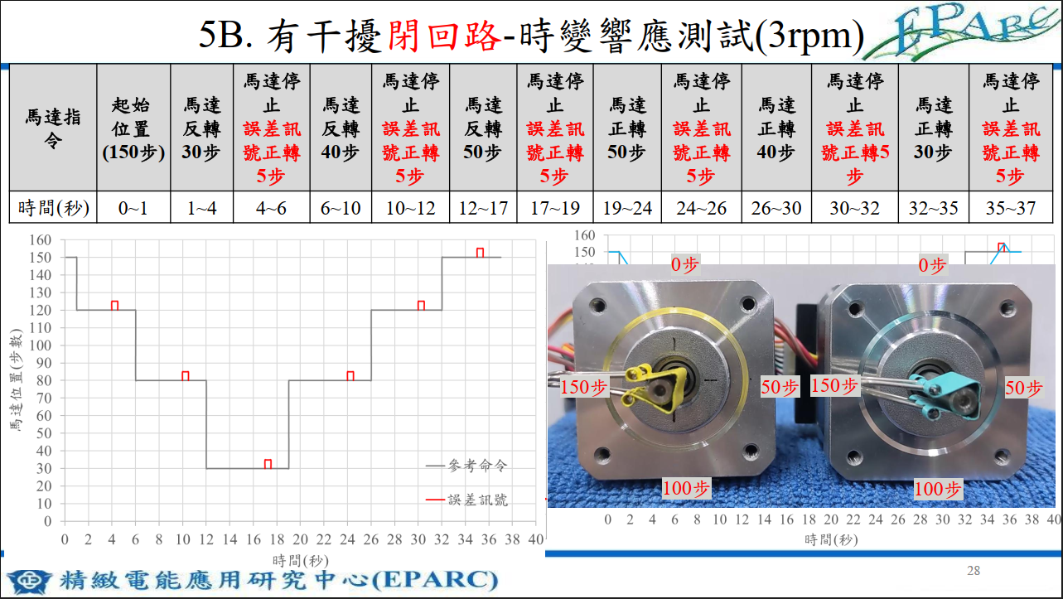
03 韌體控制程式/04 第四季/12_P28_有干擾閉回路 -時變響應測試 (3rpm)/12_P28_有干擾閉回路 -時變響應測試 (3rpm).PNG
