tim7376875/Industry-university-coope-Stepper-motor-drive-circuit-design-and-controlration-/03 韌體控制程式/04 第四季/13_P30_有干擾閉回路 -時變響應測試 (60rpm)/13_P30_有干擾閉回路 -時變響應測試 (60rpm).PNG

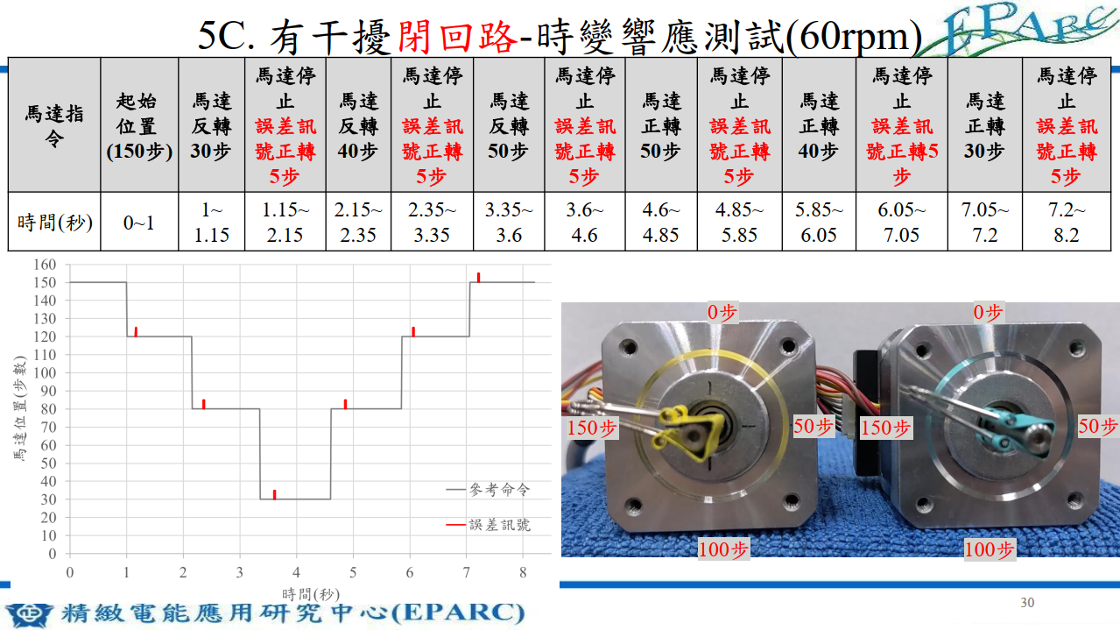
03 韌體控制程式/04 第四季/13_P30_有干擾閉回路 -時變響應測試 (60rpm)/13_P30_有干擾閉回路 -時變響應測試 (60rpm).PNG
