tim7376875/Industry-university-coope-Stepper-motor-drive-circuit-design-and-controlration-/03 韌體控制程式/04 第四季/14_P37_一對八測試/14_P37_一對八測試.PNG

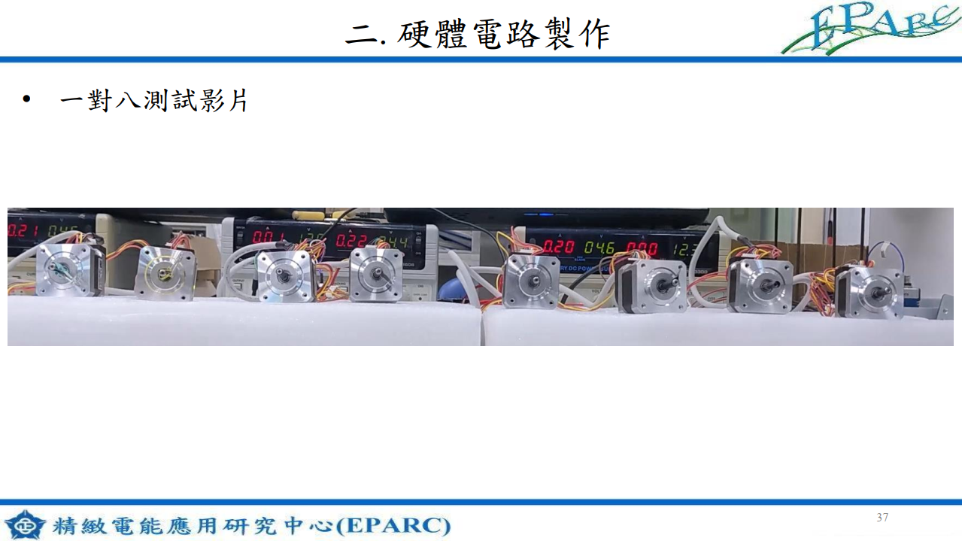
03 韌體控制程式/04 第四季/14_P37_一對八測試/14_P37_一對八測試.PNG
