tim7376875/Industry-university-coope-Stepper-motor-drive-circuit-design-and-controlration-/03 韌體控制程式/05 第五季/09_P30_一對八測試(30rpm)/09_P30_一對八測試(30rpm).PNG

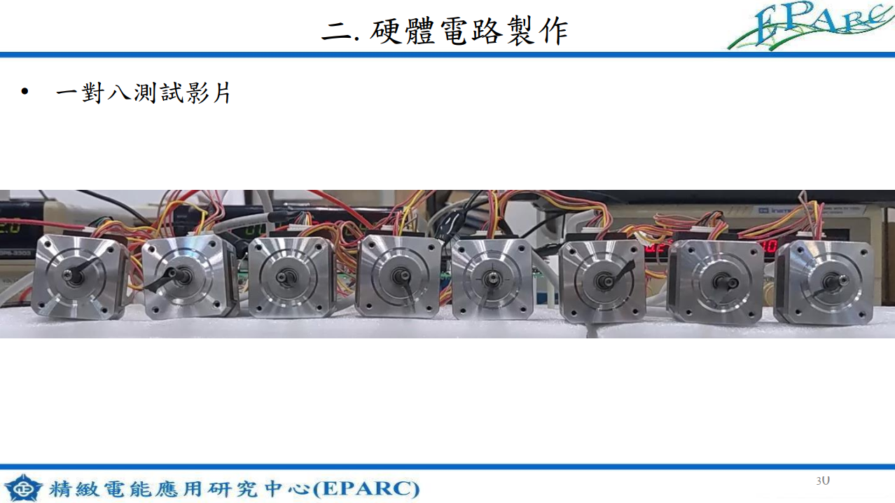
03 韌體控制程式/05 第五季/09_P30_一對八測試(30rpm)/09_P30_一對八測試(30rpm).PNG
