tim7376875/Industry-university-coope-Stepper-motor-drive-circuit-design-and-controlration-/(list of files, drawings)

Other design files:
02 硬體電路Layout/01_第一季/PCB_drv8424.pcbdoc
02 硬體電路Layout/01_第一季/Sheet_1_.schdoc
02 硬體電路Layout/02_第二季/PCB_tms320f28069.pcbdoc
02 硬體電路Layout/02_第二季/Sheet_1.schdoc
02 硬體電路Layout/02_第二季/Sheet_2.schdoc
02 硬體電路Layout/03_第三季/PCB_tms320f28069.pcbdoc
02 硬體電路Layout/03_第三季/Sheet_1.schdoc
02 硬體電路Layout/03_第三季/Sheet_2.schdoc
02 硬體電路Layout/04_第四季/產學1v2.PcbDoc
02 硬體電路Layout/04_第四季/產學sheet1VS2.SchDoc
02 硬體電路Layout/05_第五季/產學sheet1VS8.SchDoc
