tim7376875/Industry-university-coope-Stepper-motor-drive-circuit-design-and-controlration-/03 韌體控制程式/03 第三季/02 P10_ECAP/our_ecap.h

/*
 * our_ecap.h
 *
 *  Created on: 2022/11/2
 *      Author: USER
 */

#ifndef OUR_ECAP_H_
#define OUR_ECAP_H_
#include "DSP28x_Project.h"

void InitECapture(void);
void ECAP_init(void);
void ECAP1_init(void);
void ECAP2_init(void);
void ECAP3_init(void);

#endif /* OUR_ECAP_H_ */
